xixi-2380/fpga-instrument/README.md

# 高山流水 FPGA 乐器：main 整合

已整合32声部、36键、立体声与效果器、触屏箜篌、蓝牙MIDI/Flash曲库、四主题动画彩蛋、中英文、FFT及延迟XY。新增末级音频滤波，修复输入禁用后NoteOff排空；第二旋钮控制音量，超声波控制滑音。

功能和操作见[整合说明](docs/main_integration_20261101.md)。本源码检查点已完成行为回归及高云综合，完整布局布线/时序优化仍在进行，尚无匹配本次源码并通过完整STA的位流。历史位流不能替代本次验收。

工程：`keyboard_adsr.gprj`，器件GW5AST-LV138FPG676AC1/I0（C），69管脚。综合报告与功能证据位于`reports/integration_20261101/`。默认上电不自动演奏。
