xixi-2380/fpga-instrument/docs/hardware_checklist.md

# 实板核验与首轮测量

状态必须区分官方资料、用户确认、工具检查和实测。历史 JTAG 扫描成功，ID=0x0001081B；该 ID 不区分 B/C。本次没有访问 JTAG，当前无声排查先按 bringup_run_leds.md。
FPGA C 版由用户确认。用户背面原图的白色贴纸清楚标注 Version: v4071f3，Dock 修订据此记录为 4071f3；核心板修订号和速度等级仍不可读。C 版与 PCB 修订号分开记录。照片原件及哈希保存在 reports/hardware/photos。

| 项目 | 当前状态 | 完成标准 |
|---|---|---|
| FPGA 型号与器件版本 | GW5AST-LV138FPG676A、Device Version C，用户确认 | 已与工程器件系列及封装核对一致 |
| 速度等级 | C1/I0 为离线构建假设，实物未核实 | 不将基础型号确认自动视为速度等级确认 |
| Dock 修订号 | 4071f3，背面版本贴纸确认 | 已匹配官方 4071f3 图纸；不代替连线与电压实测 |
| 核心板修订号 | 未确认，组装状态照片不可读 | 可用购买资料或厂商依据补充；无需为此拆散热片 |
| 50 MHz/P16 | 官方图依据，未实测 | 核验版本，记录频率和探测位置 |
| BCK E22/WS F24/DIN G24 | 官方 CST + 图纸一致，未实板签核 | 对应实板版本确认 |
| PA_EN H17 | 已匹配实物版本贴纸与官方 4071f3 图 | 核对对应版本、功放 EN 极性 |
| U4 复位 | 官方全 CST 为 LVCMOS15、图中按下高有效 | 验证按键电平，不套音频例程 3.3 V 设置 |
| 电源/IO | 官方音频图 3V3A | 供电、Bank 电压、接地匹配 |
| JTAG | 已扫描到 1 个器件 | 原始日志在 reports/hardware |
| BCK/WS/DIN | 未测 | 1.536 MHz、48 kHz、16 位/声道、无一位延迟 |
| 模拟输出与左右声道 | 未测 | 低幅 440 Hz、左/右独响一致 |
| 30 分钟稳定播放 | 未测 | 记录失锁、欠载、杂音和复位恢复 |

## 下载前

先核对实板版本及完整器件，生成正式 CST、源同步音频输出约束并完成 P&R/STA。
取得对应证据后才能填入 hardware_status.json 的签核项。助手不调用下载器，旧自动下载脚本已清除，由用户自行操作。
只使用 SRAM Program and Verify，不写 Flash，不改板载调试器固件。
离线可行性构建没有已签核 CST，自动分配引脚的 bitstream 绝不能下载。

## 测量顺序

1. 从匹配原理图识别 GND 和可达探测位置；不假定测试点编号。
2. 功放关闭时检查 DAC 引脚处 BCK/WS/DIN，核对电平、边沿和 16 次采样/通道。
3. 连续零码后使能功放，确认模拟输出无异常，再播放低幅正弦。
4. 先双声道同音，再左独响和右独响，核对最终插座通道。
5. 在播放期间复位，观察静音、重锁和帧边界恢复。
6. 连续播放至少 30 分钟，保存时间、仪器精度、测量结果和 bitstream SHA-256。

PT8211 是 Japanese/LSBJ：WS=0 右、WS=1 左，MSB 先行，BCK 上升沿采样。
官方例程的通道注释与芯片手册不一致，本工程依手册实现，仍需左右实测。
当前已有矩阵键盘 Note 输入；历史固定音测量不能证明演奏响应，实板输入到模拟输出延迟仍待测量。
