xixi-2380/fpga-instrument/docs/handoff_2026-10-14.md

# Tang Mega 138K Pro FPGA 电子乐器项目交接

更新时间：2026-10-14。用途：交给新的 Codex 窗口，继续当前工程开发和无声排查。

## 1. 新窗口先了解的现状

项目目录：`E:\gowin\fpga-instrument-mega138k-pro`。

当前工程：`keyboard_adsr.gprj`；顶层：`keyboard_top`；最新源码版本：`D2_keyboard_leds`。

此前 D1 固定 440 Hz 正弦实验，用户反馈“正常发声”。之后接入 4×4 矩阵键盘和单声部 ADSR 的 D2 实验，用户反馈烧录后没有反应、仍没有声音，原因尚未查明。用户目前不在实验室，暂时无法提供测量结果。

最新工作是加入独立流水灯和两个状态灯，便于回实验室后区分参考时钟、音频复位、按键识别问题。源码、约束、工程和操作文档均已修改，相关仿真通过；**最新版本未由助手综合、布局布线或烧录，也没有新生成的 .fs 文件，尚无流水灯实板结果。**

下一步先由用户编译、烧录流水灯版，反馈 LED 状态，再继续定位无声问题。当前不要跳到 32 声部、复杂音色或 UI 开发。

## 2. 用户明确规定的分工

用户原话：“停，你修改文件后由我进行烧录”“综合编译烧录交给我就行”。

- 助手可以修改 RTL、约束、脚本、文档，运行 Icarus/vvp 纯 HDL 仿真，读取已有综合和时序报告。
- **综合、EDA 编译、布局布线、下载、烧录由用户执行。未经明确重新授权，助手不得启动这些操作，也不得访问 Programmer/JTAG。**
- 用户说“继续”不代表重新授权上述操作。工程内存在构建和下载脚本，不代表允许助手执行它们。
- 不修改官方参考文件、原始照片、旧日志或同步资料，不以新结果覆盖历史证据。
- 缺少实测依据时明确注明待验证；不能用仿真成功代替硬件、时序或延迟验收。

先读项目根目录 `AGENTS.md`。ChatGPT 镜像目录下 `sources/` 也只读。

## 3. 开发环境与资料

| 项目 | 位置或说明 |
|---|---|
| 实际工程 | `E:\gowin\fpga-instrument-mega138k-pro` |
| Gowin IDE | `C:\Gowin\Gowin_V1.9.12.04_x64\IDE\bin` |
| Python | `D:\py\python.exe` |
| Icarus/vvp | 工程 `tools\mingw64\bin`，仿真脚本负责调用 |
| 竞赛原要求 | `E:\FPGA竞赛\竞赛要求`，前期已读取 6 张图片 |
| 旧参考工程 | `E:\gowin\fpga-instrument`，保留供参考，不作为当前工程 |
| 官方资料 | 当前工程 `references\` |
| 硬件原始照片 | `reports\hardware\photos\` |

若写入 E: 受到沙箱限制，应走工具的受控权限流程；不要因此改写同步参考资料，也不要扩大到构建或下载操作。

## 4. 硬件身份及确认程度

- 开发板：Sipeed Tang Mega 138K Pro Dock。
- FPGA：用户确认 `GW5AST-LV138FPG676A`，Device Version **C**。
- Dock：用户背面照片贴纸为 **v4071f3**，已匹配官方该版原理图。
- 核心板 PCB 修订号尚未确认；芯片散热片遮挡完整丝印，实际速度等级未确认。
- 工程器件配置 `GW5AST-LV138FPG676AC1/I0` 是当前离线实现假设，不能声称已核对实板速度等级。
- 用户有示波器、耳机，已连接 4×4 矩阵键盘；没有报告其他 FPGA 外设。
- 历史 JTAG 识别记录存在，ID `0x0001081B` 本身不能区分 B/C。后续助手不进行扫描或下载。
- 听到 D1 声音是用户反馈，不等于已有完整的数字接口、IO 电压、模拟幅度和长期稳定性测量。

主要原理图：`references\TANG_MEGA-138K_Dock-4071f3__Schematics.pdf`。六颗普通 LED 依据该图第 15 页；不要猜测引脚。

## 5. 最新接线定义：务必采用修正后的行列

用户后来澄清：**W26 是最上方第一条水平行；W25 是最左方第一条竖直列。** 早期定义曾相反，源码约束和映射测试已修正。

| 索引 | 水平行：从上到下，输入上拉 | 竖直列：从左到右，扫描输出 |
|---|---|---|
| 0 | W26 | W25 |
| 1 | L22 | M24 |
| 2 | Y26 | Y25 |
| 3 | AA25 | AA24 |

选中列输出低，其余列高阻；行输入两级同步。不要把未选列改成主动输出高。键盘为无源八线矩阵，用户确认没有每键二极管。矩形歧义采用保守处理：清除接受键状态、释放音符，解除歧义并消抖后恢复；不承诺任意多键无冲突。

位置到音符的分配如下，以用户定义的上/下/左/右为准，不根据键帽字符猜位置：

| | 第 1 列 | 第 2 列 | 第 3 列 | 第 4 列 |
|---|---|---|---|---|
| 第 1 行 | C4 | C#4 | D4 | D#4 |
| 第 2 行 | E4 | F4 | F#4 | G4 |
| 第 3 行 | G#4 | A4，440 Hz | A#4 | B4 |
| 第 4 行 | C5 | C#5 | D5 | D#5 |

A4 在第三行第二列，对应 **Y26 行、M24 列**。

当前仅有一个声部：新按键优先；同帧多个新增键选最高键号；松开当前键时回退到仍按住的最高键号；全松开进入 Release。未按键时本来就应静音。

## 6. 音频、复位和测量引脚

| 信号 | 实际板级球位 | 已加入的通用 GPIO 镜像 |
|---|---|---|
| 50 MHz 参考时钟 | P16 | 无 |
| 用户复位，高有效 | U4，LVCMOS15 | 无 |
| PT8211 BCK | E22 | U22 |
| PT8211 WS | F24 | V19 |
| PT8211 DIN | G24 | W20 |
| PA_EN | H17 | U26 |

GPIO 镜像是用户指定的排针位置，便于示波器测量；原 DAC 引脚仍正常连接。地夹接明确标注 GND 的位置，不能把同排其余孔当作地。

当前实际时钟方案是 **50 MHz → 32 MHz → 61.44 MHz** 两级 PLL，以 `config\synth_config.svh` 和 `boards\mega138k_pro\pll_pair.sv` 为准。早期计划中的 50→96→61.44 MHz 已不是当前实现，不能照搬。

- 48 kHz 标称采样，每帧 1280 个音频主时钟周期。
- BCK 1.536 MHz，主时钟每 20 周期翻转一次；每通道 16 位，每立体声帧 32 位。
- 内部使用主时钟和时钟使能；BCK 只是寄存器输出，不作为内部组合派生时钟。
- PT8211 使用 Japanese/LSBJ 格式，16 位补码、MSB 先行、BCK 上升沿采样；WS 低为右声道，高为左声道。不要误改成带一位延迟的 Philips I²S。
- DDS 32 位相位，4096×16 有符号正弦 ROM；440 Hz 频率字 `32'h0258BF26`。
- 初始峰值增益 1/32。PLL 锁定资格判断至少 2 ms，启动 480 帧零码、功放开启、240 帧淡入。
- ADSR：Attack 10 ms，Decay 100 ms，Sustain 约 70%，Release 200 ms；重按从当前包络值起音。
- 键盘每列 50 μs、整轮 200 μs，切列后等待 10 μs，稳定 15 轮，消抖约 3 ms。

## 7. 新增流水灯的行为和工程入口

打开 `E:\gowin\fpga-instrument-mega138k-pro\keyboard_adsr.gprj`，顶层 `keyboard_top`。建议先关闭再重新打开 IDE 工程，使新增源文件和输出配置载入。

当前输出基名为 **D2_keyboard_leds**，用户编译后预期文件：

`E:\gowin\fpga-instrument-mega138k-pro\impl\pnr\D2_keyboard_leds.fs`

该路径是预期输出，不能据此认为已有新文件。旧 `D2_keyboard_adsr.fs` 不包含流水灯和最新源码变更。旧文档 `docs\bringup_keyboard.md` 某些段落仍使用旧输出名，当前以 `docs\bringup_run_leds.md` 和工程配置为准。

| 普通橙色用户灯 | 球位 | 含义 |
|---|---|---|
| LED0 | J14 | 与 LED1～3 轮流亮 |
| LED1 | R26 | 同上 |
| LED2 | L20 | 同上 |
| LED3 | M25 | 同上 |
| LED4 | N21 | 音频复位解除、音频域就绪时亮 |
| LED5 | N23 | 音符门控有效时亮 |

全部低电平点亮。LED0→1→2→3→0，每颗 250 ms，一圈 1 秒，直接使用 50 MHz 参考时钟，独立于音频 PLL、用户复位、键盘和功放。重新配置或上电从 LED0 开始；按用户复位也继续流水。

LED4/5 分别通过两级同步进入参考时钟域。LED5 不是音量指示灯，松键后可以灭，而 200 ms Release 尾音仍在播放。这里不是 POWER/DONE/READY 指示灯，也不是 WS2812。

官方通用全引脚 CST 对 LED0/1 的名称顺序与 4071f3 原理图相反；本实现按匹配板版的原理图，**LED0=J14、LED1=R26**。不要仅为对齐旧全引脚 CST 名称而换回去。

## 8. 已完成的仿真与证据边界

| 检查 | 已有结果 | 不能证明的内容 |
|---|---|---|
| 流水灯独立 TB | PASS，111 项检查 | 实板运行、实现后时序 |
| 最新板级 `tb_keyboard_top --vendor` | PASS，329180 项检查 | 实际晶振、实际 PLL 布线和电气 |
| 物理键盘引脚开关模型 | 当前/旧方向各 PASS 34 项 | 真实线序、接触、上拉电平 |
| 历史 D2 综合网表功能仿真 | PASS，22112 次串行帧检查 | 测试旁路 PLL，不能证明实板 PLL 工作 |
| 历史生产扫描参数延迟仿真 | 首个非零串行码约 3.135 ms | 实板输入到模拟输出延迟 |

行列转置模型显示：旧方向仍可产生按键与音频，只是音符位置转置。因此不能宣称“修正行列已经解决完全无声”。

已有旧 D2 综合/布局布线报告保留作历史证据；最新修正行列及流水灯版尚未实现，不得沿用旧资源/时序报告作为新源码通过证明。最新板级 24 个物理端口位的球位唯一性检查通过。

只运行仿真时可在工程根目录使用以下命令；不需要也不要自动执行构建脚本：

```powershell
Set-Location -LiteralPath 'E:\gowin\fpga-instrument-mega138k-pro'
& 'D:\py\python.exe' scripts/run_sim.py --test tb_run_leds
& 'D:\py\python.exe' scripts/run_sim.py --test tb_keyboard_top --vendor
& 'D:\py\python.exe' scripts/run_keyboard_pinmap.py
```

按改动范围补跑独立模块 TB。已通过且源码未变化的测试无需反复重跑。

## 9. 回实验室后的排查顺序

由用户确认重新编译的是上述工程、顶层和输出名，检查实现报告并保存下载校验日志，然后逐步记录：

1. **四灯是否每 250 ms 循环。** 不循环时先核对实际烧录文件、下载结果、供电和参考时钟，不能直接认定键盘模块故障。
2. **LED4 是否亮。** 流水正常但 LED4 始终灭，优先查复位输入、PLL 锁定及复位释放。
3. **单按 A4 时 LED5 是否亮。** LED4 亮但 LED5 不亮，查实际行列接线、列扫描和行输入；不按键时 D2 静音是预期行为。
4. **LED4/5 都亮但仍无声时测音频。** U22 应有 1.536 MHz BCK，V19 应有 48 kHz WS，U26 启动后应高，W20/DIN 应随按键产生非零数据。继续查 DAC、功放及模拟输出。
5. 如需测键盘，行 W26/L22/Y26/AA25 空闲应高；按住第一行第一列时观察 **W26**，应出现约 50 μs 低脉冲，周期约 200 μs。W25 是第一列扫描输出，不能再按旧文档当成第一行输入。

用户暂不在实验室时，完成可独立进行的文件核对和仿真即可，保留硬件待办，不编造测量结果，不提前要求其立刻操作。

若回退 D1 固定音验证，保留当前键盘和流水灯工程，不覆盖历史已知可发声版本；综合和下载依然由用户执行。

## 10. 关键文件索引

以下均相对于实际工程根目录：

| 文件 | 用途 |
|---|---|
| `AGENTS.md` | 操作权限和工作规则 |
| `docs\bringup_run_leds.md` | 最新用户上板操作说明 |
| `bringup\README_manual.md` | 当前流水灯版操作说明副本 |
| `docs\bringup_keyboard.md` | 键位、ADSR、扫描说明，输出名有历史旧值 |
| `boards\mega138k_pro\keyboard_top.sv` | 当前板级顶层 |
| `boards\mega138k_pro\keyboard.cst`、`keyboard.sdc` | 最新引脚和时序约束 |
| `impl\keyboard_adsr_process_config.json` | Gowin 过程配置，输出名 D2_keyboard_leds |
| `rtl\run_leds.sv`、`config\run_leds_config.svh` | 新增流水灯和周期参数 |
| `rtl\matrix_keypad.sv` | 扫描、同步、消抖、鬼键处理 |
| `rtl\mono_note_control.sv`、`adsr_envelope.sv` | 单声部 Note 选择和包络 |
| `rtl\keyboard_core.sv` | 按键到音频集成 |
| `config\synth_config.svh`、`keyboard_config.svh`、`keyboard_notes.svh` | 时钟、位宽、扫描、包络和频率表 |
| `rom\sine4096.hex` | 正弦 ROM 初始化 |
| `reports\keyboard\run_leds\validation.json` | 最新流水灯仿真、引脚表和源码哈希 |
| `reports\keyboard\pinmap_correction\` | 当前/历史方向的物理开关仿真证据 |
| `reports\keyboard\netlist_check\` | 历史网表仿真证据，PLL 旁路 |
| `reports\keyboard\diagnosis_2026-10-14.md` | 无声排查记录，末尾已说明行列更正 |
| `boards\mega138k_pro\hardware_status.json` | 用户反馈、权限与硬件待验证状态 |
| `docs\change_log.md`、`interfaces.md` | 变更和后续接口约束 |

状态 JSON 中某些保守验证字段仍为 false，属于没有仪器证据的项目；某些 profile 字段保留历史名字。不要据此忽略 `user_D1_report=正常发声`，也不要把用户听感扩大为完整验收。当前源码版本看 `latest_source_variant=D2_keyboard_leds`。

## 11. 项目最终目标及后续阶段

最终比赛目标是纯可综合 Verilog/SystemVerilog 实时音频链路，不依赖 CPU、软核或外部 MCU 进行实时合成。要求 48 kHz、32 个独立逻辑声部、每声部相位/频率/ADSR/音色、固定时隙混音和饱和输出，至少 2 种音色、目标 6 种，PT8211 输出，动态分配和 Note On/Off，输入到输出不超过 10 ms、目标低于 5 ms；竞赛原图还要求至少两个独立演奏维度。

目前完成的是单正弦和单声部键盘实验，**尚未完成 4/32 复音、多音色、FM、效果器或多维控制验收**。配置里 `VOICE_COUNT=32` 只是未来统一参数，不等于已经有 32 声部实现。

无声基础问题解决并取得实板证据后，再按 4 声部→32 声部→多音色→效果器→扩展控制/显示推进。保持 32 位相位、12 位波表地址、24 位声部、40 位混音、16 位 DAC 接口；32 声部调度应满足 `32 × slot_cycles + overhead ≤ 1280`。模块采用清晰握手，跨域使用可靠同步或原子握手/FIFO，禁止组合派生时钟和实时浮点，每模块有独立 TB，修改记录功能、接口、仿真与已知问题。

## 12. 可直接发给新窗口的启动指令

> 请先读取本交接文档及 `E:\gowin\fpga-instrument-mega138k-pro\AGENTS.md`，继续当前 Tang Mega 138K Pro C 版工程。当前键盘 D2 仍无声，最新 D2_keyboard_leds 已加入流水灯并通过仿真，尚待我自行编译和烧录。综合、布局布线和烧录全部由我负责，你只能改文件、运行 HDL 仿真和读取报告。沿用修正后的行 W26/L22/Y26/AA25、列 W25/M24/Y25/AA24。先核对现有状态，再根据我提供的流水灯、LED4/5 和测量结果定位无声，暂不扩展复杂功能，也不要声称已解决。
