xixi-2380/fpga-instrument/android/README.md

# PCB / Flash诊断App 0.3.3

本次APK为`GaoshanScore-0.3.3-pcb-flash-debug.apk`，versionCode6，保持原开发证书。生产RTL同时更新后，空闲诊断实际刷新Flash，SAVE/DELETE重新探测，任务等待180秒，RAM完成与Flash持久确认分开显示。实际手机无线/硬件擦写验收仍由用户执行。

本地SDK现位于本副本`android/build-local/sdk`，JDK17位于`android/build-local/jdk17`。从工程根目录运行`python android/build_apk.py --sdk-root android/build-local/sdk --out-dir android/build-local/pcb-flash-debug`；先把该JDK的bin加入当前进程PATH。保持输出目录里的开发密钥以兼容已有App。SDK、JDK和密钥均只在本地忽略目录，不提交Git。

完整交付见`dist/pcb-flash-debug`及`docs/PCB与Flash修复_2026-10-28.md`。

---

2026-10-27 新增 0.3.1-flashdiag（versionCode 4），与0.3同签名：增加“读取Flash诊断”与准确的RAM/Flash分阶段错误，详见[Flash检查记录](../docs/flash_link_2026-10-27.md)。下方0.3等记录是历史。新包路径 dist/GaoshanScore-0.3.1-flashdiag.apk。

# 高山流水曲谱 · 安卓开发版 0.3

2026-10-25本地扩展：`dist/GaoshanScore-0.3-dev.apk` 沿用0.2签名、版本号3。保留“连接模块”和“验证FPGA”两个入口，增加16声部/4096条能力检查、32首琴端目录及保存/加载/删除/任务查询。新包仅完成软件测试和构建签名，未做手机运行或真实Flash验收；下方0.2的用户实测反馈属于旧检查点。

下载流程先完成RAM COMMIT，再在曲库已初始化且可写时自动保存到选定编号，替换该编号旧曲；分别显示“RAM已校验”“正在保存Flash”“已持久保存”。未知/受保护Flash或旧固件只下载RAM并明确断电不保留。旧固件0x40未知命令后会话仍可用。保存任务可停止等待，但不能把已发起的Flash任务说成已取消。

新增曲库区可刷新32项目录、保存当前RAM、加载与删除选中项；加载不会自动播放。删除先确认，所有存储操作须停止播放。若任务应答丢失、断线或关闭App，会在本机私有SharedPreferences保留最近未完成任务的模块标签（含地址）、任务号或发送意图、操作/编号/CRC；重连原模块后查询。已知完成/失败后清除此记录；FPGA复位或任务替代可能明确返回结果未知，须核对目录。不会自动重发一个新任务来猜结果。

手机仍无INTERNET权限，不上传诊断，不持久存储导入MIDI或完整曲库。上述未完成任务标识是相较0.2新增的本地持久数据；下方旧“不保存蓝牙地址”的描述仅属于0.2。离线演示仅为手机内参考模型，模拟曲库关闭后不保留，不证明FPGA或Flash通过。

操作、引脚、MIDI示例与完整新协议见[曲库上板操作](../docs/bluetooth_score/曲库上板操作.md)、[曲库扩展协议](../docs/bluetooth_score/曲库扩展协议.md)。0.2 APK和以下历史说明保留，用于旧固件与问题追溯；当前使用0.3请以上述新增流程为准。

本机重编译沿用0.2密钥的实际命令为 `python android/build_apk.py --sdk-root android/build-local/sdk --out-dir android/build-local/connection`（工程根目录执行）；密钥只在本机忽略目录中保留，不随源码/APK分发。新0.3已完成36043项核心、32项连接和33项曲库/示例软件检查，签名及哈希见reports/library_integration/validation.json；这些不是Android运行验收。

## 0.2历史交付记录

本目录移植自原手机端开发项目。本轮按用户确认合并实施P0/P1，并将“仅连接蓝牙模块”和“验证FPGA通信”分成两个手动验证入口。APK已重新构建，36043项核心检查与32项连接生命周期检查通过。随后用户已确认实际连接、通信、MIDI文件下载播放、暂停和停止正常；这是用户定性反馈，不覆盖继续、自然结束、断线或长期验收。当前FPGA已接入v1协议，工程边界见[实施说明](../docs/bluetooth_score/实施说明.md)。

## 先验证连接与握手

1. 安装 `dist/GaoshanScore-0.2-dev.apk`。新开发签名与旧0.1不同，需要先卸载旧版再安装；旧版不保存用户曲谱库。新签名密钥保留在本机忽略的build-local/connection目录，不对外分发。
2. 允许附近设备权限；本版会停止系统蓝牙发现以减少建连干扰，但不主动扫描周边设备。若仅授权连接，也会提示跳过停止扫描并继续尝试。
3. 第一步点“连接蓝牙模块”，选择已配对模块。默认先安全RFCOMM，失败并关闭旧Socket后尝试insecure兼容连接，每次最多12秒。也可在连接方式中单独选择一种模式作对照。
4. 界面显示“模块已连接 · FPGA尚未验证”后，先观察模块实际连接状态、保持、断开和重连。这一步不会发送HELLO或其他应用层协议字节，不以FPGA应答作为连接成功条件。
5. 第二步手动点“验证FPGA通信（HELLO）”。正确HELLO后再GET_STATUS，显示设备能力和真实状态，随后开放下载/播放控制。
6. HELLO失败但Socket仍正常时保留模块连接，可再次点击验证；真正EOF、读写失败或连接关闭则显示未连接，并关闭设备操作入口。不会无限自动重试或把握手失败冒充建连失败。
7. 若仍不能连接，点“复制诊断记录”。记录包含版本、设备、连接模式、阶段、时间、异常以及握手TX/RX摘要；详细异常堆栈同时写入Gaoshan-SPP的Android日志。记录仅本地展示/复制，不上传。

用户已确认当前 App 可以连接模块并完成通信与曲谱下载。连接/断开10轮和异常恢复仍属后续验收；测试时先关闭其他串口软件对该模块的连接。

## 当前交付

`dist/GaoshanScore-0.2-dev.apk` 是当前开发版，声明最低Android8.0/API26，target35；已完成Java编译、D8转换、资源链接、对齐及v2/v3签名校验，并获用户上述实测反馈。旧 `GaoshanScore-0.1-dev.apk` 保留作为历史产物，不是本轮交付。

助手未操作手机、接线或烧录；以下为当前操作说明。历史构建报告中的“尚未真机测试”保留其生成时状态，以本页后续用户反馈区分。

## 手机界面与操作

1. 可以先点“离线演示”。顶部明确显示“离线演示 · 未连接FPGA”；能力来自手机内参考模拟器，不是实测。
2. 点“三音符示例”，得到C4/D4/E4、力度100、时长1900ms的黄金曲谱；或者用系统文件选择器导入.mid/.midi。
3. 导入后选择全部或单一轨道、全部或单一通道、-48～+48半音移调；点“应用筛选与移调”。无需输入电脑路径。
4. 查看音符数、时长、最大同时发声数、MIDI音域、数据大小、CRC32。遇到被忽略控制器时会显示“简化演奏”提示，并在下载确认中列出。
5. 点“下载到琴”，确认替换原曲。进度只随确认的记录数前进；100%数据已传不等于完成，COMMIT与时长核对后才显示成功。
6. 播放/暂停/继续/停止后查询一次设备状态；也可点“刷新设备状态”。查询间隔至少500ms。暂停的实际行为由FPGA实施，模拟模式只演示协议状态。
7. 离线演示不通过Android音频系统发声，不驱动FPGA；它不是音质试听或链路测试。

## 后续真实连接

- 在系统设置中配对经典蓝牙SPP模块，再点“选择蓝牙设备”；App不扫描周边设备，不要求位置权限，不支持BLE串口。
- Android12及以上按系统提示授予“附近设备”连接与扫描控制权限；扫描权限用于cancelDiscovery，不启动设备发现、不申请定位。拒绝连接权限后可用离线演示，也可在系统设置修改权限。
- 固定SPP UUID 00001101-0000-1000-8000-00805F9B34FB；模块固件是否提供该服务仍需实物确认。
- 手机SPP没有UART波特率设置；模块已由用户确认数据模式9600bit/s，FPGA UART须相同。HELLO显示FPGA报告的配置，不自动发送AT指令。
- “真实蓝牙 · HELLO已确认”只会在完整HELLO成功后出现。本分支 FPGA 已实现 HELLO/下载/播放，生产配置声明 1024 条记录、1 个自动声部；用户已确认 EC05 实际连接及通信正常，协议仿真本身不代表无线连接成功。
- App当前面向前台使用，无前台服务或后台持续传输承诺。关闭Activity将关闭socket；重新连接必须HELLO并从头上传。
- 如中断时设备仍在上传，固件须按协议30秒清理，或下次HELLO立即清理；手机不能假装已经恢复旧曲。

## MIDI支持边界

- 标准MIDI Format0/1、PPQN；默认500000μs/四分音符；Format1全局合并速度图，筛选轨道仍保留全曲速度图。
- 支持变长delta、running status、Note On/Off、velocity0结束、通道+音高FIFO配对的同音高重叠。
- 以整数精确累积速度/时间，开始和结束分别取最近毫秒，0.5ms向上；按起音时间排序，相同起音保留原先稳定次序。
- 支持全部或单一轨道、全部或单一通道；暂不支持任意多选组合或自动提取主旋律。
- 忽略踏板、弯音、程序/表情等控制，检测后必须确认简化；不宣称还原原MIDI音色。
- 拒绝Format2、SMPTE、缺失配对、非法长度、冲突速度、舍入后零时长、音符超过65535ms、协议总时长/音域超限等；不静默截断或丢音。
- 文件最大2MiB，音符/速度事件最多100000；设备容量来自HELLO，不能将模拟器的1024条/4声部/MIDI48～83当成实板能力。
- 不支持PDF、图片、MP3识谱、在线曲库或账户系统。歌曲名留在手机，不通过v1传输。

## 协议实现

纯Java核心位于app/src/main/java/cn/whu/gaoshan/core。
Wire负责小端帧、CRC16/CRC32、拆帧/粘帧与超时；ProtocolClient负责HELLO、停等序号、最多4次相同请求、响应匹配、16记录分包、ABORT与播放命令；Score负责容量/音域/最大重叠检查；MidiFile负责转换；SimulatedDevice只用于离线参考演示。

只有一条后台工作队列可以提交命令。接收线程持续读socket，4096字节队列溢出或EOF明确使会话失败。写入看门狗10秒、连接超时15秒；响应每次2秒，最多4次发送。断开按钮直接关闭socket，不等待工作队列。
错误业务响应消耗普通序号；SEQ_CONFLICT/版本/内部错误及响应耗尽会使协议会话失效，须重新HELLO；蓝牙链路仍正常时可点第二步重验，真实链路故障才需重连。改参数不能复用旧SEQ。取消在当前帧完成后发ABORT，通信失败时不谎报已取消琴端事务。

模拟器不是完整FPGA规范实现：它没有UART采样、RF链路、30秒上传超时、真实ADSR尾音或真实音频，也不证明GPIO/CDC/STA正确。

## 源码编译

方式A：Android Studio打开本android目录，安装Platform35和相应SDK，使用JDK17。项目AGP8.7.3、Gradle8.9，wrapper来自Gradle官方v8.9.0，首次使用需联网获取工具依赖。

```text
Windows: gradlew.bat assembleDebug
Linux/macOS: ./gradlew assembleDebug
```

本次实际交付APK采用方式B构建，未在此环境完成Gradle/Android Studio构建。构建实际使用javac8编译Java8源码、Java21运行D8和签名器；Platform35_r02与Build-tools35.0.0来自Google官方仓库并按仓库SHA1校验。构建日志、工具路径及源码/APK哈希见 `reports/android_connection`：

```text
python build_apk.py --sdk-root 你的AndroidSDK路径 --out-dir build-local
```

方式B要求JDK17、Platform35、Build-tools35.0.0；仅使用javac/D8/aapt2/zipalign/apksigner。路径作为独立参数传递，支持带空格路径。
生成开发测试签名，私钥保留在本机build-local，不随包发送。自行重编译签名不同时需要卸载旧开发包再安装；该包不是商店发布或正式签名版。

## 软件验证

```text
python run_core_tests.py --out-dir ../reports/bluetooth/local_android_core
```

需要可用JDK，不需要Android SDK。包含36043项核心检查：CRC、黄金请求、0～256载荷及各分界、坏帧/超时、MIDI变速/重叠/筛选/舍入、设备约束、1024音符64包上传、BEGIN/DATA/COMMIT/PLAY确认丢失后的重传去重、取消/暂停/重新HELLO。另有32项连接状态检查：连接零协议字节、单独HELLO、握手失败保留连接、重验成功、安全失败兼容回退、强制模式、取消/超时、过期Socket和回调、真实链路故障通知；使用假传输，不证明Android蓝牙栈兼容性。
参考模拟器与真实ProtocolClient运行端到端软件测试，但没有运行安卓Activity或手机权限流程。APK签名/清单核验也不是安装或真机测试。

## 无网与隐私

App不声明INTERNET权限，没有广告、分析、云上传或在线曲库。用户通过系统文件选择器选定MIDI；不申请全盘存储权限。本版不持久化用户文件、蓝牙地址或上传进度。
# 2026-11-02 鼓键与锣声近似

新增 `android/dist/GaoshanScore-0.5-percussion-20261102.apk`：默认保留第10通道，接受GM1的47个鼓键并规范化到琴端原有10种鼓音；可选52中国镲+41低鼓的双层锣声近似，默认关闭。旧固件无需新增音色ID或资源。它不是47种独立采样，GM1也没有专用锣键；完整映射、示例、复音限制及签名安装限制见 [GM鼓与锣声近似](../docs/bluetooth_score/GM鼓与锣声近似.md)。

本机使用 `D:/PyCharm 2025.2.4/jbr/bin` 的JDK，以及本工程 `android/build-local/sdk` 的官方Android35平台和35.0.0构建工具。生成命令为 `python android/build_apk.py --sdk-root android/build-local/sdk --out-dir android/build-local/percussion-20261102 --version-code 8 --version-name 0.5-percussion-20261102`；先给PATH加入该JDK。可用 `--keystore <原有开发私钥>` 保留升级签名。本次旧私钥未找到，新APK使用独立开发证书，不能直接覆盖安装旧0.4。没有执行安装或卸载。

核心与FPGA兼容回归入口为 `python scripts/run_power_guard.py -- python scripts/run_percussion_adjustment_tests.py`。生成的示例MIDI在 `android/examples`；证据在 `reports/adjustments_20261101/percussion`。以下保留此前版本说明。
