xixi-2380/fpga-instrument/reports/adjustments_20261101/xy/README.md

# 实板 main 7d84ac3 基线：延迟 XY 独立复核

**结论：当前没有复现出 `lissajous_plot.sv` 的算法或双缓冲错误，因此未修改生产 RTL。** 本项没有引入旧优化候选，没有改变画面、XY 延迟、时钟或资源结构，没有运行 EDA。

用户尚未提供异常画面或触发步骤。本报告验证的是目前能具体检查的边界，不能据此声称已排除所有实板显示问题，也不把没有复现的问题标为已修复。

## 独立数学参考

新增 `scripts/check_xy_adjustment.py`，使用精确整数比例生成每条线的参考：沿较长坐标轴逐点推进，另一轴按准确比例四舍五入，半格朝本线起点外侧取整。参考没有复用 RTL 的 Bresenham 误差更新，也没有沿用原先仅三幅波形的 Pillow 检查。

| 检查 | 覆盖 | 结果 |
|---|---|---|
| 实际 RTL 线段与写地址 | 64×64 个绝对跨度、四方向共 16,384 条；另加 8,192 条随机平移端点，共 24,576 条/960,419 个绘点 | 2,971,369 项通过，包括字节坐标测试 |
| 原始字节有符号坐标 | 所有 256×256 组输入；检查实际 LOAD 映射 | 65,536 组全部通过 |
| 完整延迟波形 | 64 幅，包括零、正/负满幅、极值交替、正弦、斜坡和 56 幅固定种子随机波形 | 全部与独立 64×64 数学位图一致 |
| 帧/双缓冲/读取 | 在 CLEAR、LOAD、SETUP、DRAW 忙时插入 start/tick；等待帧期间继续读旧前台；同拍发布并启动下一帧；持续随机读取及全图扫描 | 4,495,868 项检查全部通过 |
| 复位、静音与边界 | 五个工作阶段分别复位，重新构建静音；ready 失效、读取关闭、旧 RAM 覆盖及前后台写入隔离 | 全部通过 |

**总计 7,467,237 项检查通过。** 原始 signed-byte 坐标到 `[0,63]` 的转换正确，极端线段不会绕边或卡死；实际最大误差寄存器绝对值为 93，原有有符号 8 位足够。每条线最多 64 个绘点。一次完整构图保持原有 4096 点清理及有界连线过程；没有发现需要增加位宽或 RAM 的理由。

输入波形在 start 时锁存，随后改变输入不会污染正在构建的图。旧前台保持可读，完成的后台只在 frame_tick 发布；同拍发布/start 将旧前台作为新后台。任何可见前台都不会被清理/绘制写入。复位使 ready 失效，新图完成前不会泄漏旧 RAM。零信号被下一幅完整静音图替换为 `(32,31)` 中心单点，不保留前一幅曲线。

## 屏幕连接只读检查

主代理负责屏幕/超声波修改，本项没有改 `rgb_ui_renderer.sv` 或 `rgb_display.sv`。只读检查确认：

- `audio_visualizer` 每四个有效 PCM 采样取一个 signed 高字节，完整快照为 128 点。
- `phase_plot` 接原波形状态 `[1111:88]`，Y 轴比 X 轴早四个快照点，仍等于原单声道 **16 个音频采样**延迟。没有改成 L/R 声道图。
- 普通主题将 64×64 位图放大到 x=376～503/y=170～297，隐藏主题保持 x=680～743/y=172～235。原边界门控和坐标缩放一致。
- 位图像素为同步一拍读出；渲染器在下一阶段叠加到同一坐标的前景色，和既有像素管线相位一致。
- frame-locked 状态桥与绘图模块同拍更新时，绘图可能使用上一份完整波形快照，意味着一帧级观察延迟，不是半帧撕裂或错误坐标。没有据此改变原显示行为。

这些连接检查属于源级审阅；新数学/缓冲测试直接执行了实际绘图模块，不等于重跑整套 RGB/LCD 实板验收。若实板异常仍出现，异常图、对应输入音色/频率和触发页面切换步骤可用于继续定位；当前保留用户已实板成功的实现。

## 文件与复现

- 生产 `src/lissajous_plot.sv` 保持与实板基线逐字节一致，SHA256：`8fb5035e3c956c5154da790bdba16cd0a4ae820ec0da4d0b925a7476c6a8ddad`。
- `validation.json` 记录源码/脚本、测试台及参考输入/位图哈希和执行结果；`review.json` 记录只读连接结论与基线身份。
- 在新 adjustments 工程根运行：`python -X utf8 scripts/check_xy_adjustment.py`。只需要 Python 标准库和现有外部 Icarus，不需要 Pillow、NumPy 或 EDA。
- 测试输出只写 `reports/adjustments_20261101/xy`；没有修改旧项目或旧候选。
