xixi-2380/fpga-instrument/reports/audio_analysis/2026-10-26/README.md

# 2026-10-26 实时分析验证

15项纯HDL配置，共23227101检查全部通过。基线main7e0aaec；源码检查点9f468ea，最终源文件哈希见validation.json。

- NumPy独立FFT8窗口、16936核对，最大实/虚分量误差8.002360751归一化PCM LSB；单音相邻频点、双音、32独立FFT峰、负满幅DC、脉冲、750Hz、零输入。分组/对数打包一致，忙时输入不破坏结果，中途复位后重新完整采集为零。窗口计算耗时记录为[93439, 93439, 93439, 93439, 93439, 93439, 93439, 93439]时钟（非物理时序验收）。
- 独立Pillow完整XY位图32776检查，含旧银行保持、帧边界交换和复位恢复。
- 六幅完整800×480界面，4608399检查：四主题、中英文、实际FFT快照柱高、所有延迟XY端点、完整触摸矩形、帧内冻结、未知像素。预览为仿真布局/测试音，所标音色/按键不是实板测量结论。
- 双真实音源9813828检查，完整84事件曲谱，FFT计算期间切换视图/语言，全部PCM采样和I²S位与LCD关闭对照一致；实测FFT发布跨513位CDC，手动和弦及松键归零。
- 三轮USR共126NoteOn/126NoteOff，手动3on/3off；独立松键23on/23off；参数菜单/曲谱交接无音符泄漏。
- 英伦中文和彩蛋中文各384000个RGB666有效像素：十拍对齐、完整行/帧、原子状态、人物和脚、丢锁/复位消隐。
- 513位CDC、原audio_visualizer、控制器与触摸边界独立回归。
- 原声音/效果/键盘/时钟/CST/主题艺术源码哈希保持，ROM/字库生成幂等；GPRJ全部依赖存在；默认顶层展开和两CWD相对include预处理通过。

不提交可重建的.vvp、PPM、完整浮点参考数组或PCM长向量；参考脚本和哈希足以复现，scripts/run_sim.py自动准备输入并在FFT后做数值检查。上板清单及限制见docs/audio_analysis.md和validation.json。未运行Gowin/P&R/STA/Programmer，实际资源、耗时、时序、音频和触摸均待用户。
