xixi-2380/fpga-instrument/reports/bilingual_ui/2026-10-25/README.md

# 中英文与按键验证

基于main60c9deb。17项纯HDL配置、26841609项检查通过；另有16幅800×480画面共91212个独立字形／标题像素检查通过。

- 控制：S0/S1/S2短长按无功能；不阻塞触摸；S3短按无功能、长按彩蛋一次触发/返回；语言不影响音色/FX/页面/参数。
- 触摸：新增120×44语言命中框、边界、按住/拖动不重复、错误/分辨率/单点保护。
- 渲染：中文8页完整栅格6144053检查；额外单页复核；英文renderer4帧；16幅画面独立检查七个音色卡片、语言按钮、C4字符及抗锯齿标题。ui_bilingual_overview.png对照四主题设置页，ui_bilingual_settings.png为全尺寸中文英伦设置页。
- 音频：双真实音源对照7747368检查，换语言/主题时PCM及每个I²S位一致；完整曲谱84事件；松键23on/23off；3轮重启126on/126off；菜单不产生音符，回演奏须松键重武装。
- 连接器：英伦中文及彩蛋中文各完整384000个RGB666像素、十拍对齐、帧原子状态、丢锁/复位消隐通过。
- 字库：原英文HEX前81920字节与main60c9deb对应Git blob一致；三套真实汉字子集有89字，ROM/头文件生成幂等；新头文件入GPRJ；两种工作目录无额外配置搜索路径的预处理和默认生产顶层展开通过。

首次把8页回归扩大到16页时，旧60ms测试台时限短于61.44ms最低逐像素输入时间，导致测试台超时；已改为100ms。失败预算记录保留development；最终有效回归为中文8页＋单页复核、英文4帧、全部16幅字形比对，不把早期超时写为通过。单页复核也用于重新完整导出预览文件，不代表生产RTL缺陷。

实际音源/ADSR/效果器、GPIO、PLL、50/61.44/35MHz目标、SDC/CST、动画压缩和静态人物图不变；语言位复用快照56，不加像素流水延迟。未运行Gowin/STA/下载；上述不是时序收敛、新BSRAM数、耗时改进或实板验收。见validation.json、static_checks.json、pixel_checks.json。
