xixi-2380/fpga-instrument/reports/bilingual_ui/2026-10-25/development/README.md

初次把画面检查从8页扩为16页后，测试台旧60ms仿真时限短于16×800×480×10ns=61.44ms，因此超时；这是测试台预算问题。已将时限调整为100ms，不改生产时钟或RTL。保留该记录；最终检查结果另见上级目录。
