xixi-2380/fpga-instrument/reports/pnr_optimization/2026-10-25/development/README.md

两次开发编译错误已修正：renderer文字拼接缺空格造成解析错误；测试参考模型的头文件须相对sim目录引用。日志保留供追踪，最终22配置通过。旧报告和原始上传文件未覆盖。
