xixi-2380/fpga-instrument/reports/static_egg/2026-10-25/development/README.md

# 开发中断言记录

rgb565_padding_assertion_initial.log保存一次旧断言失败：RGB565量化后的浅灰边距与ROM区域外的24位浅灰相差少量色阶，不能以两者逐位相等判断是否裁切。已改为检查浅色边距，并对人物衣服与脚部区域进行独立颜色内容检查、对两次全图进行逐像素静态比较。最终测试全部通过；该记录不代表硬件验收。
