xixi-2380/fpga-instrument/reports/release_egg/2026-10-25/development/README.md

# 开发中断言调整

person_roi_initial_assertion.log保留一次图像测试的失败记录。最初断言要求整个x<296区域不变，但新构图的前景脚放大后允许覆盖该区域最右侧少量背景；该断言把合法前景扩展误当成人物移动。现改为验证人物面部和抱臂的固定区域，另用tb_egg_composition检查大图人物区域不变、脚部有限区域变化及脚趾上边距。最终日志见final，不把此开发中断言当成硬件已验证的依据。
