xixi-2380/fpga-instrument/reports/keyboard/diagnosis_2026-10-14.md

# D2 无响应排查：2026-10-14

用户反馈：烧录后没有任何反应。故障尚未定位，不记作已修复。

已完成的只读/仿真检查：
- 已有 P&R 报告中八个键盘球位符合用户接线；四行均为 LVCMOS33、PULL_MODE=UP。
- 已有综合网表中的正弦 ROM 初始化非零。
- impl/pnr/D2_keyboard_adsr.fs 与 bringup/D2_keyboard_adsr.fs 均匹配 D2 原交付哈希；用户实际下载路径尚待提供。
- 对现有综合网表运行 Icarus 功能仿真：A4 扫描状态 0x0200，出现非零串行音频，松开可清除状态；PASS，22112 次串行帧检查。
- 网表测试用行为音频时钟/复位旁路 PLL，行输入采用独立无二极管开关网络模型。它不验证实板 PLL、IO 上拉电气或实际键盘线路。

待用户核对：
1. 是否按下键后仍无声；D2 空闲本来静音。
2. 实际下载文件完整路径及下载校验结果。
3. U22/BCK 是否 1.536 MHz，V19/WS 是否 48 kHz，U26/PA_EN 在启动后是否高。
4. 不按键时行 W25/M24/Y25/AA24 应为高电平；按住第一行第一列时，W25 应有每约 200 us 一次、约 50 us 宽的低脉冲。实际方向以用户接线为准。

本次只新增 netlist 测试和排查记录，未修改功能 RTL，未重新综合、布局布线、烧录或访问 JTAG。
证据：reports/keyboard/netlist_check/result.log、status.json；复现 scripts/run_keyboard_netlist.py。

后续澄清：上述 W25 第一行测点依据旧方向定义。当前修正源码的第一行输入为 W26，第一列输出为 W25。新增物理开关仿真确认旧方向仍能识别但键位转置；完全无声尚待实板定位。
