xixi-2380/fpga-instrument/reports/british_ui/2026-10-23/development_notes.md

# 开发与验证边界

- 本轮纯RTL/静态检查，不启动Gowin、布局布线、Programmer或JTAG；PLL顶层集成使用独立行为时钟模型，不等同官方PLL或STA。
- 最初新增波表TB中的小数漏写前导0导致Icarus语法错误，已修正后完整重跑；未计入最终通过记录。
- 初版常规字形生成将文字向上偏移2像素，预览发现上部笔画不全；按真实字体bbox修正字形并采用清晰粗体，随后重新渲染四帧和连接器帧。
- 1112位CDC首跑失败源于旧TB的测试图样仅80位，超宽切片引入X；将测试图样扩为覆盖参数WIDTH的重复互补字段，再跑1112/71位通过。CDC生产源码未改变。
- 复查时补齐同ID在旧/新包络间重触发的当前幅度衔接；ADSR可选seed端口、独立跨包络测试及受影响的集成回归已完成。旧参数路径单独通过，默认小星星hex不变。
- 将进度条精确为300像素，使5%步进及100%端点对应准确长度；新增100%/0%边界像素检查并重跑完整光栅。
- ui_0至ui_3 PNG来自实际RTL光栅的测试场景，波形、触摸READY/ERROR等输入是TB刺激，并非实屏照片。tb_british_top另从真实音源/效果器输出验证波形、峰值、音符图及七音色到像素域；触摸实物仍未跑通。
- 波形显示采用X8视图饱和及抽样，无抗混叠滤波/触发锁定；实际PCM未放大，峰值条基于未放大的全窗。不能据此认定音质、延迟或物理时序通过。
