xixi-2380/fpga-instrument/reports/instrument_ui/2026-10-23/development_notes.md

# 开发与验证记录

早期布局函数名inside与SystemVerilog关键字冲突，已改为ui_inside。第一次曲谱联合验证使用2采样节拍，被原score_player的四分拍配置检查拒绝；改用合法4采样节拍，最终完整84事件通过。最初仿真截图底部提示在y464截断，已扩展文字带并增加底行像素断言；四幅最终预览已逐张检查。增加百分比查表数学断言时的TB宏换行错误已修正并重新通过。

仿真检查各配置只累计一次；CDC宽度20/64/71、顶层LCD关闭/开启是明确不同配置。模型只提供测试用时钟，未声称官方PLL或物理时序。旧音频/显示报告按原SHA继承，不计入本轮通过数。无Gowin或烧录操作。
