xixi-2380/fpga-instrument/reports/effect_parameters/2026-10-22/development_notes.md

# 开发期间失败与修正

1. 初次负满幅向量检测到新增运行时混合权重的无符号传播，输出错误地限幅为正满幅。保留initial_signedness_failure.log；修正为明确32位有符号权重后，短参数及生产参数独立模型全部通过。
2. 初次随机参数向量把Python布尔值写成True/False，HDL十进制解析未前进，导致300秒仿真超时。生成器已输出int(en)，TB对非EOF解析失败立即fatal。超时不是RTL运行时性能或综合结果。
3. 新增深度乘法显式采用17位中间结果，避免小位宽上下文截断；满深度和随机向量覆盖此数值路径。

4. 完整tb_effect_button_path第一次回归在300秒墙钟时限停止，未取得PASS/FAIL结论。当时两份回归任务重复运行同一测试，发生资源竞争；不累计重复检查数。收拢为单任务并增加时限后重跑，最终状态以validation.json及实际日志为准。完整小星星顶层及tb_synth_core此次未另行完成，不能把旧报告计作本轮通过。

5. 为把按钮输入/持音路径与完整渐变数值验证分开，tb_effect_button_path增加QUICK参数，默认0保留原长流程。QUICK=1在效果类型切换前旁路，缩短等待，同时继续检查顶层S3短长按、算法切换、持音、无多余音符、无断流和独立松键；完整生产渐变与非零湿声切换由tb_audio_effects和tb_effect_parameters覆盖。QUICK配置单独计数。

6. 单任务长流程最终PASS tb_effect_button_path，2777630检查；QUICK=1另外通过337950检查。两者按不同配置各计一次，初次并行超时不计入通过。
