xixi-2380/fpga-instrument/docs/main_adjustments_20261101.md

# 实板基线后的调整

基线为main 7d84ac318653fcee17a0d8ece5e9e518ec7e24e2，用户已报告实板跑通。GitHub分支baseline/main-board-tested-20261101和本地F:/FPGA_Projects/main-board-tested-7d84ac3-20261101保存原源码/工程/位流/报告。基线有87个setup违例的历史事实不因实板反馈消失。本轮在codex/main-adjustments-20261101和独立工程工作，不混入已暂停优化候选。

## W25输入检测标记

KEY_INPUT_PROBE为3.3V输出，空闲低；在50MHz参考域首次看到有效、在线AiP5916琴键位图中的新按下边沿后一个参考周期内置高，持续1ms。它位于原有扫描/一致性确认之后、跨域传输和音频排队之前，因此测得的是FPGA确认键盘状态到音频输出的延迟，不包含手指触碰到AiP5916/扫描确认之间的延迟。测量时示波器共地，以W25上升沿触发、另一通道观察实际音频输出。

保持按键不会连续触发，松键不触发；新增任一琴键均触发，包括另一个键已按下时。1ms内重叠事件延长高脉冲，单次延迟测量应间隔大于1ms。三板的AUX4位不参与。菜单/音量0/蓝牙占用不影响标记；它表示输入被检测到，不保证此刻允许手动发声。断线无效状态屏蔽输入，恢复有效后可重新标记。USR复位立即清低。

W25曾用于已退役矩阵列，当前69管脚基线未占用；本次新增后为70个管脚。不能继续连接旧矩阵扫描驱动。其余引脚不变。

## 后续验证

超声波已修复毫米数值错误标为CM的10倍单位错误，距离/端点/回中范围统一为cm；原“响应”改为“回中范围”（DEADBAND），1～5cm表示中心两侧的半宽，值越大原音稳定区越宽。端点仍优先输出±2半音。无回波250ms回到原音，不控制音量。

XY独立检查7,467,237项通过，未复现已确认错误，保持原16采样延迟及RTL；不能声称已修复未复现的实板问题。

W25单元200,240项和真实I2C整机740项通过；官方Gowin原语全顶层编译通过。综合LUT65,163（基线66,702）、寄存器35,653（基线35,621），BSRAM仍309/340，不据此推断布局布线耗时或时序通过。

2026-11-02恢复工作时电脑电池供电，完整PNR尚未启动。新增scripts/run_power_guard.py可在未接电且<=25%时记录并终止自身任务树；未完成PNR不能作为新可烧录交付。最终按真实70管脚、当前源码/网表/位流哈希、全功能回归和完整P&R评价；未经验证不替换main。若资源或P&R耗时明显恶化，保留基线并报告取舍。
