xixi-2380/fpga-instrument/docs/branches.md

> 2026-10-26：main新增硬件FFT频谱与单声道延迟XY。旧四个已合入分支仍弃用；蓝牙、超声波仍独立。操作见[audio_analysis.md](audio_analysis.md)。

# 分支状态（2026-10-25）

以后继续日常开发、下载完整工程，优先使用 `main`。本表的“弃用”表示内容已合入、停止在旧分支继续开发；不删除分支、不改名、不重写历史。GitHub 分支选择框仍显示原名，请按本表判断用途。

以 main `60c9debdec062cfc87d67f81f9841ef9968d7af2` 核对 Git 提交祖先关系：

| 分支 | 状态 | 核对到的分支头 | 说明 |
|---|---|---|---|
| `main` | 当前主线 | 60c9deb（本次变更的基线） | 四主题、触摸、七音色、效果器；本次加入语言切换和新按键规则 |
| `feature/audio-delay-20261019` | **弃用：已合入** | a941443 | 旧回声开发分支 |
| `feature/audio-effects` | **弃用：已合入** | b35cf2c | 旧三效果器及参数接口分支 |
| `feature/instrument-ui` | **弃用：已合入** | 44bebc6 | 旧界面／七音色开发分支 |
| `codex/fpga-migration` | **弃用：已合入** | 386a3dd | 显示／触摸／MAX98357A 整合来源 |
| `feature/ultrasonic-volume` | **保留，未合入** | 60cf5cd | 杨同学的测距音量；基于 b07c0d5，未含主线第二轮时序／ROM压缩。等最终整合时迁移功能 |
| `codex/bluetooth-score-integration` | **保留，未合入** | 2d86834 | 仍有主线不包含的3个提交，不能标记弃用 |
| `codex/bluetooth-audio-output` | **保留，未合入** | a138116 | 仍有主线不包含的3个提交，不能标记弃用 |

前四个旧分支的头提交都是上述 main 的祖先（main 未缺少它们的提交）。两个蓝牙分支都与 main 分叉于 bf5df57，尚未完成整合。此处仅登记，不自动合并、优化或修改它们。
