xixi-2380/fpga-instrument/docs/instrument_ui.md

> 最新增加频谱／单声道延迟XY，底部“视图”切换。操作见[audio_analysis.md](audio_analysis.md)，语言、主题与S3长按规则保留。

> 当前操作以 [中英文与按键说明](bilingual_ui.md) 为准：S0/S1/S2停用，S3只保留长按彩蛋；屏幕支持中英文切换。下文旧按键说明属于历史版本。

> 当前彩蛋已按用户要求改为去字幕人物与脚的静态整图，长按S3入口保持，小猫/卡皮巴拉仍为动画。详见themes.md最新约定。

# 高山流水主题界面与演奏可视化

## 当前版本

本轮在最新main上增加英伦、小猫、卡皮巴拉与隐藏彩蛋四主题。默认英伦，常规循环只有前三者；新增THEME >按钮在两页右下均可用。详细素材、操作与资源说明见[themes.md](themes.md)。中英文切换、屏幕音量调节本轮未做。

当前`main`已整合远端`feature/instrument-ui`最新44bebc6与`codex/fpga-migration`：英伦黑金界面、演奏可视化、七音色、MAX98357A标准I²S和GT9110触摸共同工作。杨金鹏负责的蓝牙不在本轮代码内。

前一版UI获得用户“测试非常成功”的实板反馈；本次黑金版、新增音色、MAX输出和默认启动的触摸尚待重新综合、P&R、STA和实板试听。先前试听、时序报告不覆盖本次版本。UI分支证据在`reports/british_ui/2026-10-23`，最终合并证据在`reports/merge_main/2026-10-23`。

## 两个页面

彩蛋演奏页现将人物与脚完整放在左侧，右侧显示波形、电平和两排音符；其余主题与设置页命中区域保持原布局，见themes.md。

演奏页：真正花体标题 High Mountains, Flowing Water，黑金配色、星座连线、星盘圆弧与金色卷饰；真实后效果器波形、输出峰值条、MIDI60～75（C4～D#5）按住音符高亮，当前音色/效果/声部数及曲谱或现场状态。键形区域是只读监视器，不是屏上弹奏键盘。

参数页：七个音色选择、三个效果选择、独立效果开关、当前强度/深度与颤动速度；回声显示固定150ms，混响显示固定SMALL ROOM。后两项是说明，不可点击调节。英文RESET表示恢复效果默认；RETURN返回演奏，SETTINGS进入参数页。英伦版全英文，若以后做中文版，RESET只译为“恢复”。

英伦标题与栏目名使用整词两位抗锯齿花体遮罩，小猫/卡皮巴拉使用独立正文与标题字形。视频帧转索引ROM，动态背景与正文并行同步读取，采用九级renderer、连接器一级输出寄存，无CPU、无全屏显存、不增加DDR控制器。具体容量和实际综合边界见themes.md；35MHz像素PLL、800×480时序与所有引脚保持。

## 板载按钮

| 操作 | 功能 |
|---|---|
| S0短按后松开 | 选择正弦 |
| S0长按约0.8秒 | 演奏/参数页切换，不改变音色 |
| S1 / S2 | 上一 / 下一常规主题 |
| S3短按后松开 | 效果开关 |
| S3长按约0.8秒 | 进入/退出隐藏彩蛋，退出恢复进入前常规主题 |
| USR | 恢复上电状态并重播小星星 |

## 矩阵菜单

行从上往下、列从左往右编号，不看键帽字符。先长按S0进入参数页；每次须全部松键再按下一键。

| 行 | C1 | C2 | C3 | C4 |
|---|---|---|---|---|
| R1 | 正弦 | 笛管 | 簧管 | 返回演奏 |
| R2 | 回声 | 混响 | 音量颤动 | 效果开关 |
| R3 | 强度/深度−5% | 强度/深度+5% | 速度−1Hz | 速度+1Hz |
| R4 | 恢复效果默认 | 上一个音色 | 下一个音色 | 返回演奏 |

**原R4C2/C3“保留”现在分别用于上一/下一音色。** 七音色循环顺序：SINE→FLUTE→REED→CELLO→PIANO→GUITAR→VIBRAPHONE→SINE。矩阵键盘靠上一/下一可到达全部音色；S0短按仍选正弦，其他音色由屏幕或矩阵菜单选择。

默认回声25%、混响25%、颤动深度50%、速度5Hz、回声被选但效果关闭。参数0～100%步进5%，速度1～10Hz。恢复只改效果，不改音色、页面或曲谱。长按矩阵键不自动连发，速度仅在颤动模式生效。三效果单选、参数独立保存、开关与切换继续平滑。

进入菜单会排空必要的Note Off，尾音自然释放；新增乐器尾音可能比原测试缩短参数更长。退出后先全松键才重新接纳新音符，防止返回键误发声。小星星期间可调参，不中断自动曲谱。

## 波形 电平与音符的含义

`synth_core.visual_sample_valid/visual_sample` 被动输出原 `effect_valid/effect_sample`，正是送入原frame_buffer的有符号16位PCM。显示不能向音频施加背压；frame_buffer后的串行协议改为MAX98357A标准I²S，不改变可视化抽头、音频增益或合成内容。

`audio_visualizer` 每4个有效PCM采样抽取1点，128点一窗，共512采样，48kHz时为10.667ms。每次完成才发布整窗；峰值取全部512采样的绝对值最大值，包含未被抽中的点，正确处理−32768。音量条为线性数字满幅比例，不是声压或dB仪表。

波形为便于看清单声部，采用固定 **X8 DISPLAY** 视图：先将样本限定于−4096～4095，再量化为有符号8位绘图。视图触顶不代表实际PCM削波；电平条仍基于未放大的实际PCM。此抽样视图没有抗混叠滤波或触发锁定，复杂高频信号可能移动或显示混叠，不能代替示波器/频谱或用来测演奏延迟。FFT、李萨如图、LED曲目教学仍未实现。

音符高亮取分配器里实际按住声部的ID，每帧利用已有逐声部扫描汇总；不把松键后的ADSR/回声尾音继续标为按住。只覆盖ID60～75，范围外的曲谱音符可发声但不会在这16格显示；蓝牙以后须明确其ID命名空间/映射。

## 数据与触摸接口

64位旧设置快照低位布局保留，音色高位增加于bit53，主题bits55:54（0英伦、1小猫、2卡皮巴拉、3彩蛋）；bits79:64为16音符图，87:80为峰值，1111:88为128×8位波形（第0点在最低8位）。完整1112位状态继续通过四相 `rgb_status_cdc` 原子握手，像素域仅在帧边界发布，允许跳过中间窗，不逐位同步多位载荷。

标题/正文共用16384×16同步字库，动态背景独立同步ROM，九级renderer及连接器一级像素/DE/HS/VS管线。绘图和触摸共用 `src/config/ui_layout.svh`，空隙无动作，固定说明和演奏页音符监视器不响应触摸。七个音色参数页按钮112×52，效果按钮148×48，加减52×48。触摸未调通时仍用矩阵。

生产顶层现默认`TOUCH_ENABLE=1`、`TOUCH_UI_ENABLE=1`。驱动、AB26/U25/V23/R23接线和71位触摸CDC保持；入口仍需ready、无错、800×480、单点范围合法，先抬手再按、每次只触发一次。`ui_touch_actions`使用menu_mode区分页面，演奏页SETTINGS和THEME >可触摸；不会把参数页命中区域带到演奏页。默认启动只表示RTL会访问器件，不代表此前`TOUCH ERROR`的供电、上拉或通信问题已修复。

## 用户上板步骤

1. 更新main后关闭旧工程，打开根目录keyboard_adsr.gprj，顶层keyboard_top；确认工程依赖和CST来自本次合并版本，不能沿用旧IDE文件列表。
2. 先断电核对LCD、矩阵、MAX98357A和触摸杜邦线，再接回供电。触摸会在复位释放后自动启动。
3. 自行运行Gowin综合/P&R，检查61.44MHz音频域、35MHz像素域、全部Setup/Hold、资源及ROM/RAM推断；助手不运行EDA或下载。
4. Programmer核对.fs来自本次工程impl/pnr，先SRAM验证。启动仍有小星星，然后交给矩阵。
5. 核对演奏页波形/电平随发声和尾音变化，16格与实际音符对应；切参数页不出现额外音符，退出后须全松键再弹。
6. R4C3循环听七音色；先使用回声/混响/颤动关闭的干声比较CELLO、PIANO、GUITAR、VIBRAPHONE的持续与松键表现，再开效果确认参数可调。
7. 测S0长短按、S1/S2主题、S3短按效果开关/长按彩蛋、THEME >、强度/速度、RESET与曲谱结束接管；检查画面是否闪烁、缺字或错色。观察TOUCH WAIT是否进入READY，再核对SETTINGS、音色和效果命中区域。

新版本不得因为仿真通过就忽略STA；本轮不宣称修复原偶发双键噪声或底噪。

## 2026-10-25 FX开关与时序修正

选择ECHO/ROOM/TREMOLO只改变类型，保持当前FX ON/OFF；只有FX按钮、短按S3或恢复默认会改变旁路状态。关闭后反复切换类型仍保持关闭，开启时切换仍保持开启。此规则也适用于矩阵菜单。

显示八级流水：布局描述→相对坐标→字符格→字符选择→字库地址→同步ROM→背景/透明度→文字混色。RGB、DE、HS、VS及背景均延迟相同拍数；像素时钟35MHz、800×480扫描参数、触摸矩形与图像素材不变。完整主题画面须与旧版逐像素核对，不能只看DE计数。

音频可视化工作窗口按固定索引写入，持音监视器先寄存声部身份再生成音符位图；这些只影响屏幕监视数据，不改音频样本/ADSR/分配握手。快照CDC各域消费者使用本域reset_sync输出，原外部公共复位不再直接释放1112位和71位消费者寄存器；四相握手与原子载荷保持。

用户本次pnr.zip（12:20报告）中，ref/audio/pixel Fmax分别43.874/33.308/13.645MHz，要求50/61.44/35MHz；报告Setup违例端点3882、Hold为0，像素最差地址路径73.416ns，原实板有随机缺音/持续音/电音。这是修正依据，不能当作新版本STA。助手未运行Gowin或下载；新版本须由用户重新实现并提交报告，所有时钟达标、违例消除后再进行音质与重复USR测试。若音频域仍不满足，需要取得该域最差路径，继续定位；不预先宣称本轮已完成时序收敛。

## 2026-10-25 第二轮时序与布线优化

用户确认b07c0d5实板功能正常；18:06报告仍有388个Setup违例，ref/audio/pixel Fmax44.792/53.023/32.097MHz，要求50/61.44/35MHz，P&R耗时1h8m51s。本轮不改变这些要求频率。

在原八级renderer前增加坐标/消隐输入寄存，背景/面板颜色比较移到已有的第二级；renderer共九级。rgb_display在连接器前增加一级真正的输出寄存，并用本域pixel_reset异步清零，实现丢锁/停钟时立即消隐，避免输出端组合复位选择器；总延迟十拍，画面、DE、HS、VS同步移动，不改触摸命中区域。前节八级描述保留为上一轮历史。

LCD约束改用物理lcd_clk输出端的35MHz反相生成时钟lcd_pclk作为采样参考。旧6ns绝对clock-to-port预算包含时钟插入延迟（报告8.594ns），不是原注释所说的纯数据布线6ns。这是先前约束表达错误，需要更正；不能靠删除检查来掩盖。新set_output_delay预留8.286ns setup工程余量，半周期14.286ns减去此余量约为原意6ns数据路径预算；min=0检查非负hold余量。它包含真实转发时钟与数据的偏斜，但**不是面板tSU/tH或板级走线验收**，仍需面板规格与测量补齐。没有降低内部频率或新增多周期例外；普通数据通路没有false_path，复位同步器入口的真实异步例外见下段。新命令依据高云官方SUG940 5.2.2、5.3节，实际Gowin解析、对象匹配及新STA仍由用户运行确认。

音频sample frame_ce在生产HALF_CYCLES>1时提前一拍计算并寄存，输出有效的时刻与原逻辑完全一致；HALF_CYCLES=1保留压缩仿真的首沿约定。锁定计数器用低8位预进位/终值预判分段计算，并以原两拍lock_sync同步释放计数器复位；不改变资格等待拍数、PLL参数、采样率或包络。独立逐拍等价测试覆盖HALF_CYCLES 1/2/3/20，以及锁定阈值1/255/256/257/100000和异步失锁/USR。

动画无损裁透明边/复用重复帧，详见themes.md。完整测试和原报告摘要位于reports/pnr_optimization/2026-10-25；新资源、Fmax与P&R耗时未知。请关闭旧IDE，用完整新包在新目录重新打开keyboard_adsr.gprj，不把新HEX混入旧RTL；先运行综合/P&R并检查约束全部Active、对象不为空、I/O setup/hold及三个域内关键路径。

第二轮复位入口约束补充：18:06报告的四条负Recovery路径只到pixel_reset_sync和status_bridge/pixel_reset_sync两组两拍同步器的PRESET入口。以明确四个引脚名设置异步入口例外；不匹配整个寄存器、整个时钟域或业务D端。reset_sync链保持原ones-to-zero两拍同步释放，输出到业务寄存器的Recovery/Removal仍受检查，手动复位/失锁逻辑不变。新Gowin报告必须确认四个对象全匹配且无额外命中。此说明细化了先前“不加false_path”的表述：不允许虚假或普通数据路径豁免，真实异步复位入口应按其结构约束。原理与语法参考高云SUG940 5.4.1及AMD UG906异步复位同步器说明；不是通过关闭数据时序检查来制造达标。
