xixi-2380/fpga-instrument/docs/interfaces.md

## 最新：实时分析接口

UI_VIEW=21，触摸[264,384)×[420,464)。1112位状态58:57为视图0波形/1FFT/2XY，56语言、55:54主题保持，63:59保留。新增513位原子谱快照{ready,spectrum[511:0]}，每8位一频带，从低位第0组开始；帧边界冻结。XY在pixel_clk域双缓冲位图生成，原十拍连接器延迟保持。详见[audio_analysis.md](audio_analysis.md)，下文旧保留位范围以此为准。

# 模块接口和固定周期约定

## 时钟与复位

参考 50 MHz；PLL 1：IDIV=1/FBDIV=1/MDIV=16/ODIV0=25，输出 32 MHz、VCO 800 MHz。
PLL 2：IDIV=1/FBDIV=1/MDIV=24/ODIV0=12.5（整数 12、1/8 分数值 4），输出 61.44 MHz、VCO 768 MHz。
PFD 分别为 50/32 MHz，满足工具要求的 19..81.25 MHz。原 50→96→61.44 MHz 候选因 PFD 不合法已废弃，错误报告保留。
使用 GW5AST-138 的 PLL 原语，内部反馈、静态配置；没有组合逻辑派生时钟。
PLL 2 在 PLL 1 连续稳定 100000 个 50 MHz 周期后解除复位；第二级再资格判断 2 ms。
LOCK 低会异步断言安全复位，释放经过本域两级同步。上电 POR 计数器使用 Gowin 可综合寄存器初始化。
失锁时直接静音；恢复必须重新锁定并走完整启动流程。

## 音频周期

所有音频 RTL 在 audio_clk 上升沿运行。BCK 是寄存器输出，正常高低各 20 个周期。
每 1280 周期一立体声帧。bit_index 0..15 为右、16..31 为左。
frame_ce 与右声道 MSB 的第一个下降沿同拍；DIN/WS 此时更新，上升沿采样。
复位将 BCK 置高、WS/DIN 置零；首次下降沿建立右 MSB，随后第一上升沿采样。
复位可打断当前帧，下一次运行从完整右/左帧开始。

## 数据与握手

phase 为无符号 U0.32 周相位；FCW 为每样本周期相位增量。sample_ce 每帧推进一次。
ROM 地址 phase[31:20]，4096x16 有符号 Q1.15，同步读，valid 与 ROM 输出同拍有效。
tone_gain 将输入拼接 8 个零扩展为 Q1.23；level 为无符号 Q1.16（0..65536）。
先以42位有符号乘积保存。tone_gain默认16位输出时右移29位；当前共享路径设置OUTPUT_W=24，右移21位，保留8个小数位。每声部仍使用level/65536和1/32增益，数值不变。
当前32路24位值依次符号扩展到40位累加，再算术右移8位、饱和至[-32768,32767]。截断向负无穷，仅在总和转DAC时舍掉这8位；每声部峰值约1024个DAC码，四路同时最大约4096，32路接近满量程，不增加额外归一化。

frame_buffer 使用 sample_valid/sample_ready、sample_l/sample_r 成对接收。
valid && !ready 时生产者必须保持 valid 和左右数据；旧715920f四声部流水线在第4周期提交；当前32声部共享流水线在frame_ce后第517周期交付下一帧样本，永远有空闲缓冲，TB 检查此假设。
每帧先消耗旧 pending 对，再接收本拍新样本；边界同拍交付的样本属于下一帧，无直通旁路。
缺样本发零，除预期初帧外置位 sticky underrun；复位清除标志。

启动先完整发送 480 帧零码，在索引 480 的帧边界开启 PA，后续 240 帧令 level 从 0 线性增加至 65536。
一帧缓冲使数字淡入样本晚一帧到串行输出。当前左右声道发送同一混音样本；旧D1的channel_mode左右隔离模式属于已归档入口。各声部FCW通过下述音符事件接口更新，不直接接异步多位控制。

## 下一阶段

保留 32 位相位、12 位波表地址、24 位声部、40 位混音、16 位 DAC。
2026-10-16已实现32声部共享调度，按32*16+32=544周期截止预算检查，实际交付517周期；样本提交早于下一1280周期边界。功能通过HDL，资源和实现时序仍待用户报告。控制事件跨域用握手快照或异步FIFO。
音频发送不等待事件队列，也不因控制突发而停钟。

## D0 GPIO 镜像诊断接口

bringup_digital 新增四个单向输出：DBG_BCK=HP_BCK（C24）、DBG_WS=HP_WS（B24）、DBG_DIN=HP_DIN（E25）、DBG_PA_EN=PA_EN（D25）。仅内部信号扇出，原串行时序不变；无新增 CDC 或内部时钟。诊断版数据与功放使能固定零。物理输出存在各自路径延迟，不视为 DAC 引脚电气测量。

## 用户指定 J23 排针更新（覆盖此前 PMOD1 位置）

四路端口逻辑不变，DBG_BCK/DBG_WS/DBG_DIN/DBG_PA_EN 依次改用 U22/V19/W20/U26（J23 39/37/35/33），LVCMOS33。按用户图片上排从左到右测量；下排 V22/W19/Y20/V26 不使用，均不是地。原 DAC 引脚不变。

## D1 单音板级接口

tone_play_board 及其 stereo/left/right 入口保留 10 个板级端口：clk/rst、HP_BCK/HP_WS/HP_DIN/PA_EN、DBG_BCK/DBG_WS/DBG_DIN/DBG_PA_EN。区别是 DIN 和 PA_EN 由真实单音核心驱动，不再固定零。DBG 端口仅扇出；外部输入仍只有复位，本阶段没有控制输入。默认配置在 synth_config.svh；仅声道模式为三个顶层常量。

## 2026-10-13：演奏输入改用用户 4x4 矩阵键盘

列从左到右 W26/L22/Y26/AA25；行从上到下 W25/M24/Y25/AA24。八个球位已在官方 Header CST 核对，标称 3.3V，互不重复且与现有音频引脚及测量点不冲突。后续按 key_col[0..3]、key_row[0..3] 与 bit(row*4+col) 实现，计划非选列高阻、行上拉、同步/消抖及原子状态提交。每键独立二极管暂未确认；不提前声称任意多键识别。仅更新接线记录，RTL/下载文件未改变；静态映射检查通过。详见 docs/matrix_keypad.md。用户反馈 D1 正常发声，实测数值及其余验收待补充；仍由用户烧录。

## 2026-10-13：D2 矩阵键盘单声部 ADSR

新增矩阵扫描、同步/消抖、鬼键歧义释放、采样边界 Note On/Off、精确时长 ADSR 和流水线音频集成；保持 U22/V19/W20/U26 音频镜像。七个新 TB 通过，共 2631691 检查；单次生产参数首非零码延时仿真约 3.135 ms。历史 D2 P&R 18 端口匹配、setup/hold=0，资源见 reports/keyboard/validation.md。

用户明确综合编译/布局布线/烧录自行完成，后续助手仅改文件及纯 HDL 仿真；当前新 D2 未由助手烧录，实板键位/电气/音频/延时/长稳仍待用户验收。接口与下一阶段约束详见 docs/bringup_keyboard.md。单声部新按键优先、同帧最高键号优先，松开回退至仍按住的最高键号；不宣称复音或无二极管任意多键无冲突。

## 2026-10-14：修正物理行列定义

用户澄清：W26 控制最上方横行，W25 控制最左侧竖列。当前 key_row[0..3] 为 W26/L22/Y26/AA25（同步上拉输入），key_col[0..3] 为 W25/M24/Y25/AA24（选中低、其余高阻输出）。修正 keyboard.cst、编译脚本的位置核查表、机器可读映射及操作说明；音频 GPIO 不变，内部扫描/ADSR 逻辑不变。
新增基于实际 CST 的物理开关网络 TB：修正版 16 位置按下/松开、音频和鬼键共 34 项通过；旧版对照也通过 34 项，显示只转置键位。因此完全无声尚不能归因于此次行列解释，故障未标为修复。
没有运行 Gowin 综合/布局布线或烧录；现有旧 .fs 与旧 P&R 仅作历史记录，当前源码需用户重新编译。

## 2026-10-14：板载运行流水灯

新增 run_leds 及独立 TB，50 MHz 域四灯每 250 ms 轮流亮、不依赖音频 PLL 或用户复位；LED4 为同步后的音频域就绪，LED5 为同步后的音符门控。六灯均低有效，按 Dock 4071f3 图 LED0..5 约束 J14/R26/L20/M25/N21/N23（该版本 LED0/1 命名与旧 CST 位序相反）。键盘及音频球位未变。
更新 keyboard_top 六位 led_n 端口、GPRJ、CST/SDC、编译脚本及输出配置；输出基名 D2_keyboard_leds，用于区分原旧文件。状态信号各两级同步，仅单向观测，不影响音频控制。
tb_run_leds=111、tb_keyboard_top=329180 检查通过，物理键盘映射测试两方向各34项通过。没有运行 EDA 综合/布局布线/烧录，没有生成新的 .fs；当前需用户重新编译，实际无声原因尚未确定。详细用法见 docs/bringup_run_leds.md。

## 启动状态灯只读诊断

run_leds仅在ref_clk域运行，新增PLL1/PLL2 LOCK和外部复位的两级同步观察。未就绪持续RUN_LED_DIAG_STEPS个流水步进后，低四位改为心跳/LOCK1/LOCK2/复位显示；就绪时恢复四灯流水。LED4/5仍为同步后的音频复位解除/音符门控。该显示没有反向控制路径，原时钟、复位、锁定2ms资格和音频帧握手不变。原始LOCK显示不能代表连续稳定资格已满足。

## 2026-10-15：单声部分离接口（历史，已被下述四声部接口替代）

keyboard_top只做板级连接。keyboard_core保留矩阵行列、同步/去抖、鬼键抑制、按键优先级及key_fcw映射；synth_core接收通用单声部音符事件，不引用key_row/key_col、16键位图、selected_key或键位表。ADSR默认值移至原synth_config.svh，数值不变；keyboard_config.svh仅定义矩阵扫描参数。

| 信号 | 方向 | 约定 |
|---|---|---|
| frame_ce | 音源→输入适配器 | audio_clk域的帧采样使能，每1280周期一次；仅作CE，不能当时钟 |
| note_ready | 音源→输入适配器 | 启动静音阶段完成后允许提交音符；适配器在为0时禁止Note On/Off |
| note_on / note_off | 输入适配器→音源 | 同一audio_clk域，在frame_ce有效的上升沿采样；一次事件只覆盖一次帧边界，不接受随意异步脉冲 |
| fcw[31:0] | 输入适配器→音源 | 无符号32位相位增量，与该帧音符事件同时稳定；无新音符时保持当前音高，Release仍使用原频率 |
| envelope_level[16:0] | 音源→观察接口 | 现有Q1.16 ADSR包络，仅用于观测；按键gate和selected_key属于输入模块 |

两模块当前同一audio_clk和audio_reset，无新增跨域路径。事件同时到达时沿用ADSR的Note Off优先级。今后串口/MIDI/其他时钟域键盘必须在输入适配器中完成原子事件跨域，不可把异步多位频率直接接入。这里只定义接口，不增加这些外设或事件队列。

note_ready是输入许可而非外部功放管脚；当前原启动控制仍同时释放note_ready与PA_EN，功放时序完全保持。USR输入、POR与PLL复位保留在clock_reset，不放入键盘映射或音源模块。用户已确认底噪为耳机阻抗问题并取消处理，未加入自动静音、待机或唤醒延迟。

## 2026-10-15：四声部并行事件接口（历史）

keyboard_core只处理物理扫描与key_note_events；矩阵位图、键位表、鬼键策略不进入synth_core。原mono_note_control文件在原位置重命名并改成key_note_events，不保留重复版本。通用音源内的voice_allocator与输入种类无关。

| 信号 | 方向 | 当前约定 |
|---|---|---|
| input_ready | 音源→输入适配器 | 原启动静音完成，允许开始发送键盘事件；与PA_EN沿用同一启动控制 |
| note_valid / note_ready | 双向 | audio_clk上升沿两者同时为1才接收事件；valid为1而ready为0时，valid及全部载荷必须保持 |
| note_on | 输入→音源 | 此次事件类型，1为Note On，0为Note Off；不再是只能在frame_ce出现的单音脉冲 |
| note_id[6:0] | 输入→音源 | 0..127音符身份；当前矩阵输出60..75，不等于声部编号 |
| note_fcw[31:0] | 输入→音源 | Note On对应的32位相位增量；Note Off仅按编号匹配，忽略FCW |
| frame_ce | 音源内部/观察 | 固定1280周期帧边界；此拍note_ready为0，其余就绪周期可接收事件，串行输出不等待控制 |
| voice_held / voice_active | 音源观察输出 | held表示当前被按住的四个已分配声部；active包含Release尾音 |
| envelope_level | 音源观察输出 | 四个17位包络的最大值；不是混音增益或单个被选中键的包络 |

接收的事件先更新声部所有权和待处理命令，ADSR与DDS在下一frame_ce统一执行；多条事件可以在两帧之间接收，不停BCK。矩阵适配器每两周期最多发送一条，选择新事件时先释放、再按下，同类按键号从低到高；已经发出的回压事件不能撤回。最新稳定键状态与已确认状态逐步收敛，鬼键清零会产生全部相关Note Off。

同一编号再次Note On复用原声部，刷新起音年龄，从当前包络重新Attack且相位连续。新编号依次选空闲、最久未起音的已释放、最久未起音的按住声部；所有权改变在帧边界同步清零该声部相位与包络后起音。年龄用有界排序而非会溢出的时间戳。被替换的旧Note Off不会误关新音符；被替换但仍按住的键不会自动恢复，需要松开重按。替换是帧边界直接换声部，没有额外偷音交叉淡化。

同一声部一帧间隔内的多次重触发合并处理。若一次On后Off都发生在帧前，保留一次起音并在后一帧释放，防止卡音；不保证亚采样周期的短事件可听。现有矩阵约3ms消抖，远大于20.833us音频帧。

每个声部独立32位相位、4096×16同步ROM、17位ADSR和24位声部输出；新增40位混音寄存输出后，样本在frame_ce后第4周期进入下一帧缓冲。所有域内控制使用audio_clk和CE，无新内部时钟或CDC。将来其他时钟域输入须先做原子事件跨域，再遵循此握手；本次未增加MIDI、串口或其他键盘驱动。

PLL、U4下拉复位、引脚、480帧静音、240帧淡入和PA持续开启策略保持；用户已取消底噪处理。无二极管矩形歧义仍释放所有声部；四声部不代表任意四键无冲突。当前资源与时序需用户重新综合/P&R确认，旧报告不作四声部验收。

## 32 声部实现规划

2026-10-15按用户“下一步规划”要求制定；以下保留当时方案，2026-10-16实施状态看文末“32声部当前实现”。功能与验证基线为715920f：四声部用户实板定性确认，7051357项HDL检查通过。下面描述拟实施行为，不替代上节当前四声部接口，不是32声部已完成声明。

### 方案与边界

保留32份独立音符所有权、FCW、32位相位及ADSR状态。第一版ADSR仍按声部实例化并在frame_ce统一更新；共享一套同步正弦ROM读取路径、一套启动包络乘法路径及一套tone_gain路径，逐声部生成24位样本，进入40位寄存累加器，最后一次截断并饱和到16位。两类乘法的实际DSP映射及ADSR常数除法/分配器比较路径的资源和时序均须用户综合/P&R报告确认，不宣称一个RTL乘法器等于一个物理DSP。

当前synth_core中的generate为每个声部实例化DDS/ROM与两类增益运算，voice_mixer是串联组合求和。直接把VOICE_COUNT从4改成32不会实现共享调度，并会放大资源和组合路径；下一版须先重构数据通路。本阶段仍只做正弦复音，不增加MIDI、音色、效果器、显示或硬件自奏入口。

### 固定帧调度预算

61.44 MHz音频时钟、48 kHz采样，每立体声帧1280周期（约20.833 µs）。拟采用16周期固定声部时隙，另预留32周期处理帧准备、最终结果交付和裕量：

| 项目 | 周期数 | 设计用途 |
|---|---:|---|
| 帧准备预留 | 16 | 锁存该帧命令/参数，等待ADSR和启动包络更新可见，清空本帧累加器 |
| 32个声部时隙 | 32 × 16 = 512 | 固定顺序遍历0..31，每声部只计算并累加一次 |
| 帧收尾预留 | 16 | 最后一次累加生效后转换、交付下一帧样本，检查完成状态 |
| 合计 | 544 | 约8.854 µs，作为包含sample_valid/ready握手的设计截止预算 |
| 帧内剩余 | 736 | 约11.979 µs，可接收后续事件；不依赖这些周期补算漏算声部 |

单声部16周期内的逻辑顺序为读取独立上下文、应用restart选择采样相位、同步ROM读取、包络与启动level相乘并右移16位、tone_gain定点运算、40位符号扩展累加和相位写回。具体周期编号由RTL及TB锁定；不能把ROM的单周期延迟、非阻塞赋值或最后一次累加/转换放在同拍而误用旧值。

1/4/32声部参数下均采用相同调度原则，预算为32+16×VOICES；32声部必须在frame_ce后544周期内完成缓冲握手，并早于下一1280周期边界。当前四声部“第4周期提交”的历史约定在共享实现中会改变，串行输出仍在下一帧发送旧pending样本，不能额外多加一整帧延迟。上述是方案预算，只有后续测试通过后才能记为验证结果。

### 事件、帧状态与一致性

- 外部事件字段继续为note_valid/note_ready、note_on、7位note_id、32位note_fcw，不加入键盘专属信息；input_ready仍表示启动许可，与现有PA启动策略保持。
- frame_ce拍不接收事件。拟在整段渲染busy期间令note_ready为0，完成后恢复接收；输入适配器必须保持valid和全部载荷。启动许可与渲染busy分别处理，不能把busy用于关闭PA或暂停BCK。
- frame_ce锁存本帧FCW、voice_restart等短脉冲和命令归属，32个ADSR在同一边界更新。后续时隙读取该帧更新后的包络/启动level；渲染结束前不变更所有权，避免同帧前半读旧音符、后半读新音符。跨域输入仍须由适配器完成原子传递，本阶段无新增CDC。
- 每个声部每帧相位只推进一次，包含空闲声部，保持现有相位约定；新身份以相位0起音，同身份重触发保持相位/当前包络。无效/空闲声部也占固定时隙并贡献零码，静音期间每帧仍须交付样本。
- 保持同编号、空闲、最旧释放、最旧按住的分配策略；第33音和被替换编号的旧Note Off须正确处理。年龄排序保留有界状态，不引入时间戳回绕。On+Off同帧间隔的语义沿用当前约定，不能因时隙重构而卡音。
- 新增的ready等待、帧归属和输出等待全部计入输入延迟；8.854 µs是渲染预算，不是端到端实测延迟。仍按原目标核对总延迟≤10 ms、争取<5 ms。

### 定点精度与输出

保留32位相位、4096×16同步正弦表、17位Q1.16包络、24位声部和40位混音。每声部仍使用1/32增益；32个同相、满包络声部接近16位满量程，不为扩声部擅自调整功放或总增益。24位有符号值求和32次至少需29位，40位累加具有余量；仍只在最终混音算术右移8位并饱和，避免先转16位再求和。

保持包络与startup乘积先右移16位、声部定点截断后累加的现有计算顺序。TB以独立64位整数参考核对零、负数、抵消、正负饱和及随机样本；要覆盖最后声部、空闲后重用和连续帧累加器清零，防止遗漏或重复。

### 原文件修改顺序

| 阶段 | 拟修改的原文件 | 验证与交付 |
|---|---|---|
| A：状态与分配 | voice_allocator.sv、tb_voice_allocator.sv及必要仿真参数入口 | 先用1/4/32配置直接输入事件，覆盖32满额、第33音、旧松键、重触发和年龄排序；生产VOICE_COUNT暂不改 |
| B：共享通路 | synth_core.sv、dds_sine.sv、voice_mixer.sv及原对应TB；tone_gain/sine_rom按需要调整接口 | 用四声部验证共享ROM、单声部运算、状态写回和截止时间，不保留并行实现的重复工程或v2文件 |
| C：32集成 | synth_config.svh、原synth/keyboard/board TB、poly_audio_reference.svh、run_sim.py及文档 | 切换32配置、消除TB硬编码四声部，直接事件满负载回归，再做现有物理键盘和板级回归 |
| D：用户实现 | 用户运行现有主工程；助手只读用户报告并修改原文件 | 核对当前源码资源、推断ROM/DSP、61.44 MHz时序、实际球位，用户烧录后记录听音和长稳反馈 |

各阶段完成适当检查后用中文提交并同步私有GitHub；阶段失败保留证据，不将未完成结果标成成功。上述文件名均对应现有src/、sim/、scripts/内文件，不新建第二套工程。若后续发现确需新独立模块，应先明确职责，不能复制旧模块作为替代。

### 验收矩阵与实际边界

1. 分配与控制：1/4/32声部；32个独立编号/FCW；独立松键尾音；同身份重触发；第33音；忽略旧Note Off；回压载荷稳定；帧前后事件；短On/Off；长序列年龄排序和重复占槽检查。
2. 数值：独立相位/ROM/包络/增益参考，逐声部及逐帧核对；零输入、同相满负载、不同频率、负数、抵消、饱和、随机序列，检查每帧恰好32项且无跨帧累积。
3. 调度与串行：1280周期恒定，握手截止≤544周期，每帧恰好一次交付，预期首帧后无underrun；BCK/WS/DIN、左右帧和镜像按原规则；渲染或事件突发不能停钟。
4. 退化与恢复：复位/失锁中止渲染、清除旧pending和相位状态；完整启动静音与淡入；再次发声无旧帧残留；鬼键歧义释放全部相关音符。
5. 四声部等价检查以相同“已接收事件及其所属帧”为基准逐帧比较；ready窗口变化可能改变墙钟时刻下的事件接收，不能无条件承诺旧CSV逐字节不变。生产参数键盘延迟重新测算，不能沿用四声部旧值作为32声部结果。
6. 满32音符直接从独立synth TB输入，使用现有7位身份/FCW接口；4×4无二极管键盘只有16个物理键且存在歧义，只验收其安全组合，不能由键盘按键数证明32声部。长尾叠加可作辅助听感测试，不能替代计数与数值参考。
7. 新日志使用独立reports/目录，不覆盖reports/four_voice。完成全套HDL、官方PLL板级、物理引脚映射和无额外配置搜索路径的include检查后，再交用户综合/P&R/烧录。至少30分钟连续运行作为实板长稳计划，频率/电压/延迟测量仍受现有仪器条件限制，不填写推测值。

优先风险为32路分配器比较/年龄更新路径、32份ADSR运算资源、共享ROM的时隙/上下文对齐及最后一次累加结果交付。若用户STA或资源报告暴露问题，先按报告调整原实现；是否进一步共享ADSR或流水化分配器由证据决定。保持原引脚、U4下拉、PLL、480帧静音、240帧淡入和PA策略；已关闭的底噪任务继续关闭。

## 2026-10-16：共享调度实际接口（阶段B）

当前配置仍4声部，已实现单DDS/同步ROM、单启动包络乘法路径、单tone_gain与40位顺序累加；每声部保留独立相位/ADSR。render_busy内note_ready=0，生产者保持载荷；input_ready/PA行为不变。frame_ce锁存FCW/restart，16周期准备后每16周期处理一声部，准备与收尾总预算32周期；4声部交付须≤96周期。逐声部参考和逐帧串行参考均通过，首非零码生产仿真延迟3.176972ms。

原dds_sine新增VOICES及voice_index，phase为打包的独立上下文输出；默认VOICES=1保留单声部测试。原voice_mixer改为24位voice_sample及first/last串行输入；只有last且in_valid时输出一次，最后一项参与同次饱和结果。旧并行接口和第4周期交付属于715920f历史状态。阶段B不是新硬件验收，也不是32声部满负载结果。

## 2026-10-16：32声部当前实现

生产VOICE_COUNT=32，同一GPRJ仍20个HDL、27项总依赖。渲染期note_ready=0，FCW/restart在frame_ce锁存，每声部只推进一次相位并累加一次。每帧实际buffer握手第517周期（预算544）；1/4声部为21/69周期（预算48/96）。input_ready、PA和原480帧静音/240帧淡入不变。共享DDS、启动乘法、tone_gain及40位累加路径各一套，32个ADSR独立；实际物理资源数由用户综合确认。

逐声部相位/定点参考、32独立音符、第33音替换及旧Off、满幅同相、短事件、突发、渲染中复位、鬼键和官方PLL失锁恢复通过。生产仿真Note On=3079.088µs、首码=3176.972µs、Note Off=3102.851µs；当前硬件未测试，不能沿用715920f的实板结论。最新证据为reports/thirty_two_voice/validation.json。

## 2026-10-19：分配搜索的多周期握手

voice_allocator的公开音符/音色字段不变，note_ready现在只在注册目标已选定且enabled有效、frame_ce无效时才置1。生产者必须先置valid并保持全部载荷，不能等待ready才发valid。搜索先缓存事件，再用READ_CONTEXT/COMPARE两拍检查每个声部，SELECT寄存目标及target_rank，OFFER握手当拍原子提交身份、FCW、音色和所有权。无打断时等待不超过2×VOICES+4拍；32声部上限约1.107 µs，帧/渲染回压另计。

frame_ce或enabled撤销会取消尚未确认的搜索，重新允许后对同一个仍保持的事件重新读取；不会提前应答或重复提交。ADSR仍只在frame_ce消费pending命令，渲染仍冻结所有权。外部接口、替换顺序及短On/Off语义不变，内部rank更新不再用组合候选索引读取其他rank。32事件不再保证塞进一帧空窗；样本生成预算仍544拍且每帧只交付一次。

这一结构调整移除了旧报告中的串行比较链，不等于已经通过61.44 MHz STA；需要用户重新实现报告确认。

## 2026-10-19：一次曲谱与键盘事件源交接

新增独立score_player作为同域valid/ready音符事件源，沿用note_on、note_id、note_fcw和note_timbre。轨道身份0..3与矩阵60..75互不重叠，实际音高由FCW表示。主音源接口和逐拍分配规则不变。

顶层以score_busy选通整个事件载荷和返回ready。自动播放时键盘适配器input_ready与note_ready均关闭，扫描继续；score_busy只有在最后四个Off已握手且RELEASE+4帧尾音结束后撤销。该时刻没有待确认的曲谱事件，切换不撤回valid、不截断包络；键盘随后重新对当前稳定位图发事件，期间按住的键不会丢失。音色控制在播放时看到零位图，恢复后沿用原操作。

播放器只在frame_ce累加门长/间隔/尾音计数，不派生时钟。每步先发四个On、保持3/4拍长、再发四个Off，计完剩余间隔后前进，最后一步直接等待尾音。ready回压期间状态和全部事件字段保持，时长可随握手等待略延长；完成后不循环。SCORE_ENABLE=0退化到原键盘模式，USR复位重新播放。

## 2026-10-19：文件曲谱播放器接口

原score_player原位改为通用同步ROM事件解释器，使用SCORE_FILE/SCORE_WORDS选择谱文件和容量。删除旧src/config/demo_score.svh内置歌曲函数，歌曲转为src/scores/twinkle.txt与生成的twinkle.hex。音高和和弦都由谱文件明确给出，播放器不引用键位表或歌曲专属逻辑。keyboard_top原位增加同名文件/容量参数并转传，原事件源复用与键盘隔离不变。

BEAT_FRAMES必须为正且为4的倍数，WAIT以1/4拍计数；同步ROM读取与握手有少量开销，回压延长曲长。每个ON/OFF在valid/ready握手前保持所有字段，END后的TAIL_FRAMES结束才交接键盘。error为非法操作码/ROM边界故障指示，故障不交接、须复位。ENABLE=0不读取ROM；USR复位从指定文件起始重新播放。完整64位指令格式、文本转换与验证限制见[播放器说明](score_player.md)。

此次未更改同身份重触发、音源、包络、总增益、PLL或CST/SDC。此前粗糙听感的编排/发音衔接问题仍独立存在。

## 2026-10-20：默认旋律发音对齐键盘

原src/scores/twinkle.txt及hex改成正弦单旋律，按MIDI音高使用身份，42音/84事件，原音高节奏和门长保留。新音高独立声部、旧尾音保持原频率自然释放；重复同音保持键盘重触发语义，不强制清相位或截断包络。默认伴奏移除用于单旋律对照，通用文件播放器仍支持复音和三种音色。没有改变键盘扫描、音源RTL、增益、PLL、PA、CST/SDC。用户自行重新编译烧录，先听完整旋律及C4重复/G4换音，再确认曲终键盘、持键交接和USR重播。实际听感尚待确认；详见[播放器说明](score_player.md#2026-10-20默认旋律与键盘音质对照)。

当前默认谱与键盘可使用相同MIDI身份；两者由顶层互斥选通，曲终等待全部尾音归零后才交接，因此不会同时占有同一身份。更换曲谱时仍须保留所有松音事件及最终尾音等待。
# 模块接口和固定周期约定

## 时钟与复位

参考 50 MHz；PLL 1：IDIV=1/FBDIV=1/MDIV=16/ODIV0=25，输出 32 MHz、VCO 800 MHz。
PLL 2：IDIV=1/FBDIV=1/MDIV=24/ODIV0=12.5（整数 12、1/8 分数值 4），输出 61.44 MHz、VCO 768 MHz。
PFD 分别为 50/32 MHz，满足工具要求的 19..81.25 MHz。原 50→96→61.44 MHz 候选因 PFD 不合法已废弃，错误报告保留。
使用 GW5AST-138 的 PLL 原语，内部反馈、静态配置；没有组合逻辑派生时钟。
PLL 2 在 PLL 1 连续稳定 100000 个 50 MHz 周期后解除复位；第二级再资格判断 2 ms。
LOCK 低会异步断言安全复位，释放经过本域两级同步。上电 POR 计数器使用 Gowin 可综合寄存器初始化。
失锁时直接静音；恢复必须重新锁定并走完整启动流程。

## 音频周期

所有音频 RTL 在 audio_clk 上升沿运行。BCK 是寄存器输出，正常高低各 20 个周期。
每 1280 周期一立体声帧。bit_index 0..15 为右、16..31 为左。
frame_ce 与右声道 MSB 的第一个下降沿同拍；DIN/WS 此时更新，上升沿采样。
复位将 BCK 置高、WS/DIN 置零；首次下降沿建立右 MSB，随后第一上升沿采样。
复位可打断当前帧，下一次运行从完整右/左帧开始。

## 数据与握手

phase 为无符号 U0.32 周相位；FCW 为每样本周期相位增量。sample_ce 每帧推进一次。
ROM 地址 phase[31:20]，4096x16 有符号 Q1.15，同步读，valid 与 ROM 输出同拍有效。
tone_gain 将输入拼接 8 个零扩展为 Q1.23；level 为无符号 Q1.16（0..65536）。
先以42位有符号乘积保存。tone_gain默认16位输出时右移29位；当前共享路径设置OUTPUT_W=24，右移21位，保留8个小数位。每声部仍使用level/65536和1/32增益，数值不变。
当前32路24位值依次符号扩展到40位累加，再算术右移8位、饱和至[-32768,32767]。截断向负无穷，仅在总和转DAC时舍掉这8位；每声部峰值约1024个DAC码，四路同时最大约4096，32路接近满量程，不增加额外归一化。

frame_buffer 使用 sample_valid/sample_ready、sample_l/sample_r 成对接收。
valid && !ready 时生产者必须保持 valid 和左右数据；旧715920f四声部流水线在第4周期提交；当前32声部共享流水线在frame_ce后第517周期交付下一帧样本，永远有空闲缓冲，TB 检查此假设。
每帧先消耗旧 pending 对，再接收本拍新样本；边界同拍交付的样本属于下一帧，无直通旁路。
缺样本发零，除预期初帧外置位 sticky underrun；复位清除标志。

启动先完整发送 480 帧零码，在索引 480 的帧边界开启 PA，后续 240 帧令 level 从 0 线性增加至 65536。
一帧缓冲使数字淡入样本晚一帧到串行输出。当前左右声道发送同一混音样本；旧D1的channel_mode左右隔离模式属于已归档入口。各声部FCW通过下述音符事件接口更新，不直接接异步多位控制。

## 下一阶段

保留 32 位相位、12 位波表地址、24 位声部、40 位混音、16 位 DAC。
2026-10-16已实现32声部共享调度，按32*16+32=544周期截止预算检查，实际交付517周期；样本提交早于下一1280周期边界。功能通过HDL，资源和实现时序仍待用户报告。控制事件跨域用握手快照或异步FIFO。
音频发送不等待事件队列，也不因控制突发而停钟。

## D0 GPIO 镜像诊断接口

bringup_digital 新增四个单向输出：DBG_BCK=HP_BCK（C24）、DBG_WS=HP_WS（B24）、DBG_DIN=HP_DIN（E25）、DBG_PA_EN=PA_EN（D25）。仅内部信号扇出，原串行时序不变；无新增 CDC 或内部时钟。诊断版数据与功放使能固定零。物理输出存在各自路径延迟，不视为 DAC 引脚电气测量。

## 用户指定 J23 排针更新（覆盖此前 PMOD1 位置）

四路端口逻辑不变，DBG_BCK/DBG_WS/DBG_DIN/DBG_PA_EN 依次改用 U22/V19/W20/U26（J23 39/37/35/33），LVCMOS33。按用户图片上排从左到右测量；下排 V22/W19/Y20/V26 不使用，均不是地。原 DAC 引脚不变。

## D1 单音板级接口

tone_play_board 及其 stereo/left/right 入口保留 10 个板级端口：clk/rst、HP_BCK/HP_WS/HP_DIN/PA_EN、DBG_BCK/DBG_WS/DBG_DIN/DBG_PA_EN。区别是 DIN 和 PA_EN 由真实单音核心驱动，不再固定零。DBG 端口仅扇出；外部输入仍只有复位，本阶段没有控制输入。默认配置在 synth_config.svh；仅声道模式为三个顶层常量。

## 2026-10-13：演奏输入改用用户 4x4 矩阵键盘

列从左到右 W26/L22/Y26/AA25；行从上到下 W25/M24/Y25/AA24。八个球位已在官方 Header CST 核对，标称 3.3V，互不重复且与现有音频引脚及测量点不冲突。后续按 key_col[0..3]、key_row[0..3] 与 bit(row*4+col) 实现，计划非选列高阻、行上拉、同步/消抖及原子状态提交。每键独立二极管暂未确认；不提前声称任意多键识别。仅更新接线记录，RTL/下载文件未改变；静态映射检查通过。详见 docs/matrix_keypad.md。用户反馈 D1 正常发声，实测数值及其余验收待补充；仍由用户烧录。

## 2026-10-13：D2 矩阵键盘单声部 ADSR

新增矩阵扫描、同步/消抖、鬼键歧义释放、采样边界 Note On/Off、精确时长 ADSR 和流水线音频集成；保持 U22/V19/W20/U26 音频镜像。七个新 TB 通过，共 2631691 检查；单次生产参数首非零码延时仿真约 3.135 ms。历史 D2 P&R 18 端口匹配、setup/hold=0，资源见 reports/keyboard/validation.md。

用户明确综合编译/布局布线/烧录自行完成，后续助手仅改文件及纯 HDL 仿真；当前新 D2 未由助手烧录，实板键位/电气/音频/延时/长稳仍待用户验收。接口与下一阶段约束详见 docs/bringup_keyboard.md。单声部新按键优先、同帧最高键号优先，松开回退至仍按住的最高键号；不宣称复音或无二极管任意多键无冲突。

## 2026-10-14：修正物理行列定义

用户澄清：W26 控制最上方横行，W25 控制最左侧竖列。当前 key_row[0..3] 为 W26/L22/Y26/AA25（同步上拉输入），key_col[0..3] 为 W25/M24/Y25/AA24（选中低、其余高阻输出）。修正 keyboard.cst、编译脚本的位置核查表、机器可读映射及操作说明；音频 GPIO 不变，内部扫描/ADSR 逻辑不变。
新增基于实际 CST 的物理开关网络 TB：修正版 16 位置按下/松开、音频和鬼键共 34 项通过；旧版对照也通过 34 项，显示只转置键位。因此完全无声尚不能归因于此次行列解释，故障未标为修复。
没有运行 Gowin 综合/布局布线或烧录；现有旧 .fs 与旧 P&R 仅作历史记录，当前源码需用户重新编译。

## 2026-10-14：板载运行流水
