xixi-2380/fpga-instrument/docs/themes.md

> 最新增加频谱／单声道延迟XY，底部“视图”切换。操作见[audio_analysis.md](audio_analysis.md)，语言、主题与S3长按规则保留。

> 当前操作以 [中英文与按键说明](bilingual_ui.md) 为准：S0/S1/S2停用，S3只保留长按彩蛋；屏幕支持中英文切换。下文旧按键说明属于历史版本。

# 高山流水：主题切换

本轮只实现主题切换。界面仍为英文，未增加语言按钮或主音量调节；现有LEVEL仍是数字音频峰值显示。以main bf5df57为基线，保持音源、七音色、三效果、曲谱、MAX98357A、触摸驱动、引脚、PLL及屏幕扫描参数。

## 操作

| 入口 | 动作 |
|---|---|
| S1 | 上一常规主题 |
| S2 | 下一常规主题 |
| 两页右下THEME > | 下一常规主题，112×44触摸区域 |
| S3长按约0.8秒 | 进入隐藏彩蛋；再次长按返回进入前主题 |
| S3短按松开 | 开关当前效果；长按释放不会误开关 |
| S0 | 短按正弦，长按切演奏/参数页，保持原约定 |

默认英伦，常规循环：英伦→小猫→卡皮巴拉→英伦。彩蛋不进入常规循环；彩蛋内按S1/S2或THEME >时，沿进入前常规主题继续前/后切换。一直按住任何按钮只执行一次，S1/S2同时按下时S1优先。长按S3与普通切换恰好同拍时，S3彩蛋动作优先；同拍UI动作沿用原板载事件优先约定。

S1/S2不再直接选择笛管/簧管，S3长按不再循环效果类型。通过触屏选音色/效果，或长按S0进菜单：R1C1/C2/C3为正弦/笛管/簧管，R4C2/C3上一/下一七音色，R2C1/C2/C3为回声/房间混响/音量颤动。完整矩阵表见[instrument_ui.md](instrument_ui.md)。

主题切换保留当前页面、音色、效果类型/开关、强度/深度/速度、持音与曲谱进度。主题不是系统复位。USR仍恢复上电默认英伦并重播曲谱。

## 画面与素材

| 主题 | 实际实现 |
|---|---|
| 英伦 | 黑金配色，Great Vibes来源的真正连笔花体标题、Timbre/Effect/Amount/Room Model整词字形；淡金星座连线、星盘圆弧和金色卷饰边角 |
| 小猫 | 用户绿幕视频中原猫咪，离线去绿、裁剪成128×160、16帧，屏上2倍显示；米白暖色和典雅正文 |
| 卡皮巴拉 | 用户视频的原跳舞角色，颜色与GrabCut分割去场景背景，128×160、16帧、2倍显示；奶黄浅橙配圆润字体 |
| 隐藏彩蛋 | 从用户照片制作人物与脚的透明素材，清除字幕；演奏页完整构图独立显示于左侧，波形/电平/音符移到右侧；设置页使用右下小构图；人物与脚均为静态图片 |

动画取视频2秒起的9帧，再反向接7帧，组成16帧无硬跳变往返循环；10fps，周期1.6秒。不是原视频全长播放。动画帧/主题仅在LCD帧边界改变，不撕裂画面，不解码或播放视频原声。彩蛋不再播放脚部动画，长按S3仍控制进入/退出。小猫、卡皮巴拉仍为原16帧循环动画。

为了片上存储，猫咪/卡皮巴拉各15种有效颜色+透明色，原生128×160；背景400×240，彩蛋采用独立200×150 RGB565静态图；演奏页2倍显示完整图像，设置页按固定比例适配。画面存在像素化、色阶和分割边缘取舍，应以实际仿真预览及上板为准。文字、按钮及波形仍按800×480绘制，不把整张概念图缩成屏幕。背景通过面板柔化，选中卡片与操作前景保持独立。

## 存储与时序边界

| 素材 | 初始化逻辑位数 |
|---|---:|
| 猫咪16帧逻辑动画（9张唯一帧，102×95） | 348,840 |
| 卡皮巴拉16帧逻辑动画（9张唯一帧，96×139） | 480,384 |
| 英伦装饰400×240×4bit | 384,000 |
| 彩蛋200×150×16bit RGB565静态图 | 480,000 |
| 三套正文/标题及花体栏目字库 | 262,144 |
| 合计（不含小调色板） | 1,955,368 |

本轮对两段动画仅做无损存储重排：透明边缘隐含为零，往返16帧复用9张唯一帧；保留原128×160逻辑坐标、16帧次序、10fps、全部颜色与透明度。生成头文件src/config/theme_storage.svh描述边界和帧基址，必须与HEX一起使用。全套主题/字库逻辑数据由3,747,584位降至1,955,368位，节省1,792,216位；不能据此推算具体BSRAM块数或布线耗时。

GW5AST-138资料列BSRAM 6120Kb、340块。上表是素材逻辑数据量，**不等于综合后的块数**；还须加原音色/延迟/混响及块粒度开销。没有新增DDR控制器。必须重新综合确认同步ROM推断、BSRAM总量、DSP/LUT、35MHz像素域与61.44MHz音频域Setup/Hold；不能用旧报告代替。助手未运行Gowin、P&R或下载。

`ui_theme_art`并行同步读素材、调色板组合译码；字库并行同步读，当前renderer为九级RGB/DE/HS/VS同步延迟，连接器增加一级异步复位输出寄存，总延迟十拍。彩蛋使用单端口同步RGB565 ROM，直接读取整张照片，无脚部蒙版、第二读口、变形坐标或彩蛋动画计时器。演奏页左侧40..439、116..415为独立展示区；设置页保留原命中矩形和右下完整小图。人物前景不再被演奏波形/电平/音符卡片遮挡。动画只在像素域运行，没有音频回压或音符事件接口。主题bits55:54加入原1112位原子CDC，bit53及其余布局保持。

## 再生成与来源

直接打开根目录keyboard_adsr.gprj即可使用已提交HEX，不需安装Python、字体或ffmpeg。修改工程后应关闭旧工程再重开，确认ui_theme_art、theme_*.hex和config/theme_storage.svh均列入。

可选离线生成命令（不会启动EDA）：

```text
python scripts/gen_theme_assets.py --cat <原猫视频.mp4> --capybara <原卡皮巴拉视频.mp4> --egg assets/themes/egg_cutout.png --font-dir <含LiberationSansNarrow-Bold.ttf的字体目录>
```

依赖Pillow、numpy、scipy、opencv-python-headless、ffmpeg。原视频/原照片不复制进仓库，保持只读；本次去字幕后的透明派生素材assets/themes/egg_cutout.png随工程保存，来源和提示词见assets/themes/README.md。原素材文件名与SHA256、派生素材SHA256及布局记录于assets/theme_manifest.json。脚本生成索引数据与程序绘制的星图；字体来源和子集说明见[字体说明](../assets/fonts/README.md)。

## 上板核对

1. 更新main、关闭旧工程并重开keyboard_adsr.gprj，自行综合/P&R，检查资源、ROM推断和全部时序；通过后下载本次.fs。
2. 上电应为花体英伦，曲谱照常播放。两页都点THEME >，与S1/S2比较顺序，普通循环不得出现彩蛋。
3. 小猫和卡皮巴拉应持续跳舞，手指按住主题按钮不应反复切换。检查字迹、对比度、颜色及帧循环。
4. 在卡皮巴拉等任一主题长按S3进入彩蛋，持续按住不反复切；放开后再次长按，应返回原主题。人物与脚都保持静止，完整显示且没有字幕。
5. 先选不同音色、混响/颤动及非默认参数，按住同一行/列两个琴键切主题，检查持音不中断、无额外音符、参数不变；再测自动曲谱期间切换。短按S3仍开关效果。
6. 无触摸时可先用S1/S2/S3验证；主题实现不等于修复触摸电气或通信问题。全部结果以本次编译及实板为准。

## 纯HDL复核入口

可用原scripts/run_sim.py分别运行`--test tb_theme_controls`、`--test tb_theme_pixels`、`--test tb_theme_art`，并用`--test tb_theme_top --vendor`运行官方PLL库的顶层测试；无官方仿真库时显式改为`--behavioral-pll`，结果不能作为PLL/STA验证。每次用`--out-dir`指定新的日志目录，避免覆盖历史证据。

本轮实际使用Icarus与明确标注的行为PLL替代模型，不执行EDA。双音源对照在自动曲谱和两键持音期间仅对一侧施加主题操作，逐音频时钟比较标准I²S位流和后效果器PCM；两侧必须完全相同。其余测试覆盖四主题双页整帧、快照冻结、触摸命中、动画帧循环、脚部局部缩放、消抖/长按一次、返回前主题与既有七音色/菜单/效果/启动行为。汇总见reports/themes/2026-10-23/validation.json。

## 2026-10-25 松键与彩蛋修正

用户反馈按一下松开后持续响、彩蛋仅见脚。新增慢回升行信号模型可复现原矩阵扫描的相邻列假按键：只在早期采一次，可能读到上一列残留低电平。现在同一列的稳定早采样与槽尾采样都为低才接受，下一扫描完成后再消抖；SLOT_CYCLES至少比SETTLE_CYCLES多2拍。此改动只取自周同学蓝牙分支的扫描修正，不合并蓝牙、音量或其他新功能。

完整物理按键到I²S回归覆盖16个单键、七音色起落和长释放，尾音结束后左右数字输出归零。保留原ADSR、效果尾音及增益，不加按键超时强制截音。该仿真针对一种已复现的误识别机制，不足以证明实物现象只有这一种成因；新时序与实板松键仍须验收。

彩蛋原图只读，内置图像编辑去背景/字幕后制作透明派生素材，完整保留人物与脚。演奏页人物独立展示在左侧，实时监视移到右侧；设置页不动触摸区域。脚部缩放有安全边距，面部、抱臂和衣服区域固定。原先覆盖整屏的背景构图及预览仅代表历史版本。

单独再生成彩蛋素材：`python scripts/gen_theme_assets.py --egg-only`。不需要原视频、OpenCV或字体，不重写其他主题ROM。新证据目录：reports/release_egg/2026-10-25；baseline保留旧扫描失败与原音源通过记录，final保存修复后检查。

## 最新约定：2026-10-25 彩蛋改为静态整图

用户实板确认松键持续响已解决，f96aefd的矩阵扫描修正继续保留；用户反馈彩蛋仍只看到脚，决定先取消动图。当前直接沿用上一轮assets/themes/egg_cutout.png中的人物和脚，不重新生成图像，不改变表情/姿势。只做比例适配、背景合成及RGB565格式转换。

生产路径只读取一张200×150×16bit固定图，单像素一行HEX；去掉脚部蒙版、变形乘法、第二ROM读口、旧调色板及相关计时器。图片内人物、脚、空间位置均固定。小猫和卡皮巴拉动画保留；S3短按效果开关、长按彩蛋进入/退出、主题切换、菜单命中区域均保持。

图像逻辑数据量从768000位降到480000位，减少288000位；其余主题ROM和字体字节不变。此为逻辑数据量而非综合后的物理块数；用户仍须重新Gowin实现、检查资源与STA后下载。之前描述脚部动画、反变换及32色的段落属于历史实现，不作为本版验收条件。

验收：重开本次完整工程、生成新的.fs；长按S3后人物和脚都完整出现，持续观察不应有缩放。进设置页仍显示同一静态图；再次长按S3回到进入前主题。新证据在reports/static_egg/2026-10-25，仿真逐像素比较两次完整照片、检查人物衣服和脚部区域，以及120次LCD帧事件后动画状态不推进。

无需原始视频即可重复打包当前ROM：

```text
python scripts/gen_theme_assets.py --pack-animations
```

此操作解包后再按同一规则无损打包，结果须字节一致；不改变照片、字体或调色板。不生成第二套工程，也不需要增加外部存储硬件。
