xixi-2380/fpga-instrument/docs/multitimbral.md

## 当前七音色补充

本分支已由三音色扩为七音色、编号3位，操作与语义以[instruments.md](instruments.md)和[instrument_ui.md](instrument_ui.md)为准。下方为原三音色阶段记录，旧组合手势不是当前操作。

# 多音色操作与验证

本次在同一主工程中增加三个合成预设：0正弦基准、1笛管风格、2簧管风格。后两者由少量谐波构造，不是原声采样，不宣称逼真还原真实乐器。手动键盘默认选择正弦；当前默认先播放文末曲谱试听，再恢复键盘。

## 操作（2026-10-21更新）

- 底板S0选择正弦，S1选择笛管类，S2选择簧管类，S3开关回声。按钮约10ms消抖，长按不重复。
- 4×4矩阵键盘只演奏，两个旧对角组合不再改变设置；选择按钮本身不产生音符。
- 持音和Release尾音保持原音色；新起音/同音重触发使用新的预设。复位恢复正弦、回声关闭。
- 自动曲谱指定自身音色，S0～S2设置之后的手动预设，S3可在曲谱期间控制回声。
- 按键与引脚、同时按下优先级、源码接口及上板步骤见[板载按钮说明](board_buttons.md)。下方日期条目保留历史过程，当前操作以本节为准。

## 实现与限制

音符事件原子携带音色，回压期间保持稳定。分配器把音色与音符身份、频率一起记入各声部。原dds_sine保留32份相位，三个4096×16同步ROM同地址读取，延迟对齐后选择输出，保持原16周期时隙。这版使用三个ROM bank，不宣称只有一个物理ROM。

笛管相对谐波幅度为1、0.20、0.08；簧管第1/3/5/7谐波为1、0.60、0.30、0.15。各表独立归一化到16位峰值，相同峰值不代表相同主观响度。ADSR参数仍沿用原配置。

新增ROM约128Kbit（未计存储粒度），实际资源与时序需用户综合/P&R报告。单周期波形由scripts/gen_timbres.py离线生成，FPGA实时变调查表，不播放整段录音。谐波范围针对现有C4—D#5键域，未来扩展高音区须增加抗混叠措施。

原GPIO、PLL、复位、输出格式和功放时序保持，新增四个独立按钮输入；单次回声已实现，音色菜单不自动计为第二演奏维度。底噪仍单独待定位。

## 更新与上板

下载完整仓库ZIP，解压到独立文件夹，保留之前可发声的版本。打开新keyboard_adsr.gprj，文件列表应含src/timbre_control.sv以及flute4096.hex、reed4096.hex。IncludePath已改为src与src/config，不沿用E盘绝对路径。

由用户重新综合、布局布线，检查Setup/Hold、61.44MHz音频域及资源。上次报告有严重Setup违例，本次未宣称修复；未核对新报告前不作为稳定演示版。继续使用SRAM下载，不写Flash。

## 验证

- tb_timbre_control：独立按钮同步、按下/释放消抖、直接音色选择、长按单次、独立回声与复位。
- tb_timbres：3×4096采样点独立谐波数学对照，检查波形和ROM输出延迟。
- tb_multitimbral：32声部混合音色，与独立逐样本及串行输出数学参考比较，验证持音、释放、重用和重触发。
- tb_key_note_events：回压时音色和音符载荷稳定。
- 原RTL回归继续执行，结果见reports/multitimbral/summary.json。本环境无官方PLL行为模型，不声称重跑vendor板级仿真、物理引脚测试或Gowin实现。

Windows原仿真入口保持scripts/run_sim.py；可用--test tb_multitimbral或--test tb_timbres单测，须按tools/manifest.json准备Icarus。仿真通过不代表实板音质或时序通过。

## 2026-10-19：瞬间爆音与分配器时序修复

用户最新反馈为起音/切换瞬间爆音，普通双键也可稳定触发，并非只限左上＋右下控制组合。下载副本19:43:59的当前实现报告已读取：综合133秒、P&R等188秒，音频要求61.44 MHz，报告Fmax仅5.499 MHz，1762个Setup违例、0个Hold违例；最差路径在allocator，180级逻辑、181.520 ns，远超16.276 ns单拍预算。该副本src与修复前仓库仅CST不同；这些是修复前报告，不代表当前源码的新STA。

原voice_allocator不再在一拍内通过不断变化的候选索引比较32次年龄。现在逐拍读取一个上下文，下一拍只比较寄存后的元数据，选定声部及其rank再寄存后才令note_ready有效。未握手时不修改所有权；frame_ce或enabled撤销会取消并重查，外部valid/事件/音色必须保持到握手。32声部无打断搜索上限68个audio_clk周期，约1.107 µs；帧边界重试与渲染回压额外计入等待。各声部rank以常量索引并行更新，消除候选链与rank[target]组合反馈路径。

三种波表、32声部、原音色操作、ADSR、总增益、PLL、PA、4 mA对照约束和键盘分离保持。单音幅度、三种音色普通双键反复起音/独立松键、32混合音色和每个串行码均对照数学参考；不是通过静音、削减声部或降低时钟掩盖问题。搜索等待改变了部分事件被接收的帧，满幅测试改用每四帧起一声部的同相刺激；frame_ce只在主时钟边沿采样，不把组合CE的仿真delta瞬态当成新帧。

最终验证共21,228,787次检查通过：23项RTL、1项官方PLL板级（含三种音色物理双键）、2种引脚映射，以及1/4声部与32声部同相满幅变体。32声部仍517周期交付，首个非零串行码3.176972 ms；这些均为数字仿真结果。证据及初次测试刺激失败见[本次验证](../reports/multitimbral_fix/2026-10-19/validation.json)。

本次维护源码在E:\gowin\fpga-instrument。请关闭旧下载目录工程，打开该目录原keyboard_adsr.gprj重新综合/P&R，先核对音频61.44 MHz和Setup/Hold通过，再进行SRAM试听；未确认前不能将生成.fs视为稳定验收。不执行Flash写入。当前尚未验证新Fmax、资源及实际爆音改善；收到新报告后按真实剩余路径继续处理。

## 2026-10-19：EX3937模块未识别

用户在E盘主工程报告EX3937：keyboard_top第22行实例化未知模块timbre_control。读取当次综合日志及impl/temp/rtl_parser_arg.json确认编译仍使用旧20个HDL文件，缺少timbre_control；磁盘主GPRJ实际已启用src/timbre_control.sv，共21个HDL、30项依赖，模块源码也存在。这是IDE仍使用旧文件列表的证据，不应复制第二个模块或改模块名称来绕过。

关闭旧工程后重新打开仓库根目录原keyboard_adsr.gprj，确认源文件列表包含现有timbre_control.sv，再由用户重新综合；若列表仍未刷新，添加该现有文件。IDE自动保存曾把IncludePath退回已废弃的E:/gowin/fpga-instrument/config，本次恢复已入库的src与src/config相对目录；没有更改其他工程设置。运行中的旧IDE仍可能再次保存旧配置，重新打开前不要用旧工程列表覆盖磁盘新版。

本次只修正配置回退并补充排查说明，未更改RTL，也未重新运行综合/P&R或烧录。HDL证据仍属于4901d8f的29个配置；EX3937在高云中的消失与新的STA须由用户重编译确认。

## 2026-10-19：上电曲谱试听

用户已确认上电自动播放一次，结束恢复键盘。现在默认播放《小星星》旋律与简单和弦：C调、120 BPM，42个旋律音符、48拍，约24秒。旋律使用笛管预设1，三音和弦使用正弦预设0。四条轨道沿用原1/32声部增益；没有为试听提高总音量或改变功放策略。谱例简谱如下，横线表示延长一拍：

```text
1 1 5 5 | 6 6 5 - | 4 4 3 3 | 2 2 1 -
5 5 4 4 | 3 3 2 - | 5 5 4 4 | 3 3 2 -
1 1 5 5 | 6 6 5 - | 4 4 3 3 | 2 2 1 -
```

播放期间矩阵仍扫描，但不向音源提交键盘事件，也不改变手动音色选择。曲终四条轨道依次松键，等RELEASE+4帧后恢复键盘；播放期间一直按住的键会在恢复后识别。手动键盘默认正弦，原对角组合键切换音色保留。播放不会自动循环；需要重播时按现有USR复位键，系统按原复位流程重新开始。

独立事件源src/score_player.sv使用audio_clk与frame_ce计时，回压时保持全部载荷。曲谱数据在src/config/demo_score.svh，FCW独立于矩阵键位表；身份0..3与键盘60..75分开。原keyboard_top只负责选通事件源，synth_core、分配器、波表、ADSR、PLL、CST/SDC与PA保持原样。原工程现22个HDL、32项依赖；必须关闭旧IDE工程并重新打开原keyboard_adsr.gprj，确认score_player.sv已在文件列表中，避免再次出现未知模块。

需要纯手动启动时，将原keyboard_top参数SCORE_ENABLE改为0；默认节拍SCORE_BEAT_FRAMES=24000，对应48kHz下120 BPM。移植键盘仍只替换输入适配器，曲谱源与音源无键盘专属耦合。

最终30个验证配置共17,323,372次检查通过，含完整120BPM曲谱计数、尾音、回压、一次播放、关闭功能、官方PLL顶层逐样本数学参考、曲终接回按住的键及USR重播，原手动/引脚回归继续通过。顶层音频测试缩短了节拍以控制仿真耗时，生产24000帧节拍与9604帧尾音由独立播放器测试完整验证。证据见[曲谱验证](../reports/demo_score/2026-10-19/validation.json)。未运行综合/P&R/烧录；试听前由用户确认新报告61.44 MHz与Setup/Hold通过，实际声音和爆音改善仍待实板确认。

## 2026-10-19：曲谱改为文件输入

原score_player已原位改成通用独立播放器，不再包含固定旋律、自动和弦或FCW函数。旧src/config/demo_score.svh已移除；请编辑src/scores/twinkle.txt并用scripts/compile_score.py生成twinkle.hex。顶层SCORE_FILE指定文件，SCORE_WORDS指定ROM容量；同步ROM在综合/配置时加载，换谱须由用户重新编译烧录。操作、格式、模块接口和验证见[播放器说明](score_player.md)。本次只迁移谱数据，不调整旧谱音色、伴奏响度或换音衔接，不能据此宣称音质已修复。

## 2026-10-20：默认旋律发音对齐键盘

原src/scores/twinkle.txt及hex改成正弦单旋律，按MIDI音高使用身份，42音/84事件，原音高节奏和门长保留。新音高独立声部、旧尾音保持原频率自然释放；重复同音保持键盘重触发语义，不强制清相位或截断包络。默认伴奏移除用于单旋律对照，通用文件播放器仍支持复音和三种音色。没有改变键盘扫描、音源RTL、增益、PLL、PA、CST/SDC。用户自行重新编译烧录，先听完整旋律及C4重复/G4换音，再确认曲终键盘、持键交接和USR重播。实际听感尚待确认；详见[播放器说明](score_player.md#2026-10-20默认旋律与键盘音质对照)。
