xixi-2380/fpga-instrument/docs/score_player.md

## 七音色兼容更新

本分支音色为3位，ID0..6，旧音色低2位/身份位置不变，高位使用bit41。原小星星hex不变；新命名cello/piano/guitar/vibraphone已可编译。详见[instruments.md](instruments.md)，注意新音色曲终释放时间。下方旧三音色格式如有冲突以本段为准。

# 独立文件曲谱播放器

`src/score_player.sv`只负责读谱、计时和发送音符事件，不包含歌曲、配和弦规则、键盘映射、波形或ADSR。`keyboard_top`负责曲谱/键盘事件源的选择，`synth_core`负责实际发声。当前默认仍为上电播放一次，尾音结束恢复键盘；USR全局复位重播。

## 修改或更换曲谱

1. 在高云IDE或文本编辑器中编辑原`src/scores/twinkle.txt`。
2. 在工程根目录运行离线转换（不启动综合或烧录）：

   ```powershell
   D:\py\python.exe scripts/compile_score.py src/scores/twinkle.txt src/scores/twinkle.hex
   ```

3. 用户自行重新综合、布局布线和烧录。FPGA通过`$readmemh`将`.hex`初始化为ROM；它不会在运行时读取电脑文件或SD卡。仅保存`.txt`不会自动更新ROM，转换后仍需重新生成并烧录位流。

选择另一份谱时，转换到对应`.hex`，将`keyboard_top`原参数`SCORE_FILE`改为工程根目录相对路径，例如`src/scores/my_song.hex`，并把该文件加入原GPRJ辅助文件列表；不要复制播放器或新建工程。`SCORE_WORDS`默认512，转换器的`--depth`必须与其一致；改容量时同步两者。关闭再重开原工程，确认文件列表已更新。

## 文本格式

每行：`起始拍 门长(拍) 身份:音高:音色 [其他音符...]`。例如：

```text
# 先休止半拍，再发两个不同音色的音符
1/2 1/2 60:C4:sine 64:E4:flute
1 3/4 67:G4:sine
end 2
```

- 起始拍与门长支持整数、小数或分数，但须落在1/4拍网格。门长必须大于0。
- 身份是0..127的独立音符标识，它不是硬件声部序号；实际音高仍由音高字段决定。默认旋律采用与键盘一致的MIDI音高身份，例如C4用60、G4用67。同一身份不能有时间重叠的音符；不同音高在旧尾音尚未归零时也不应复用同一身份，否则会沿用当前相位/包络直接换音高。不同身份可形成和弦；同一时刻先发送松音再起音，按身份升序发送。
- 音高支持`C4`、`F#4`、`Bb3`或MIDI数字；C4=60、A4=69。音色为`sine`、`flute`、`reed`，也可写0、1、2。当前波表按原键盘音域设计，扩大音域可能需要处理谐波混叠。
- 必须有且只有一条`end 拍位置`，不得早于任何音符松音。空拍自然形成休止；`end`晚于最后松音会保留末尾休止，之后再等待`TAIL_FRAMES`。
- 注释必须独占一行，以`#`开头，避免与升号冲突。
- 转换器离线计算48kHz下的32位FCW，验证音高、音色、时间网格、身份冲突、结尾和ROM容量。错误时不覆盖原ROM。

默认`SCORE_BEAT_FRAMES=24000`，即48kHz采样率下每拍0.5秒、120 BPM。公式为`BPM=60*48000/SCORE_BEAT_FRAMES`；该参数必须为正且为4的倍数。`.txt`的节拍单位不随ROM转换改变，速度由顶层参数控制。

## ROM与接口

ROM每行16位十六进制字符，对应64位指令；不足`SCORE_WORDS`的部分由转换器补END。默认《小星星》实际使用168字、42个旋律音符（84个起/松音事件），补到512字。低级格式如下：

| 操作 | [63:60] | 数据 |
|---|---|---|
| END | 0 | 其余为0；等待尾音后结束 |
| WAIT | 1 | [31:0]为1/4拍数量；其余为0 |
| ON | 2 | [40:34]身份，音色={bit41,bits33:32}，[31:0]FCW |
| OFF | 3 | 与ON相同的身份、音色与FCW |

同步ROM读取后，播放器通过`note_valid/note_ready`发送事件；回压时`note_on/id/fcw/timbre`和valid保持到握手。WAIT只在`frame_ce`计时，不派生时钟。逐条ROM读取与握手会增加少量指令开销，回压会延长曲长；本模块不是外部MIDI同步器。

`SCORE_FILE`、`SCORE_WORDS`、`ENABLE`、`BEAT_FRAMES`、`TAIL_FRAMES`为独立模块参数。模块只有audio_clk同域时钟、复位、启动许可、帧CE、事件ready输入，以及完整事件、busy/done/error输出；不访问顶层内部信号。ENABLE=0不加载谱文件，立即让出键盘接口。END必须在所有OFF之后，转换器保证这一点；非法操作码或无END导致ROM越界时error锁存、busy保持，须复位恢复，不交接未结束的曲谱。

2026-10-20默认试听谱改为正弦单旋律，保留42个音符、原音高、节奏、门长和约24秒曲长。以MIDI音高为身份，与键盘普通演奏一致：同音高重触发保留相位和当前包络，不同音高分配独立声部，从零幅度起音，旧声部按原200ms释放保持原频率。默认125ms间隔允许旧尾音与新音交叠，重复同音也仍可能从非零包络重触发，这是原键盘行为；本次没有全局缩短释放或硬切尾音。

移除默认同音区等增益三音伴奏和笛管旋律，以便与手动默认单键公平试听。单音增益仍为1/32，响度与原默认键盘单音一致，可能比旧四音和弦版轻。播放器与转换器仍支持任意合法谱文件中的复音、休止和三种预设，没有关闭通用复音功能。通过单旋律实板对照后，再另行评估低音区伴奏和主伴奏平衡。

## 验证与上板

纯HDL验证覆盖完整默认谱、生产24000帧节拍、另一份含休止/升降号/不同音色与身份的文件、回压、复位、关闭播放、无尾音、非法操作码和越界；顶层通过原官方PLL模型与独立音频数学参考检查曲谱/键盘交接。转换器测试见`sim/test_compile_score.py`，最终记录见`reports/file_score/2026-10-19/validation.json`。

已读取用户此前21:09:15实现报告：Setup/Hold各0，音频目标61.44MHz、Fmax61.535MHz。该报告属于文件播放器修改前，不能当作本次新ROM结构的时序/资源验收。本次仅改文件、运行仿真，新的综合/P&R/烧录和试听由用户执行。

最终35个HDL验证配置共17,327,941次检查通过，另有6项离线谱转换器测试；含完整生产节拍、替换谱、键盘交接、边界/错误路径和原手动/引脚回归。证据见[本次验证](../reports/file_score/2026-10-19/validation.json)。没有执行EDA或烧录，新资源、STA与试听由用户确认。

## 2026-10-20：默认旋律与键盘音质对照

新增tb_score_articulation将实际score_player、voice_allocator、生产参数ADSR和共享DDS一起验证，完整保留24000帧/拍与480/4800/45875/9600包络参数，仅将外部CE间隔压缩为64个仿真时钟以缩短运行。覆盖前3个音C4、重复C4、G4及旧尾音释放：重复C4保持原相位/当前包络；G4使用另一个声部并从零幅起音；旧C4尾音频率不变且自然归零。232004次DDS采样按独立正弦数学参考检查相位与波形。这是组件验证，不替代61.44MHz串行输出时序或模拟音质测量。

官方PLL顶层测试覆盖全部42音/84事件、逐样本数字音频、曲终接回按住的A4和USR重播，但该顶层用短节拍/短包络加速。完整生产曲长另由播放器计数测试验证。当前验证见[本次记录](../reports/score_quality/2026-10-20/validation.json)，旧35组文件播放器回归记录保留为历史证据。

当前默认谱与键盘可使用相同MIDI身份；两者由顶层互斥选通，曲终等待全部尾音归零后才交接，因此不会同时占有同一身份。更换曲谱时仍须保留所有松音事件及最终尾音等待。

本次5个HDL验证配置共7,038,771次检查与7项谱转换器测试通过，含生产参数换音组件、完整生产节拍、官方PLL顶层音频/键盘交接以及另一份多音色复音谱。验证记录：reports/score_quality/2026-10-20/validation.json。实际音质仍待用户试听。
