xixi-2380/fpga-instrument/docs/max98357.md

# 外接 MAX98357A 音频输出（2026-10-23）

用户决定从板载PT8211改为外接MAX98357，先完成数字输出迁移，随后明确指定BCLK=V22、LRC=W19、DIN=Y20、SD=V26。现已在原工程加入这四个引脚及输出路线预算；合并后的main保留32声部合成、键盘、文件播放器、RGB、乐器UI、运行时效果参数，并按用户后续要求默认启动触摸。

## 资料依据与选型边界

用户资料根目录：`E:\FPGA竞赛\开发板资料\MAX98357_TEST\MAX98357_TEST`，只读。

- `原理图.png`标注MAX98357A和I2S Mono Amp；播放接线图也标MAX98357A。
- `esp32_MusicPlayer-master/README.md`明确使用MAX98357A，I2S.cpp采用16位双声道I²S。仅参考协议，不移植ESP32、TF卡或预录PCM播放逻辑。
- `MAX98357 datasheet.pdf`同时覆盖A/B：第16页Tables 2/3给出采样边沿和左右极性；第19页说明I²S一位延迟；第20页Figure 6给出每声道16位时序。资料允许48kHz，不需MCLK。A版LRCLK低为左、B版高为左且左对齐，二者不兼容。
- 第17页Table 5说明SD_MODE既是关断又是声道选择；第4页有开机时间规格。当前按资料中的**A版**实现；如果实物芯片是B版，不能直接使用本配置。

MAX98357A是带PCM输入/DAC的单声道D类功率放大器；扬声器接模块的OUT+/OUT-差分输出，不把OUT-当GND。供电、扬声器阻抗、GAIN和SD_MODE外围电阻须按实物模块核对，不从FPGA GPIO供电；数字信号采用用户下方指定的接线。

## 新顶层端口与用户指定接线

| 端口 | FPGA球位 | 模块端子 | 含义 |
|---|---|---|---|
| MAX_BCLK | V22 | BCLK | 1.536MHz位时钟；audio_clk=61.44MHz，每20周期翻转 |
| MAX_LRCLK | W19 | LRC / LRCLK | 48kHz左右声道时钟；低为左，高为右 |
| MAX_DIN | Y20 | DIN | 有符号16位二进制补码，MSB先发，标准I²S |
| MAX_SD_MODE | V26 | SD / SD_MODE | 复位/失锁低；运行时高，实际选声道还受模块外围影响 |

当前左、右发送同一混音样本；模块即使经外围选择右或左右平均，内容仍一致。增益和混音比例不变，没有软件改模拟GAIN，也没有添加MCLK、I²C配置或新PLL。

旧`HP_BCK/HP_WS/HP_DIN/PA_EN`及`DBG_BCK/DBG_WS/DBG_DIN/DBG_PA_EN`全部固定低，停用板载DAC/功放与旧镜像；旧端口及其球位仍保留，继续固定低。新音频仅由上表MAX_*四个球位输出，与旧DBG的U22/V19/W20/U26不同。

**2026-10-23已按用户指定更新src/keyboard.cst：V22/W19/Y20/V26，均为LVCMOS33、3.3V Bank声明、4mA驱动、无内部上下拉。** 官方参考CST对应pin_header[37]/[35]/[33]/[31]，四个球位与现有键盘/LCD/触摸/旧音频无冲突；约束声明不能替代实测电压。src/keyboard.sdc将原音频输出0..30ns路线预算转到四个MAX_*端口，不新建BCLK内部时钟，不放宽内部音频时序。SD_MODE关断仍是异步复位行为。用户需重新综合/P&R，检查实际Bank/IO匹配、61.44MHz音频域及全部Setup/Hold，再自行烧录；本轮未执行EDA，不能宣称已通过Gowin约束解析或STA。

模块VIN/VDD接真实稳压5V电源，GND与FPGA真实GND共地；不从GPIO取电。GAIN先保持模块默认，SD_MODE不要同时直连电源和FPGA输出。喇叭只接模块OUT+/OUT-，OUT-不能接地；V22/W19/Y20/V26也都不是GND。

原`scripts/build_keyboard.py`保留MAX_*缺少IO_LOC时的前置拒绝，当前四路映射已齐全；本轮未执行该脚本。IDE不经过该保护，用户仍需检查新约束及新实现报告。该保护不代替SDC或Bank电气审查。

## 串行实现与帧边界

原`src/pt8211_tx.sv`及其TB原位重命名为`src/i2s_tx.sv`、`sim/tb_i2s_tx.sv`，同步原GPRJ和synth_core实例，不保留第二套旧DAC通路。

原audio_timing与frame_buffer不改：每1280个audio_clk一帧、每帧32个BCLK、每声道16位。在bit_index=0锁存新的左右样本，LRCLK降为左，但当拍DIN仍完成**上一帧右声道LSB**；下一个BCLK才是左MSB。在bit_index=16，LRCLK升为右，当拍仍是左LSB；之后才是右MSB。右LSB在下一个帧边界完成。这保证16位时没有额外插零、丢最低位或声道混帧。

I²S数据与LRCLK在BCLK下降沿对应的audio_clk更新，接收器在BCLK上升沿采样。复位LRCLK为1、DIN和缓存为0；首次LRCLK下降用于同步，首个有效左MSB仍滞后一位。测试接收器从外部BCLK/LRCLK/DIN边沿解码，不通过DUT索引猜位序；数学参考锁存同一立体声对，防止右LSB跨帧时错用下一帧样本。

原32声部渲染517/544周期、48kHz帧率、音符事件回压、ROM/ADSR/增益、PLL和像素/触摸接口保持。串行有效码边沿比旧格式移动一个BCLK；实际听感、启动、模拟电平和新器件资源/STA不由数字仿真证明。

## 外接功放启动

MAX_SD_MODE在audio_reset释放后的第二个音频帧边界拉高；这已经越过第一个完整LRCLK周期，时钟和零数据持续运行。生产默认480帧静音为器件上电留出超过7.5ms后才允许音符事件进入，随后仍沿用240帧启动淡入。复位或PLL失锁立即拉低MAX_SD_MODE，清空串行器；空闲/松键仍保持有效时钟和数字零，不频繁切换SD_MODE。

内部`input_ready`及`synth_core.pa_enable`仍表示原音源启动完成，不能再解释为板载PA_EN，也不等于外部MAX_SD_MODE：后者为了预热会先拉高。缩短MUTE/FADE的集成TB只用于加速，不声称验证了模拟开机时间；专用启动TB使用生产默认静音参数。

## 验证和后续工作

本轮纯HDL验证在`reports/max98357/2026-10-23`，最终索引为`validation.json`。覆盖独立左右数据、正负满幅/行走位/随机字、同帧接收与发送、输入变化防撕裂、欠载补零、字中复位、32声部与音色精确数学参考、官方PLL顶层启动、曲谱到键盘交接、旧板载输出停用、触摸关闭与RGB回归。原CST物理键盘测试只验证键盘行列，不代表已配置外置DAC引脚。

本次不执行Gowin综合、P&R、烧录/JTAG，也不清除已有UI/触摸报告和用户IDE配置。沿用当前本地功能基线，不自动合main；Git只提交本次改动，按最近约定推送`codex/fpga-migration`分支。

最终37个HDL验证配置共36,974,883次检查通过，官方PLL启动验证SD_MODE到input_ready间隔9979.141µs；32声部渲染仍517/544周期。源文件/约束保护及日志见[本次验证](../reports/max98357/2026-10-23/validation.json)。这些是数字仿真，不代表新器件的引脚、电气、STA或音质已验收。

## 用户指定引脚后的补充验证

在数字迁移基线5afa193上仅增加用户指定CST及SDC路线预算，顶层和构建脚本只修正过时注释，无功能RTL变更。54个端口球位无重复，原50个端口的球位和电气属性保持；四个MAX球位与官方Header定义对应。14条平面SDC命令仅替换两条音频输出端口列表，未运行Gowin解析。原构建映射保护经独立提取检查通过，未执行构建脚本。

复跑既有I²S接收解码与官方PLL生产启动两项纯HDL仿真，共1,856,631次检查通过；SD_MODE到音频事件准入仍9979.141µs。其余音源、曲谱、RGB、触摸关闭配置及已有IDE配置通过哈希/逻辑比对保持。证据见[引脚补充验证](../reports/max98357/2026-10-23/pins/validation.json)。CST不参与纯HDL仿真，仿真通过不代表新引脚已通过电气、P&R或STA验收。
