xixi-2380/fpga-instrument/docs/touch_gt9110.md

> 2026年10月23日：本文件保留周建涛分支的硬件和历史实现记录。最新整合界面与控制连接见[instrument_ui.md](instrument_ui.md)，显示状态现为64位、渲染为两级寄存器；main已按用户要求默认启动触摸采集和触摸UI。

# GT9110 触摸读取首版

2026-10-22 用户明确要求“先写一版触摸的”。本版接入用户指定的四根线，初始化并读取 GT9110，将触点数量、首触点原始坐标和触摸状态送到 RGB UI。**当前为HDL仿真通过的实现，尚未实板验证**。不增加触摸调音量、调音色、演奏或手势；音频源、键盘手势和曲谱行为保持。

## 接线与电气边界

| 顶层端口 | 用户指定球位 | 示例CST对应 | 实现 |
|---|---|---|---|
| touch_scl | AB26 | pin_header[21] / J23-24 | 开漏I²C时钟，拉低/释放，支持时钟拉伸 |
| touch_sda | U25 | pin_header[19] / J23-22 | 开漏I²C数据，拉低/释放 |
| touch_int | V23 | pin_header[17] / J23-20 | 复位选址时拉低，此后高阻；不依赖中断极性 |
| touch_rst_n | R23 | pin_header[11] / J23-14 | 低有效复位，拉低/释放，与USR全局rst分开命名 |

四个球位与原24个端口及22个LCD端口均无冲突，主CST共50个端口。依据用户最新映射修改触摸信号，键盘或音频引脚保持。触摸端口采用所在Bank 2/3的LVCMOS33/3.3V，DRIVE=4、PULL_MODE=NONE。**四根线均不主动输出高电平**，高电平由外部模组上拉提供；不把FPGA内部弱上拉当I²C上拉。GT9110手册要求/RSTB外部10k上拉，模组SCL/SDA上拉及其实际电压尚无接口图/实测，首版没有假定上拉已实测合格，也没有用GPIO给触摸板供电。

**供电接线纠正：用户同时提出P25接GND、T25接VDD，但这两个球位都是FPGA信号IO，不能作为触摸板电源。** 示例CST分别将其列为`pin_header[15]`、`pin_header[13]`；底板原理图第16页对应J23-18、J23-16，均不是电源。本版不增加供电GPIO、不主动驱动它们。触摸板GND须接板上真正GND（例如J23-12）；VDD须接符合模组额定电压的板上电源，模组额定电压仍未确认，不能据3.3V IO配置推定。不要误用J23-11的+5V。若模组已确认使用3.3V，可从PMOD J22的1/2脚取+3V3，3/4脚为GND；按连接器标号定位，不凭排针朝向推断。

历史PR2028/PR2017来自旧映射N18/R16/R17的CPU/SSPI保留功能，旧证据仍保留在[专用管脚复用核查](../reports/display/2026-10-22/touch_pin_reuse/validation.json)。用户现已改选四根信号到AB26/U25/V23/R23，已有封装报告显示前3个无专用功能标记，R23为D16；此次不再依赖旧CPU/SSPI GPIO复用开关，原编译Tcl移除强制释放选项，工程CPU/SSPI恢复false。JTAG/MSPI及其他IDE设置保持。新约束仅完成静态映射/占用核查，实际布局仍待用户执行；见[改线核查](../reports/display/2026-10-22/touch_header_remap/validation.json)。

用户已表示没有其他资料，不再以补充手册为前提暂停代码。依据为用户目录 `E:\FPGA竞赛\开发板资料\屏幕及触摸屏` 中GT9110中文PDF（22页，正文Rev.02）；读过相关完整页并查看上电时序图。原件保持只读，来源路径、摘要和SHA256见[硬件依据](../reports/display/2026-10-22/hardware/source_manifest.json)。此触摸芯片通过独立四线连接；屏幕PDF的40P第37..40脚为X1/Y1/X2/Y2，不能把这些电阻触摸引脚当作本版电容触摸I²C。

## 初始化与读取

[gt9110_touch.sv](../src/gt9110_touch.sv) 在50MHz `clk` 域独立运行，复位来自原工程的 `pll1_reset`（包含POR/USR），不依赖像素时钟或音频事件许可。默认时序：/RSTB与INT同时拉低20ms；释放/RSTB，再保持INT低6ms；释放INT，再等待50ms，约76ms后首次查询。20ms/6ms计数分别超过手册上电图的大于10ms、大于5ms间隔；实际供电顺序和引脚波形仍未测量，不能据计数宣称电气时序已验收。额外50ms是首版启动等待裕量，不冒充手册给出的精确就绪时间。拉低INT选定8位地址BA/BB，即通常I²C API使用的**7位地址0x5D**。

先读 `0x8140` 的4字节产品ID，再读 `0x8146` 的4字节X/Y输出分辨率；不硬编码某个ASCII ID为唯一合法返回值。成功后 `ready=1` 表示这两次查询完成，`error` 另行表示通信/数据故障。没有向 `0x8047..0x8100` 写入未经模组校准的配置，也不强制将触摸分辨率改为800×480。

随后每10ms轮询一次 `0x814E` 起的9字节：状态、首触点ID、X低/高、Y低/高、尺寸低/高、保留字节。状态bit7为新数据，低4位为触点数量；无新数据保留上一份已确认报告。新数据读完后，仅向 `0x814E` 写0清除已消费状态，**清除写操作收到ACK并完成STOP后**才原子发布本次坐标与数量。若清除NACK，不把候选坐标当成成功报告。

`touch_count`支持0..10，首版仅导出第一个触点的完整坐标/尺寸/ID，其他触点的坐标尚未读取或导出。0点新报告表示松手，清除down、数量、坐标、尺寸与ID；数量11..15视为异常并清除按下状态。通信NACK或总线超时会置error并清除down/数量，保留上一份确认坐标作诊断；失败后等待10ms重试对应查询，不阻塞音频或死等总线。错误标志由完成初始化或下一份有效触摸/松手报告清除，无新数据的轮询不会抹掉错误。没有加入九脉冲强制总线恢复或自动重写芯片配置。

## I²C 主机与显示

[i2c_register_master.sv](../src/i2c_register_master.sv) 使用主时钟和计数器完成16位寄存器地址事务：单字节写、1..9字节读、重复START、中间字节ACK和最后字节NACK。SCL/SDA各两级同步，释放SCL后等待真实高电平，支持有界时钟拉伸。50MHz、`HALF_CYCLES=250`，名义100kbit/s；同步等待使实际速度略低于100kbit/s。写数据在SCL下降后保持25时钟（0.5us），随后在低电平中间更新，留出4.5us数据建立时间；依据手册表列0.4us加入保持裕量，实际上拉/边沿仍待测量。默认释放SCL/总线等待超时为50000时钟（1ms），卡线时释放两线并报错。假设总线上只有一个主机，不实现多主仲裁。

触摸状态在参考时钟域形成39位原子快照：`{ready,error,down,count[3:0],x[15:0],y[15:0]}`，通过独立 `rgb_status_cdc WIDTH=39` 握手送入像素域，在消隐帧起点更新。它与音频状态快照分别传输，显示不向I²C或音频施加回压。

正常UI底部显示 `TOUCH`：等待初始化为琥珀色 `WAIT`，查询成功且松手为绿色标签加 `UP`，按下时显示5位十进制原始X/Y及2位触点数量，通信/数据错误显示红色 `ERROR`。首点处绘制十字，坐标越界时不画标记，仍显示完整16位原始数值。**没有猜测坐标旋转、交换、缩放或校准**；如果方向不同，实板反馈后在输入适配层处理。`LCD_TEST_PATTERN=1`时整屏彩条覆盖UI与标记，验证触摸请保持默认0。

## 参数、验证和用户上板

用户后续要求启动触摸，顶层当前默认 `TOUCH_ENABLE=1`、`TOUCH_UI_ENABLE=1`、`LCD_ENABLE=1`、`LCD_TEST_PATTERN=0`。复位释放后按生产时长初始化并轮询；只有ready、无错误、800×480、单点且坐标有效时才执行UI动作。此前实板 `TOUCH ERROR` 仍提示需检查供电、上拉和电平，默认启动不等于该电气问题已解决。可调整的仿真/启动参数在 `keyboard_top`：`TOUCH_RESET_CYCLES`、`TOUCH_STRAP_CYCLES`、`TOUCH_BOOT_CYCLES`、`TOUCH_POLL_CYCLES`、`TOUCH_I2C_HALF`。生产默认时长见上文，不为实板缩短到测试值。

`tb_gt9110_touch`独立模拟从机协议，验证ID/分辨率、1点/10点数量及首坐标、松手、无新帧、所有地址阶段NACK、清除NACK、异常数量、拉伸、超时、重试和复位；分别用加速半周期4和生产半周期250。两组功能测试只缩短启动/轮询计数；`tb_gt9110_boot`另用完整生产20ms+6ms+50ms计数，检查启动约76ms、INT释放和启动中复位。`tb_i2c_register_master`另覆盖非法读长度、SCL/SDA卡线、忙时输入命令忽略和字节中途复位。渲染与显示测试覆盖原子触摸快照、边角/越界十字和错误文字；最终结果、失败修正记录和验证范围见[本轮验证](../reports/display/2026-10-22/touch/validation.json)。仿真从机不是实测GT9110，不证明板上电压、上拉、实际芯片型号或触摸方向。

用户自行关闭旧源码页，关闭再重开 `E:\gowin\fpga-instrument\keyboard_adsr.gprj`，确认28个HDL/39项依赖以及新顶层LCD/触摸端口已加载，再运行综合/P&R。实现报告须包含音频61.44MHz、像素35MHz及参考50MHz，Setup/Hold均无违例；核对3个PLL、全部50个球位和新CDC的实际布线/延迟，旧STA不适用。助手没有运行EDA或烧录。

RGB部分使用Sipeed官方Pro 800×480的**试亮参考配置**，不是已确认的本屏厂家时序，详见[显示说明](rgb_display.md)。烧录后先确认UI是否稳定，再观察TOUCH WAIT是否变UP；单点按下/松开并核对各控件，再测四角与两点数量。若ERROR，按已给接线检查触摸板供电、四线电平/上拉和复位释放，保留实测结果，不以纯HDL结果认定物理连接成功。只有底部显示READY时触摸才会改变UI设置；自动曲谱结束后仍按原规则恢复键盘。
