xixi-2380/fpga-instrument/docs/handoff_rgb_display_2026-10-22.md

# RGB 屏显示开发交接（2026-10-22）

这份文档供新窗口继续 FPGA 乐器工程的 RGB 屏/UI 显示工作。用户最新明确：**本窗口只输出交接文档，不编写 UI，不合入新分支；后续基于本地版本工作。** 本地未新增显示驱动、改动音频 RTL、运行 EDA 或烧录。下述已实现功能、用户反馈、建议方案和待确认信息分开记录。

**屏幕已确认：800×480，使用底板自带的 40P FPC 接口。** 用户已仔细核对，**引脚定义与其提供的示例CST一致**，后续按该示例接入，不再把映射关系当成未经用户确认。完整型号、像素总线位宽、时序和电气参数仍需从相应资料确定；不要据分辨率自行指定PCLK或RGB565/RGB888。本次没有新增任何屏幕引脚约束。

用户所指“示例CST”应在新窗口定位到具体文件。当前对话未给出该屏幕示例的明确路径；仓库中的通用全引脚CST不能未经核实就当作这份屏幕示例。若文件找不到，只询问文件位置，不重复要求用户核对已经确认一致的引脚。

## 1. 新窗口先做什么

1. 读取根目录 [AGENTS.md](../AGENTS.md)，再读本文件及 [模块接口](interfaces.md)、[播放器说明](score_player.md)。AGENTS/README 含历史累积段落，旧的“20 个 HDL”“尚未多音色”“未提交/不推送”等不能覆盖后续明确记录；按当前源码与最新用户指令判断。
2. 核对 `git status --short`、当前分支与提交，保留队友和 IDE 已有改动。不要直接 pull、reset 或恢复文件覆盖现场；需要同步时先检查本地/远程关系。
3. 分辨率已知为800×480，连接为底板自带40P FPC。引脚已由用户核对与所提供示例CST一致，先定位并读取这份示例，不重新猜映射。接着确认屏幕完整型号或对应数据手册、总线位宽、时序和电气参数；未提供的参数不能猜。型号的作用是找到正确规格；若能直接给出完整手册和引脚表，也不必只纠结商品名。
4. 当前目标按用户描述是800×480 RGB屏接底板原有40P FPC，不按此前讨论的HDMI或SPI TFT方案实施。引脚采用用户确认的示例CST；实际RGB信号位宽、DE/HS/VS模式、可能的初始化接口和电气参数仍按相应资料确定。
5. 读取用户确认的示例CST后列信号/球位/排针/电压冲突表，提出最小点亮方案并实施对应文件及 HDL 仿真。先纯色/彩条，再接入乐器状态；显示工作不顺带扩展音频效果或超声波。

可直接复制给新窗口的起始提示：

> 请先读取 E:\gowin\fpga-instrument\AGENTS.md 和 E:\gowin\fpga-instrument\docs\handoff_rgb_display_2026-10-22.md，基于本地版本继续 UI/RGB 屏显示。屏幕为800×480，使用底板自带40P FPC接口；引脚我已仔细核对，与我提供的示例CST一致，请定位并采用该文件，不重新猜引脚；再确认完整型号或对应手册、时序/电压及希望显示的内容。先不要合入远端新分支。保留本地音频、键盘和播放器；助手只修改文件、运行纯HDL仿真、读取报告，综合/P&R/烧录由我执行。按原文件维护，完成有意义的更新后中文提交Git；远端main当前存在未合入的新功能，不能强推或为推送自行合并。

## 2. 工程位置、Git 与操作分工

| 项目 | 当前值 |
|---|---|
| 唯一维护目录 | `E:\gowin\fpga-instrument` |
| 主工程 / 顶层 | `keyboard_adsr.gprj` / `keyboard_top` |
| 输出名 | `D2_keyboard_leds` |
| 器件 | `GW5AST-LV138FPG676AC1/I0`，Device Version C |
| 板卡资料 | Tang Mega 138K Pro；底板参考 4071f3，核心板 4071/4072 文档均保留 |
| 当前功能源码基线 | `f2855067ccd2160c6bfe724c15aeac7e0d5f90e1`（2026-10-20 默认曲谱发音对齐键盘）；`852e195`仅新增交接文档，之后本窗口仍只改文档 |
| 本地分支 | 交接前为 `codex/fpga-migration`，开始时重新核对 |
| GitHub | 私有仓库 `https://github.com/xixi-2380/fpga-instrument` |
| origin | `https://github.com/xixi-2380/fpga-instrument.git` |
| 推送约定 | 原约定 `git push origin HEAD:main`；当前远端分叉且用户禁止合并，暂不执行，不强推 |
| 老迁移来源 | `E:\gowin\fpga-instrument-mega138k-pro`，保留只读，不继续同步修改 |
| 聊天工作区 | `C:\Users\x1767\Documents\ChatGPT\FPGA项目`，不是 FPGA 源码仓库 |

用户持续授权：每完成一项有意义的更新并通过适当检查，自动中文提交Git并按约定同步私有仓库；最新“先不要合入新分支、基于本地版本”优先。本次推送发现远端main已到`837748c`，包含队友回声与独立板载按钮更新；只获取过记录。一次未提交合并已经`git merge --abort`撤销，本地源码仍是f285506系列，没有合入这些功能。**新窗口不能自动pull/merge/rebase远端功能，也不能强推覆盖main。** 当前可完成本地提交；若需要GitHub同步，另行明确分支安排，不为同步擅自合并。

只提交当前工作，保留他人改动。文档更新做内容、链接及差异检查即可，不为纯文档重跑全部HDL。此次合并撤销前后原有IDE配置字节一致；没有遗留进行中的合并。

助手允许修改 RTL/约束/脚本/文档、运行 Icarus/vvp 等纯 HDL 仿真、读取已有报告。综合、布局布线、SRAM 下载、Flash 烧录、Programmer/JTAG 均由用户执行；不要运行 `gw_sh`、Gowin 编译流程或 `scripts/build_keyboard.py`。该脚本会启动 EDA，即使名字含验证/打包，也不能自行执行。

修改已有功能直接编辑原文件，不建立 `_new/_fix/v2` 副本或第二个工程。独立显示驱动/跨域适配器及其 TB 可按实际需求新增；原 `keyboard_top`、GPRJ、CST、SDC 在原位接入。不要自动移动整个源码目录、删除旧报告或重排音频模块。

## 3. 当前功能与最新边界

- 50 MHz 参考时钟，经现有 PLL 形成 32 MHz、61.44 MHz；音频采样 48 kHz，每帧 1280 个 audio_clk 周期。音频控制使用主时钟和 CE，不使用组合派生时钟。
- 32 个独立逻辑声部，32 位相位、4096×16 波表、24 位声部、40 位混音、16 位 DAC；共享 DDS/ROM、增益和顺序混音，每帧实际 517 周期交付，预算 544。
- `keyboard_core` / `key_note_events` 是可替换矩阵输入适配器，`synth_core` 只接收 `note_valid/note_ready` 与 on/id/fcw/timbre。保持键盘、音源、播放器和显示分离。
- 三种合成音色：0 正弦、1 笛管风格、2 簧管风格；不是原声采样。手动默认正弦。精确左上角+右下角组合键切换音色，完全松开后才能再切换；不改这一既有手势。
- 默认上电播放一次约 24 秒《小星星》，42 个旋律音、84 个 On/Off，120 BPM。2026-10-20 已改正弦单旋律，移除默认同音区伴奏，以 MIDI 音高作为身份，保留换音旧尾音；同音重触发沿用键盘语义。
- 独立 `score_player` 通过 `SCORE_FILE` 读取 ROM 谱，当前 `src/scores/twinkle.hex`；可编辑源为同目录 `twinkle.txt`。ROM 在综合/配置时初始化，不是运行时读取电脑或 SD 卡。原通用播放器仍支持其他谱的复音/多音色。
- 曲终等待释放尾音后恢复键盘；播放期间按住的键在交接后识别；USR 复位重播。`SCORE_ENABLE=0` 可回到纯手动启动，显示任务不要擅改默认行为。
- 目前没有显示 RTL、像素时钟或显示顶层端口，也没有运行时总音量调参接口。不要把“建议实现”写成“已经支持”。

当前基线中 GPRJ 实际启用 22 个 HDL、2 个约束、4 个配置头文件、3 个音色 ROM 和 2 个琴谱文件，共 33 项依赖。文件列表以当前 XML 为准；新增显示模块时同步该原工程。

## 4. 音频问题与验证证据

用户此前已确认启动修复、接口分离和四声部版实板正常，后来也定性确认 32 声部单键发声。不能据此宣称最新文件播放器/单旋律版、32 音满载、当前音质或长稳已经实板验收。

2026-10-19 用户报告普通双键起音爆音；原分配器组合搜索链严重超时，已改逐拍读取/比较、注册目标后握手。旧失败报告 3.994/5.499 MHz 和大量 Setup 违例属于修复前，不能再当当前报告。

交接时读取到的现有 P&R 报告：`impl/pnr/D2_keyboard_leds.tr` 创建于 **2026-10-19 21:40:59**，音频目标 **61.44 MHz**、Fmax **61.566 MHz**、Setup/Hold 违例各 **0**。它早于 2026-10-20 默认谱数据调整，绝不能作为未来显示版或当前所有修改的实现验收；屏幕像素时钟、显示输出约束和新增 CDC 也没有被它验证。

| 证据 | 范围 |
|---|---|
| [默认曲谱衔接验证](../reports/score_quality/2026-10-20/validation.json) | 5 个 HDL 配置、7,038,771 次检查，另有 7 项谱转换器测试 |
| [文件播放器验证](../reports/file_score/2026-10-19/validation.json) | 历史 35 配置、17,327,941 次检查；默认谱当时为笛管+和弦，不能套用其默认编排描述 |
| [分配器修复验证](../reports/multitimbral_fix/2026-10-19/validation.json) | 历史 29 配置、21,228,787 次检查；包含普通双键与音色、32 声部相关验证 |
| [键盘与音频验收说明](bringup_keyboard.md) | 实板操作、物理键盘、引脚和噪声历史 |

生产参数衔接 TB 使用真实 24000 帧/拍与 480/4800/45875/9600 ADSR 参数，覆盖 C4、重复 C4、G4 及旧尾音，外部 CE 间隔压缩为 64 个仿真时钟。官方 PLL 顶层逐样本测试用短节拍/短包络加速。完整生产曲长另有播放器计数测试。以上都不是模拟音质验收，也没有新显示验证。

底噪曾被用户归因于耳机阻抗，但 2026-10-19 又重新报告并测到 BCK 同步尖峰，因此“已确定耳机阻抗是唯一原因”不是现行结论。现 CST 六路音频串行/镜像驱动为 4 mA 对照，PA 保持原值；物理效果没有最终确认。显示开发不顺带改音频 PLL、功放、增益、静音、驱动强度或关闭镜像。

## 5. 引脚、参考资料与尚未确定的屏幕硬件

当前占用球位来自原 [keyboard.cst](../src/keyboard.cst)，新增屏幕约束必须检查冲突和实际 Bank 电压：

| 用途 | 已用球位 |
|---|---|
| 参考时钟 / 高有效 USR 复位 | P16 / U4；U4 属 1.5 V，保留内部下拉 |
| PT8211 BCK / WS / DIN / PA_EN | E22 / F24 / G24 / H17 |
| J23 调试镜像 BCK / WS / DIN / PA_EN | U22 / V19 / W20 / U26 |
| 键盘列 0..3 | W25 / M24 / Y25 / AA24 |
| 键盘行 0..3 | W26 / L22 / Y26 / AA25 |
| 逻辑 LED 0..5 | R26 / J14 / L20 / M25 / N21 / N23 |

J23 的 V22/W19/Y20/V26 不是地，不能把相邻排针一排当作 GND。原理图与全引脚 CST 对部分 PMOD 总线位序命名不同；要以球位、连接器针号、实际电压交叉核对，不能只按 `pmod_x[n]` 名字推断接线。PMOD1/2 列出的信号当前未被主 CST 使用，也不等于已核实满足屏幕数量、供电和时序要求。

本地只读参考：

- [底板 4071f3 原理图](../references/TANG_MEGA-138K_Dock-4071f3__Schematics.pdf)：连接器/PMOD 可从第 16 页开始核对，仍以具体页内容为准。
- [另一版底板原理图](../references/TANG_MEGA-138K_Pro-Dock-4071f_Schematics.pdf)。
- [核心板 4071 原理图](../references/TANG_MEGA-138K-Pro_4071_Schematics.pdf) 与 [4072 原理图](../references/TANG_MEGA-138K-Pro_4072_Schematics.pdf)。
- [用户指定全引脚 CST](../references/tang_mega_138k-pro_pins.cst)、[资料来源清单](../references/manifest.json)。用户原件位于 `E:\FPGA竞赛\开发板资料\09_Misc\tang_mega_138k-pro_pins.cst`。

屏幕信息分已确认与待确认：

| 必须确认 | 需要拿到的信息 |
|---|---|
| 已确认：分辨率 | **800×480** |
| 已确认：连接方式 | **底板自带40P FPC接口** |
| 已确认：引脚映射 | **用户已仔细核对，与其提供的示例CST一致**；新窗口先定位并读取该文件，再检查与当前音频/键盘约束的资源冲突 |
| 屏幕与转接板型号 | 完整型号或对应厂家手册；引脚按已确认示例CST，未给出的电气/时序另查 |
| 信号接口细节 | 用户称RGB屏；由手册确认RGB位宽与顺序、DE/HS/VS模式、附加初始化接口；不照搬HDMI/SPI TFT驱动 |
| 电气与背光 | 屏电源、IO 电压、背光电压/电流及驱动板；背光不默认由 GPIO 直接供电 |
| 并行 RGB 时序 | 有效区已知800×480；PCLK范围/采样沿、HS/VS/DE极性、前后肩与同步宽度待手册确认 |
| 初始化（若适用） | 是否另需 SPI/I2C/8080 初始化及其命令时序，不假设所有 RGB 屏都只接像素总线 |
| 物理接线 | 按用户已核对的示例CST实施底板40P FPC接线；新窗口定位示例文件与连接器，保留所有已用音频/矩阵引脚，不自行改线 |
| 首屏目标 | 纯色/彩条、音色/音符/声部状态，或波形；触摸、频谱、复杂 UI 尚未确定 |

## 6. 建议的显示结构与实施顺序（尚未实现）

按800×480 RGB屏+底板40P FPC目标，建议独立像素时序、像素内容生成和显示状态快照三部分。先核对资料确认实际信号接口；如果手册与当前称谓不符，先说明差异，再选择驱动，不能按连接器外形猜协议。

1. 按手册整理参数表，像素时钟以 `H_TOTAL × V_TOTAL × 刷新率` 核算，并检查板上参考时钟/可用 PLL 资源。不要改变现有音频 PLL 配置；新增像素域复位随本域稳定条件释放。
2. 建立最小驱动与 TB。并行 RGB 测试逐行逐帧计数、同步/DE 极性、有效区尺寸、消隐、输出寄存和复位；有初始化接口则额外验证序列与等待时间。
3. 用纯色、彩条、边框等可直接生成的图样先点亮。首版不预设 DDR 或全帧缓存；需要缓存时先按分辨率与色深计算容量/带宽，再选择方案。
4. 显示模块只接收稳定的 UI 状态/采样数据，不直接读取按键电路或控制音源。音频域到像素域的多位音符、音色、计数等通过原子快照握手或异步 FIFO；不能每位各串两级寄存器就当多位一致。
5. 先显示少量状态，例如自动播放/键盘、音色、活动声部数。`voice_active` 包括释放尾音，`voice_held` 是仍按住的音符，两者含义不同。`selected_timbre` 是手动选择，显示当前发声音色还需考虑事件/声部音色。
6. 若用户要波形，当前 `envelope_level` 是包络最大值，不是 PCM 波形；可从音源输出采样有效脉冲与样本建立有界降采样/FIFO接口，禁止为了屏幕读取而阻塞音频帧渲染。若要播放进度，ROM pc 不是直接的拍数/曲长，需要明确进度定义。
7. 状态尽量在显示帧边界更新，避免半屏状态不一致；像素流水线增加延迟时同步延迟 DE/HS/VS。任何显示回压不允许传播到音符握手或 DAC 输出。
8. 原 `keyboard_top` 接入独立显示模块，更新原 GPRJ/CST/SDC；关闭再重开 IDE 加载文件列表。按改动范围做显示 TB、CDC 检查及音频/键盘/播放器必要回归，记录新增时钟、资源预算、接口和未验证项。

后续实施首阶段推荐以“正确点亮并显示基本状态”为完成条件。先完成800×480 UI可复用渲染/状态接口的方案与仿真，再依据明确手册接入像素时序，40P FPC约束采用用户确认的示例CST。未确认的时序/电气不猜；本窗口仅交接，不实现这些模块。有充分资料后，新窗口可在用户授权范围内继续。

## 7. 工具、仿真与现场容易踩的坑

```powershell
# 以下只运行纯 HDL / 离线数据工具；从 E:\gowin\fpga-instrument 执行。
D:\py\python.exe scripts/run_sim.py --test tb_score_player --out-dir reports/display/2026-10-22/score
D:\py\python.exe scripts/run_sim.py --test tb_score_audio --vendor --out-dir reports/display/2026-10-22/audio
D:\py\python.exe scripts/run_sim.py --test tb_keyboard_top --vendor --out-dir reports/display/2026-10-22/keyboard
D:\py\python.exe sim/test_compile_score.py
```

这些命令是新窗口可按变更范围选用的示例，本次交接没有运行。重复验证使用新子目录，不覆盖已有成功/失败日志；Windows 下 Icarus 输出路径用 ASCII，避免 CSV 路径乱码。

- Python：`D:\py\python.exe`；Icarus：`tools\mingw64\bin`。仿真入口自动从同一 GPRJ 取 HDL 文件。
- 官方 PLL 模型：`C:\Gowin\Gowin_V1.9.12.04_x64\IDE\simlib\gw5a\prim_sim.v`；脚本对现有指定顶层 TB 自动加入。新增需要 PLL 的 TB 时检查脚本是否识别，不能用假的锁定模型替代实现结论。
- 使用 `-g2012 -grelative-include`，源码按 `config/*.svh` 相对引用，不额外加配置搜索目录掩盖路径错误。Gowin 搜索目录应为 `src` 和 `src/config`。
- **交接开始时已有未提交文件**：`impl/keyboard_adsr_process_config.json`。只读 JSON 对比发现其 `IncludePath` 从入库的 `['src','src/config']` 回退到 `['E:/gowin/fpga-instrument/config']`，另有换行差异。这是此前反复出现的旧 IDE 保存现象；此次文档任务保留它，不纳入文档提交。新窗口应重新读取对比，避免覆盖后来新增的用户设置。
- 曾发生旧编辑页把 `score_player.sv` 保存回 Git 中旧版，导致缺失已删除的 `demo_score.svh`；EX3937 也曾因 IDE 缓存旧 HDL 列表漏掉 `timbre_control`。先关闭旧编辑页/重开原工程，不复制模块或恢复第二套旧头文件绕过。
- 文件编码 UTF-8，仓库保留原有 LF/CRLF；尽量局部编辑。已有 EDA 产物不入提交，证据报告按版本保存。
- Git 如遇 TLS 中断，之前直连 `git -c http.proxy= -c http.sslBackend=openssl -c http.version=HTTP/1.1 ...` 可成功；也曾使用本机代理 `http://127.0.0.1:7897`。临时 `-c` 参数即可，不关证书验证、不全局修改网络配置；推送后核对远端 `refs/heads/main`。

## 8. 另一路讨论：超声波音量控制

用户已明确希望距离控制音量，但目前只有独立发射/接收金属圆柱裸探头，各两根脚，没有驱动/接收电路，型号与频率未提供。此前建议完整测距模块以简化接入，但**用户未确认购买或已有 US-100/HC-SR04 模块**。

当前没有超声波 RTL、硬件连线或运行时音量控制接口。不要把裸接收探头当数字 ECHO，也不要把本次 RGB 屏工作自动扩展成超声波实现。后续若显示距离/音量，先将字段标为尚未接入，不展示虚假的实测值。

## 9. 新窗口完成一项更新时的交付

说明具体修改、屏幕型号与资料依据、实际使用的引脚/时钟/电压、接口与仿真结果、现存风险及待用户实板确认事项；中文提交；需同步GitHub时按另行明确的分支安排执行并核对远端，不为推送自动合入新功能。对用户给出可以自行重新编译和测量的明确步骤，助手继续遵守不运行综合/P&R/烧录的分工。
