xixi-2380/fpga-instrument/docs/matrix_keypad.md

# 4x4 矩阵键盘：用户接线与后续接口

用户已连接键盘，后续演奏控制由本矩阵键盘替代板载用户按键；板载复位用途保留。

## 固定接线

| 顺序 | 列线：左到右 | J23 针号 | 行线：上到下 | J23 针号 |
|---|---|---:|---|---:|
| 0 | W25 | 32 | W26 | 31 |
| 1 | M24 | 30 | L22 | 29 |
| 2 | Y25 | 28 | Y26 | 27 |
| 3 | AA24 | 26 | AA25 | 25 |

row/col 的数组位序按用户的键盘位置定义，不由排线物理顺序或印刷字符反推。
key_col[0..3] 依次为 W25/M24/Y25/AA24；key_row[0..3] 依次为 W26/L22/Y26/AA25。
按键位图使用 bit(row*4+col)，左上为 0，右下为 15。各键对应音高将在 Note On/Off 阶段集中定义。

## 核验与保留连接

官方全引脚 CST Header 段可交叉核对八个球位，均注明 BANK_VCCIO=3.3。实际板级电压未测。
八个键盘球位互不重复，且与 DAC 引脚及 U22/V19/W20/U26 四个音频观测输出无重叠。
音频测量点仍为 U22/BCK、V19/WS、W20/DIN、U26/PA_EN。
D2 已实现本接线的扫描和 ADSR，源码工程 keyboard_adsr.gprj；原 D1 仍为连续正弦版本。当前用法见 docs/bringup_keyboard.md。

## 后续扫描约定

计划逐列低有效扫描；未选列使用高阻，行输入上拉，采样前经过同步器并等待列切换稳定。
扫描节拍使用现有主时钟的时钟使能，不用组合逻辑产生内部时钟。整张 16 位状态需完成消抖并原子提交给音符事件逻辑。
当前扫描/同步/消抖已完成，原键控文件改为key_note_events输出带身份的握手事件；voice_allocator在独立音源内完成四声部分配。

用户已确认没有每键独立二极管。D2 已实现逐列低/高阻扫描、行上拉、消抖及矩形歧义释放；不宣称任意多键无冲突。
当前维护16位稳定键状态，但音源最多4个声部；第五音按分配策略替换，16键状态不等于16声部。四声部也不改变无二极管矩阵的物理冲突限制。

## 实际状态

用户已反馈 D1“正常发声”，记录为用户听音报告；尚无下载校验日志、频率/电压数值、左右隔离或 30 分钟稳定性记录。
烧录继续由用户操作，助手只负责文件修改及离线验证。
本次检查：八球位官方映射存在、3.3V 文档依据、唯一性、与音频球位无冲突，均通过；未修改 RTL，未运行新的音频仿真或生成新下载文件。
机器可读接线表见 docs/hardware/matrix_keypad_mapping.json。

2026-10-14：用户澄清 W26 是最上方横行，W25 是最左侧竖列，以上表格已修正；同组其余线保留此前顺序。原编译产物未重建，需用户按当前源码重新编译。

四声部验收优先使用同一行或同一列四键；可识别五键组合及替换说明见bringup_keyboard.md末段。输入适配器与音源继续分离，换键盘只替换扫描/事件来源，不把物理键位表放入声部分配器。
