xixi-2380/fpga-instrument/reports/input_separation/sim/D2_samples.csv

frame | keys | key | envelope | ghost | sample
0 | 0 | 0 | 0 | 0 | 0
1 | 0 | 0 | 0 | 0 | 0
2 | 0 | 0 | 0 | 0 | 0
3 | 0 | 0 | 0 | 0 | 0
4 | 0 | 0 | 0 | 0 | 0
5 | 0 | 0 | 0 | 0 | 0
6 | 0 | 0 | 0 | 0 | 0
7 | 0 | 0 | 0 | 0 | 0
8 | 0 | 0 | 0 | 0 | 0
9 | 0 | 0 | 0 | 0 | 0
10 | 0 | 0 | 0 | 0 | 0
11 | 0 | 0 | 0 | 0 | 0
12 | 0 | 0 | 0 | 0 | 0
13 | 0 | 0 | 0 | 0 | 0
14 | 0 | 0 | 0 | 0 | 0
15 | 0 | 0 | 0 | 0 | 0
16 | 0 | 0 | 0 | 0 | 0
17 | 0 | 0 | 0 | 0 | 0
18 | 0 | 0 | 0 | 0 | 0
19 | 0 | 0 | 0 | 0 | 0
20 | 1 | 0 | 0 | 0 | 0
21 | 1 | 0 | 0 | 0 | 0
22 | 1 | 0 | 8192 | 0 | 0
23 | 1 | 0 | 16384 | 0 | 87
24 | 1 | 0 | 24576 | 0 | 181
25 | 1 | 0 | 32768 | 0 | 280
26 | 1 | 0 | 40960 | 0 | 386
27 | 1 | 0 | 49152 | 0 | 497
28 | 1 | 0 | 57344 | 0 | 612
29 | 1 | 0 | 65536 | 0 | 733
30 | 1 | 0 | 61440 | 0 | 857
31 | 1 | 0 | 57344 | 0 | 821
32 | 1 | 0 | 53248 | 0 | 782
33 | 1 | 0 | 49152 | 0 | 739
34 | 1 | 0 | 45056 | 0 | 694
35 | 1 | 0 | 40960 | 0 | 646
36 | 1 | 0 | 36864 | 0 | 596
37 | 1 | 0 | 32768 | 0 | 543
38 | 1 | 0 | 32768 | 0 | 488
39 | 1 | 0 | 32768 | 0 | 493
40 | 1 | 0 | 32768 | 0 | 497
41 | 1 | 0 | 32768 | 0 | 501
42 | 1 | 0 | 32768 | 0 | 504
43 | 1 | 0 | 32768 | 0 | 507
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
