xixi-2380/fpga-instrument/reports/file_score/2026-10-19/rtl/D2_samples.csv

frame | keys | last_key | envelope_max | ghost | voice_held | sample
1 | 0 | 0 | 0 | 0 | 0 | 0
2 | 0 | 0 | 0 | 0 | 0 | 0
3 | 0 | 0 | 0 | 0 | 0 | 0
4 | 0 | 0 | 0 | 0 | 0 | 0
5 | 0 | 0 | 0 | 0 | 0 | 0
6 | 0 | 0 | 0 | 0 | 0 | 0
7 | 0 | 0 | 0 | 0 | 0 | 0
8 | 0 | 0 | 0 | 0 | 0 | 0
9 | 0 | 0 | 0 | 0 | 0 | 0
10 | 0 | 0 | 0 | 0 | 0 | 0
11 | 0 | 0 | 0 | 0 | 0 | 0
12 | 0 | 0 | 0 | 0 | 0 | 0
13 | 0 | 0 | 0 | 0 | 0 | 0
14 | 0 | 0 | 0 | 0 | 0 | 0
15 | 0 | 0 | 0 | 0 | 0 | 0
16 | 0 | 0 | 0 | 0 | 0 | 0
17 | 0 | 0 | 0 | 0 | 0 | 0
18 | 0 | 0 | 0 | 0 | 0 | 0
19 | 0 | 0 | 0 | 0 | 0 | 0
20 | 0 | 0 | 0 | 0 | 0 | 0
21 | 1 | 0 | 0 | 0 | 1 | 0
22 | 1 | 0 | 0 | 0 | 1 | 0
23 | 1 | 0 | 8192 | 0 | 1 | 0
24 | 1 | 0 | 16384 | 0 | 1 | 4
25 | 1 | 0 | 24576 | 0 | 1 | 17
26 | 1 | 0 | 32768 | 0 | 1 | 38
27 | 1 | 0 | 40960 | 0 | 1 | 69
28 | 1 | 0 | 49152 | 0 | 1 | 108
29 | 1 | 0 | 57344 | 0 | 1 | 155
30 | 1 | 0 | 65536 | 0 | 1 | 212
31 | 1 | 0 | 61440 | 0 | 1 | 276
32 | 1 | 0 | 57344 | 0 | 1 | 289
33 | 1 | 0 | 53248 | 0 | 1 | 300
34 | 1 | 0 | 49152 | 0 | 1 | 305
35 | 1 | 0 | 45056 | 0 | 1 | 305
36 | 1 | 0 | 40960 | 0 | 1 | 302
37 | 1 | 0 | 36864 | 0 | 1 | 294
38 | 1 | 0 | 32768 | 0 | 1 | 282
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
