xixi-2380/fpga-instrument/assets/themes/egg_cutout.png

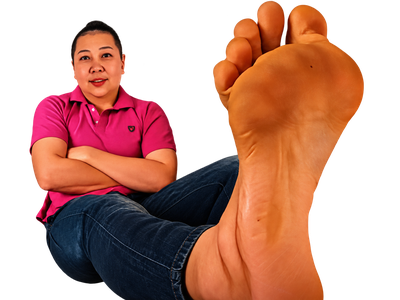
assets/themes/egg_cutout.png
