xixi-2380/fpga-instrument/reports/audio_analysis/2026-10-26/analysis_5.png

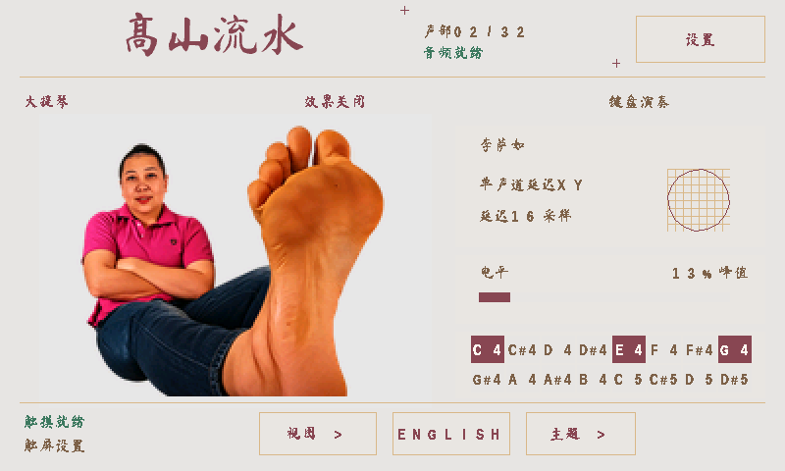
reports/audio_analysis/2026-10-26/analysis_5.png
