xixi-2380/fpga-instrument/reports/bilingual_ui/2026-10-25/ui_bilingual_settings.png

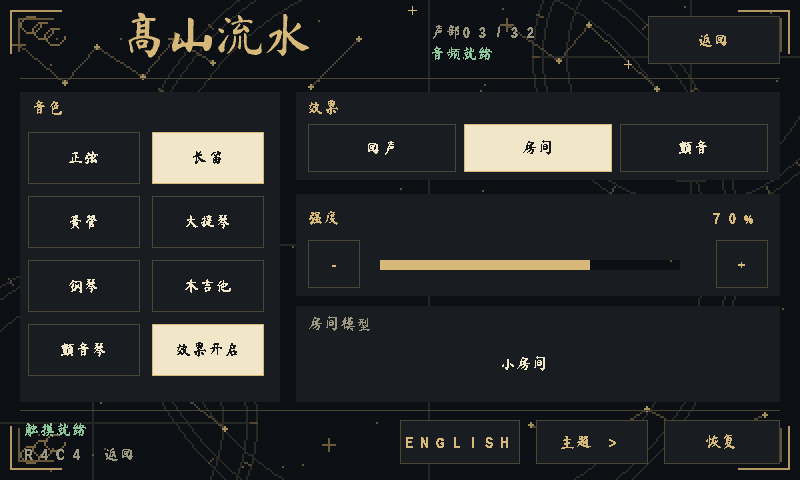
reports/bilingual_ui/2026-10-25/ui_bilingual_settings.png
