xixi-2380/fpga-instrument/reports/british_ui/2026-10-23/ui_0.png

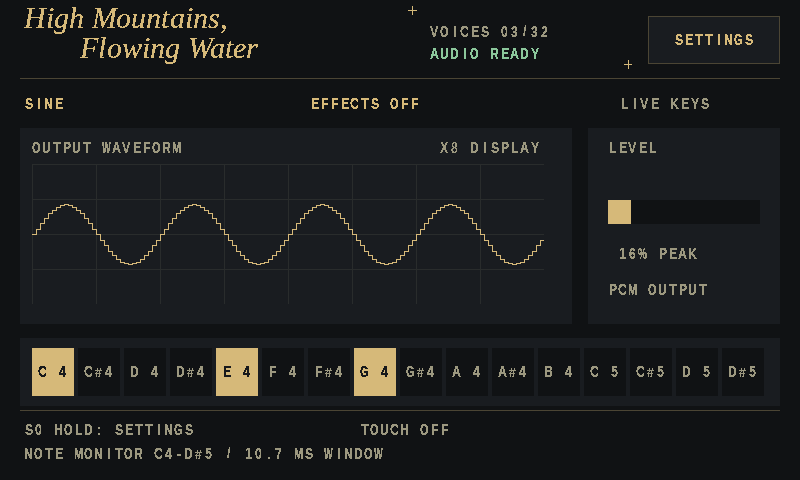
reports/british_ui/2026-10-23/ui_0.png
