xixi-2380/fpga-instrument/reports/hardware/photos/dock_back.jpg

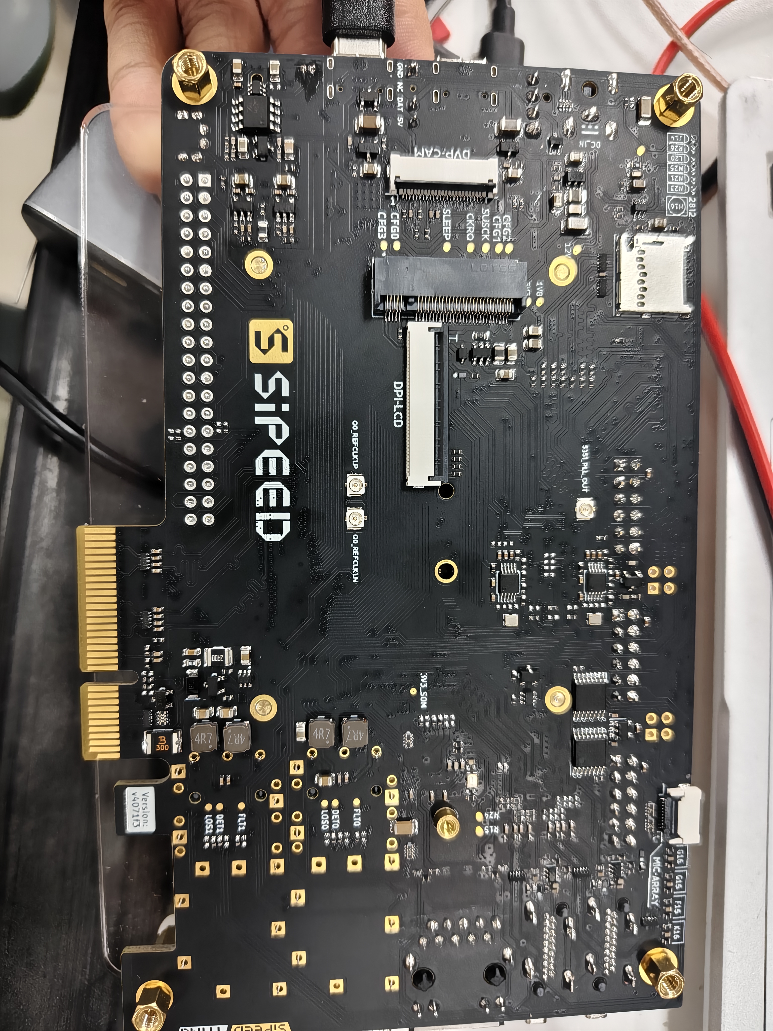
reports/hardware/photos/dock_back.jpg
