xixi-2380/fpga-instrument/reports/hardware/photos/matrix_keypad_user.png

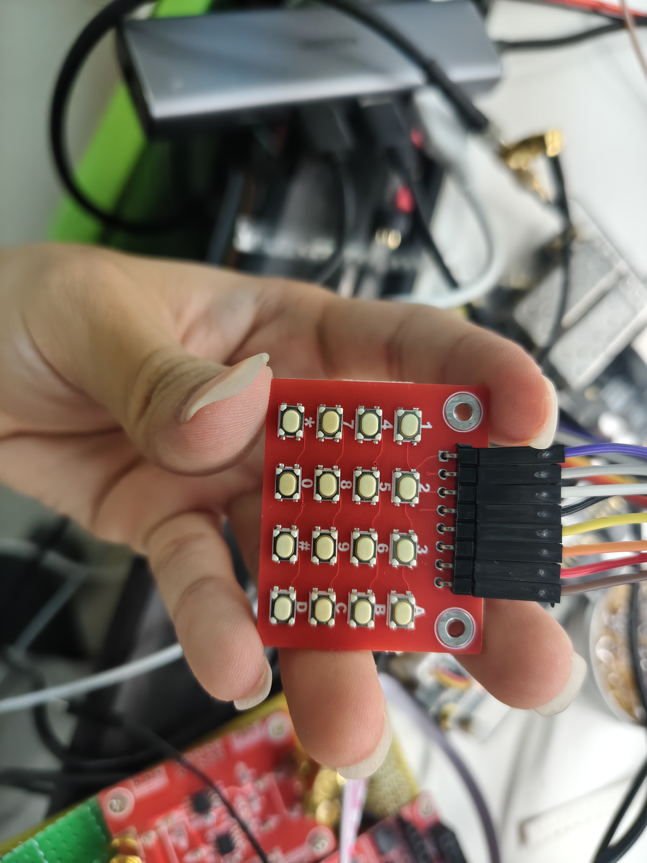
reports/hardware/photos/matrix_keypad_user.png
