xixi-2380/fpga-instrument/reports/instrument_ui/2026-10-23/ui_0.png

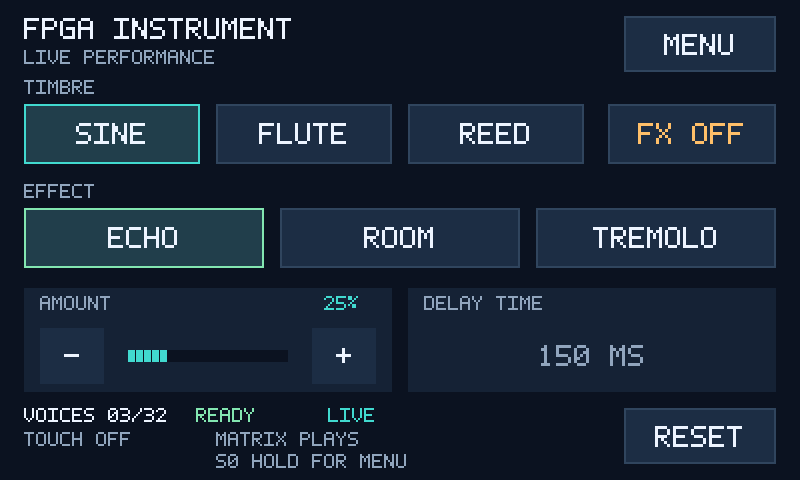
reports/instrument_ui/2026-10-23/ui_0.png
