xixi-2380/fpga-instrument/reports/release_egg/2026-10-25/final/egg_settings.png

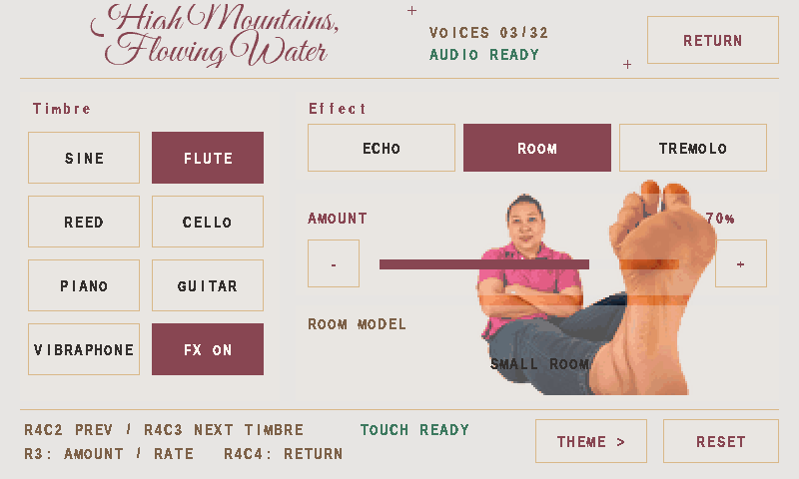
reports/release_egg/2026-10-25/final/egg_settings.png
