xixi-2380/fpga-instrument/reports/themes/2026-10-23/theme_2.png

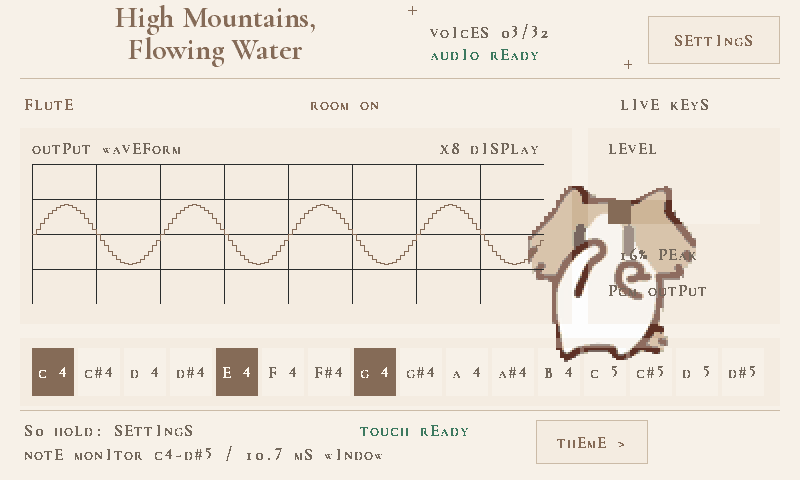
reports/themes/2026-10-23/theme_2.png
