xixi-2380/fpga-instrument/reports/themes/2026-10-23/themes_preview.png

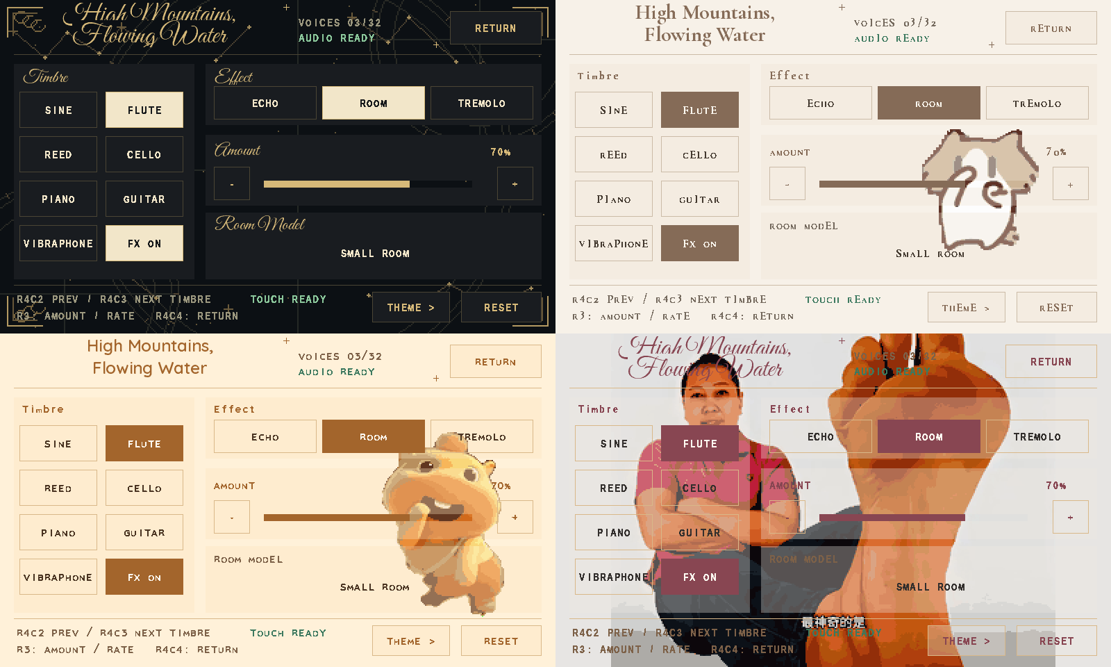
reports/themes/2026-10-23/themes_preview.png
