xixi-2380/fpga-instrument/reports/hardware/photos/assembled_front.jpg

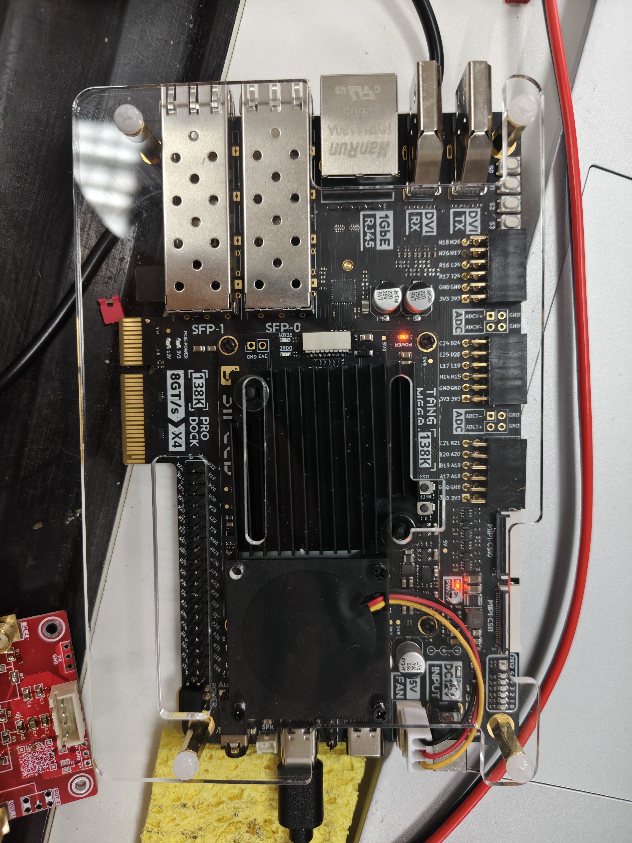
reports/hardware/photos/assembled_front.jpg
