xixi-2380/fpga-instrument/docs/bringup_run_leds.md

# D2 运行流水灯：用户自行编译及烧录

## 工程与新输出

关闭并重新打开 `E:\gowin\fpga-instrument\keyboard_adsr.gprj`，顶层仍是 keyboard_top。
项目已经加入 src/run_leds.sv、六个 LED 端口及 CST/SDC。配置中输出基名已改为 D2_keyboard_leds。
由用户自行综合、布局布线并检查报告，确认生成新文件 `E:\gowin\fpga-instrument\impl\pnr\D2_keyboard_leds.fs` 后再烧录。
本次助手没有运行 Gowin 编译或下载器，没有生成新的 .fs。旧 D2_keyboard_adsr.fs 不含流水灯，请勿把旧文件误认作新版本。
如果 IDE 已打开旧工程，必须重新载入新增源文件及配置；检查 File List 有 run_leds.sv、顶层 LED 端口 led_n[5:0]、输出名为 D2_keyboard_leds。

## 六颗橙色用户灯的含义

| 逻辑灯号 | 球位 | 4071f3图纸灯号 | 正常就绪时 | 持续未就绪约1秒后的诊断模式 |
|---|---|---|---|---|
| LED0 | R26 | LED1 | 四灯流水第1颗 | 参考时钟心跳，约250ms亮/250ms灭 |
| LED1 | J14 | LED0 | 四灯流水第2颗 | PLL1原始锁定指示经同步后为高时亮 |
| LED2 | L20 | LED2 | 四灯流水第3颗 | PLL2原始锁定指示经同步后为高时亮 |
| LED3 | M25 | LED3 | 四灯流水第4颗 | U4复位输入为高时亮 |
| LED4 | N21 | LED4 | 音频域复位解除后亮 | 保持原含义，未解除复位时灭 |
| LED5 | N23 | LED5 | 音符门控有效时亮 | 保持原含义，未就绪时通常灭 |

按逻辑灯号 LED0→LED1→LED2→LED3→LED0，即球位 R26→J14→L20→M25→R26，每颗停留 250 ms，一圈约 1 秒。
若按 4071f3 原理图灯号观察，顺序为 LED1→LED0→LED2→LED3；重新配置从 R26 对应的灯开始。
运行灯和诊断显示均直接使用板载50MHz参考时钟。上电先流水；持续未就绪达到4个250ms步进后转为诊断显示，不再要求四灯轮流亮。再次失去就绪时约0.75～1秒后也会切换；就绪恢复即自动恢复四灯流水。
短按USR仍有运行指示，长按超过约1秒后LED3应表示复位为高，LED0心跳继续。
PLL1/2 LOCK、U4复位、音频就绪和门控各经两级同步，只观察、不反馈控制，不改变PLL频率、锁定资格判断、复位、扫描或功放启动。
LED5 表示 Note 门控而非波形幅度：松开后它可以立即灭，而 200 ms Release 尾音仍继续。
这里指六颗普通用户灯，不是 POWER/DONE/READY 灯或 WS2812 彩灯。

## 依据和约束

Dock 版本依据用户照片 v4071f3。官方该版本原理图第 15 页：LED0→J14、LED1→R26、LED2→L20、LED3→M25、LED4→N21、LED5→N23；各 LED 经限流电阻接 +3V3，FPGA 低电平点亮。
本次按用户指定的 tang_mega_138k-pro_pins.cst 统一逻辑灯号：led_n[0]=R26、led_n[1]=J14，其他四灯不变。它与 4071f3 原理图 LED0/1 的命名相反；这是逻辑位序与图纸编号的差异，不改变低电平点亮的电气连接。历史报告仍记录旧位序，不覆盖。
用户 CST 与 references/tang_mega_138k-pro_pins.cst 的 SHA-256 完全一致，为 f647104f7b74800890d0283a438b226301bff3a3429a04ec0f6df63c9026e8ba。时钟 P16 按该文件启用上拉；行输入上拉、列低/高阻扫描继续保留。该 CST 未列出 PA_EN，依据 4071f3 原理图第 18 页保留 H17。
六路 LED 引脚设为 LVCMOS33、无上拉、DRIVE=8，未占用键盘及音频测量球位。24 个板级端口球位唯一性检查通过。
SDC 新增参考时钟到 LED 输出 0..100 ns 的可视输出实现预算；音频约束不变，没有新增音频 false-path。

## 如何判断

- 上电约1秒后LED4仍灭，应读取诊断模式；LED0心跳表示参考时钟域仍在运行。
- LED3亮：优先检查U4复位输入是否一直为高；USR是核心板上、散热片右侧靠上的按钮，下方RECFG是重新配置。
- LED3灭、LED1灭：优先查PLL1与50MHz参考路径。
- LED3灭、LED1亮、LED2灭：优先查PLL2或PLL1未能连续稳定锁定。
- LED1/2均亮但LED4灭：不能仅凭肉眼判断LOCK已连续稳定2ms，需考虑短暂失锁、资格判断或音频时钟未运行。
- LED4亮后自动恢复四灯流水；此时LED1/2/3又是流水灯，不再表示上述诊断状态。
- LED4亮但按单键LED5不亮，继续查键盘扫描；用户当前已反馈温机后可识别并发声。
- 恢复后松键LED5灭但仍有持续底噪：数字空闲零码已有仿真检查，实板DIN未知，仍需区分数字接口与DAC/功放/供电噪声。

灯光只帮助定位，不能证明音频时序或电气验收。最新用户反馈为“冷启动数分钟后能发声，持续空闲低频嘶声”，短按USR无效；这两项原因仍未确定。

## 仿真和参数

src/config/run_leds_config.svh 定义运行灯周期，默认 REF_HZ/4=12500000 个参考周期。
run_leds 用配置初始化的计数器循环，不用用户复位或 PLL 作时钟。
独立 tb_run_leds 检查上电状态、完整循环、精确间隔、STEP_CYCLES=1 边界、状态同步与 PLL 就绪撤销。
板级 tb_keyboard_top 检查音频和键盘保持正常、音频/按键状态灯点亮及用户复位期间流水继续。
物理键盘映射测试仍通过当前行 W26/L22/Y26/AA25、列 W25/M24/Y25/AA24 的 16 个位置。

```powershell
python scripts/run_sim.py --test tb_run_leds
python scripts/run_sim.py --test tb_keyboard_top --vendor
python scripts/run_keyboard_pinmap.py
```

原流水灯版历史结果：tb_run_leds PASS（111次）；tb_keyboard_top PASS（329180次）；当前/旧行列方向各34项映射检查通过。
当前流水灯版没有新的综合资源/时序或硬件结果；需要用户自行编译并记录。

当前工作目录清理后仅保留 keyboard_adsr.gprj；重复的 bringup/README_manual.md、旧工程入口和旧 .fs 已移除。历史说明位于 docs/archive，必要下载状态位于 reports/bringup/delivery_records。助手未重新实现，仍由用户生成 D2_keyboard_leds.fs。

## 本次启动与底噪排查版本

输出名仍为D2_keyboard_leds，须用户重新编译；现有20:20生成的文件属于本次诊断改动之前的版本。没有另建顶层或工程。

原实现报告setup/hold违例为0，但存在PR1014（clk_d参考路径使用通用布线）警告；不能据此断言是启动故障根因。报告快照与旧.fs哈希保存在reports/startup_noise，不覆盖用户原报告。

源码中的原POR约0.64μs，两级各2ms锁定资格、10ms零码和5ms淡入不是数分钟延迟。官方UG306要求输入时钟不稳定时在稳定后复位；用户已测试短按USR无改善，因此本轮先显示实际状态，不盲改PLL参数或加入复位重试。

原功放策略仍为启动后持续开启，松键不关闭PA_EN。新增板级测试会确认Release后两个声道连续20帧零码及失锁后安全静音；它不能证明实板DIN或模拟噪声。用户无示波器条件，先反馈诊断灯即可。

当前启动诊断版结果：tb_run_leds=183、tb_keyboard_top=593419、tb_clock_reset=6、两种引脚映射各34项，全部PASS，共593676项检查。实板冷启动、LOCK行为与底噪仍待观察。

## 用户确认复位诊断灯持续亮后的最小验证

用户确认：按上一条说明的原理图灯号，LED1闪烁、LED3常亮，且没有按住USR。对应当前程序的参考心跳和U4高电平复位指示；仅记录这两颗灯，未擅自填入其余灯状态或实测电压。按诊断逻辑推断外部复位持续有效，会让PLL和音频保持复位，物理成因尚不明确。

重新视觉核对核心板4071与4072原理图第7页：SW5经R35=1k接1.5V，U4_USR_KEY由R37=4.7k下拉、C167=100nF接地。松开低、按下高，不能反转RTL复位极性。安装版UG304-1.3.8E第3.3.1、3.5.4节确认Arora V的LVCMOS输入支持弱下拉及PULL_MODE=DOWN。

本次仅将原src/keyboard.cst中rst的PULL_MODE由NONE改为DOWN，球位U4、LVCMOS15、DRIVE=OFF、1.5V及现有高有效复位逻辑均不变。它偏离通用参考CST的NONE，是与原理图松键低电平一致的输入偏置验证；原理图已有外部4.7k下拉，故不能断言缺少内部下拉就是根因，也不能保证这次修改能克服实际的持续高电平来源。没有屏蔽复位、增加超时强制启动或改PLL参数。

请用户重新综合、布局布线、烧录当前主工程，检查新实现报告rst一行的Pull Mode为DOWN。上电不按USR：若正常就绪，LED4应亮，前四灯恢复流水，LED3不再持续亮；短按USR仍应静音并在释放后恢复。若仍停在LED1心跳、LED3常亮，则本次下拉验证未解除复位，下一步检查实际U4/USR电路、装配或编号对应；不把该现象归为PLL锁定慢。空闲低频底噪仍单独待查。

扩充原tb_keyboard_top重现持续高复位：诊断显示复位亮、两个锁定灯灭、状态灯灭、心跳继续；确认PLL/音频未绕过复位、矩阵高阻和输出静音，释放后再按A4可恢复串行音频。数字TB不能模拟内部弱下拉的模拟电气效果。已有22:23用户实现报告与.fs哈希保存到reports/reset_input；它们属于本次约束修改之前，不能当作新约束已实现的证明。结果见reports/reset_input/validation.json。

用户后续确认：U4内部下拉版本“现在正常了”，启动恢复得到定性实板反馈；没有新增电压或时间测量，物理异常原因未证实。此前“尚待用户验证”属于修改时的记录。空闲底噪仍待处理。

2026-10-15用户更正：已确认底噪为耳机阻抗过低，取消软件处理；此前待查底噪记录保留为历史，不再据此改PA_EN策略。输入/音源接口分离不改变六灯、USR、PLL或功放含义。

2026-10-15四声部版：LED5表示至少一个已分配声部仍被按住；全部松开即灭，四个独立Release尾音仍可继续。若旧键被替换且未重按，它不占声部；LED5不表示全部物理键状态。其余灯、启动诊断及U4下拉不变。
