xixi-2380/fpga-instrument/reports/keyboard/validation.md

# D2 矩阵键盘及单声部 ADSR 验证

七个新增独立 TB 全部通过；正常扫描、无二极管鬼键网络、音符优先级、ADSR、串行音频与板级 PLL 分别检查。

| 测试 | 检查数 |
|---|---:|
| tb_matrix_keypad | 7183 |
| tb_mono_note_control | 163 |
| tb_adsr_envelope | 59 |
| tb_adsr_production | 14881 |
| tb_keyboard_core | 2342532 |
| tb_keyboard_top | 266868 |
| tb_keyboard_latency | 5 |

总计 2631691 次检查。
生产 ADSR 的 480/4800/9600 样本时长精确检查，零时长、Sustain 0/1、Release 中重触发及 Off 优先边界通过。
完整音频 TB 逐码比较独立 DDS/定点/串行参考，并检查 1280 周期帧和欠载；板级 TB 用厂商 PLL 模型检查引脚及复位。

生产扫描/消抖参数下的一次刺激：Note On 3083.548 us，首个非零串行码 3135.306 us，Note Off 2948.164 us。
以上为仿真数据，不是硬件输入到模拟输出测量，不声称已验收实板 <5 ms。

## 历史离线实现记录

本次已发生的离线综合及 P&R：18 个端口位置匹配，setup=0、hold=0。
资源：Logic 916, Register 384, BSRAM 4, DSP 2, PLL 2
用户已明确后续综合编译、布局布线、烧录均自行完成；助手此后只改源码/约束/脚本/文档和运行 HDL 仿真，不再启动 EDA 编译或下载器。

## 范围和已知问题

- 单声部，16 键覆盖 MIDI 60..75，不宣称已实现复音或 32 个声部。
- 键盘无每键二极管。任何两个列共享至少两个按下行时视为歧义，清除接受状态、释放当前音符并抑制新增音符；真实四角和三角鬼键不能区分。
- 解除歧义并完成 3 ms 消抖后恢复识别；Release 尾音按 200 ms 淡出，并非鬼键一出现就截断 DAC。
- 新按键优先；同拍多个新增键选最高键号；松开当前键后退回仍按住的最高键号。
- 行输入有两级同步，列输出只驱动低或高阻。扫描与音频同属 61.44 MHz 域，控制原子采样于 frame_ce。
- 保留 PR1014 原 P16 时钟路由和 CK3000 综合时钟关系警告。P&R 显式 50/32/61.44 MHz 时钟表正确。
- 音频及列输出路径约束 0..30 ns；异步行输入不伪造同步输入到达时间。未独立导出全设计未约束路径统计，full_sta_signed=false。
- GPIO 镜像不代替 DAC 焊脚电气测量；实际矩阵线序/行上拉/接触抖动、模拟输出、硬件延时和长稳均待用户验证。
- 未由助手烧录。已有 D2 .fs 只是历史生成产物，后续请用户以源码工程自行编译。

关键证据：reports/sim/D2_samples.csv、各 TB 日志、D2.tr、D2.rpt.txt、build.log。

## 2026-10-14：修正物理行列定义

用户澄清：W26 控制最上方横行，W25 控制最左侧竖列。当前 key_row[0..3] 为 W26/L22/Y26/AA25（同步上拉输入），key_col[0..3] 为 W25/M24/Y25/AA24（选中低、其余高阻输出）。修正 keyboard.cst、编译脚本的位置核查表、机器可读映射及操作说明；音频 GPIO 不变，内部扫描/ADSR 逻辑不变。
新增基于实际 CST 的物理开关网络 TB：修正版 16 位置按下/松开、音频和鬼键共 34 项通过；旧版对照也通过 34 项，显示只转置键位。因此完全无声尚不能归因于此次行列解释，故障未标为修复。
没有运行 Gowin 综合/布局布线或烧录；现有旧 .fs 与旧 P&R 仅作历史记录，当前源码需用户重新编译。
