xixi-2380/fpga-instrument/reports/tone_play/validation.md

# D1 离线交付验证

新增板级独立仿真 PASS：375334 次检查。
双声道采用生产 480/240 帧策略，首次启动和播放中复位后各解码 850 帧；左/右入口分别以加速启动完成隔离检查。
独立模型按 BCK 上升沿接收码字，与数学 DDS 和定点淡入参考逐样本比较；检查镜像、边沿、幅度、零码及欠载。
既有 tone_core 仿真另已通过 48000 连续帧及两个复位/模式场景；本次未重复运行未改变的核心。

| 文件 | Logic | Register | BSRAM | DSP | PLL | setup/hold 违例 |
|---|---:|---:|---:|---:|---:|---|
| bringup\D1_stereo_440.fs | 212 | 141 | 4 | 1 | 2 | 0 / 0 |
| bringup\D1_left_440.fs | 213 | 141 | 4 | 1 | 2 | 0 / 0 |
| bringup\D1_right_440.fs | 215 | 141 | 4 | 1 | 2 | 0 / 0 |

三个版本的 10 个实际引脚位置均匹配 CST；ROM 初始化在综合网表中非零，生成配置请求包含 BSRAM 初始化且 SecurityBit OFF。
时钟表分别为 50/32/61.44 MHz。GPIO：U22/BCK、V19/WS、W20/DIN、U26/PA_EN。

## 约束范围和已知问题

- 实现约束覆盖 8 个音频/镜像输出，最大 30 ns、最小 0 ns；没有音频 false-path 或多周期豁免。
- ref_clk、两个 PLL 生成时钟显式定义。mid_clk 只作为第二级 PLL 输入，工具报告没有可用于计算 mid_clk Fmax 的寄存器路径，属于结构预期。
- 异步用户复位与 LOCK 经现有复位/锁定同步模块处理；不伪造同步输入到达时间。其模拟电气与异步恢复仍不记作完整板级 STA 签核。
- Gowin 当前 .tr 记录所分析端点及 setup/hold 结果，未另导出全设计未约束路径统计；不声称“全设计零未约束路径”。
- 原 P16 参考时钟仍有 PR1014 普通路由警告，CK3000 综合时钟关系警告保留；P&R 显式时钟表正确。
- 0..30 ns 仅为实现预算，GPIO 波形不能代替 DAC 焊脚的电气测量。
- 核心板具体 PCB 修订与芯片速度字仍不可读，采用官方文档 C1/I0；实际电平、音频输出、左右对应及长稳待用户验收。
- 本次新文件未由助手烧录，两个自动烧录入口保持停用。

## 文件哈希

- bringup\D1_stereo_440.fs：`e4066fb37bc02216a28d54860329be0d5d526213a20853b4d547c125263ffdb2`
- bringup\D1_left_440.fs：`6b0f593229b1f1c6eb556a52fac86bf42d809ba8d1351975b4ec99efc14398ba`
- bringup\D1_right_440.fs：`07eb1a6515c25bfc850a408275954365d58c978c169e5ea5bd39da51cba650a8`
