xixi-2380/fpga-instrument/reports/bringup/D0.pin.html

- Pin Messages
- Pin Details
  - Pinout by Port Name
  - All Package Pins

# Pin Messages

Report Title | Pin Report
Design File | E:\gowin\fpga-instrument-mega138k-pro\impl\gwsynthesis\bringup_D0_muted.vg
Physical Constraints File | E:\gowin\fpga-instrument-mega138k-pro\boards\mega138k_pro\bringup.cst
Timing Constraints File | E:\gowin\fpga-instrument-mega138k-pro\boards\mega138k_pro\bringup_digital.sdc
Tool Version | V1.9.12.04 (64-bit)
Part Number | GW5AST-LV138FPG676AC1/I0
Device | GW5AST-138
Device Version | C
Created Time | Tue Oct 13 17:32:36 2026
Legal Announcement | Copyright (C)2014-2026 Gowin Semiconductor Corporation. All rights reserved.

# Pin Details

## Pinout by Port Name:

Port Name | Diff Pair | Loc./Bank | Constraint | Dir. | Site | CFG | IO Type | Drive | Pull Mode | PCI Clamp | Hysteresis | Open Drain | Vref | Single Resistor | Diff Resistor | BankVccio | Pull Strength | Ctle
clk | - | P16/3 | Y | in | IOR103[B] | EMCCLK | LVCMOS33 | OFF | NONE | OFF | ON | OFF | OFF | OFF | OFF | 3.3 | MEDIUM | NONE
rst | - | U4/7 | Y | in | IOL1[A] | - | LVCMOS15 | OFF | NONE | OFF | ON | OFF | OFF | OFF | OFF | 1.5 | MEDIUM | NONE
HP_BCK | - | E22/5 | Y | out | IOB37[A] | - | LVCMOS33 | 8 | NONE | OFF | OFF | OFF | OFF | OFF | OFF | 3.3 | MEDIUM | NONE
HP_WS | - | F24/4 | Y | out | IOB140[B] | - | LVCMOS33 | 8 | NONE | OFF | OFF | OFF | OFF | OFF | OFF | 3.3 | MEDIUM | NONE
HP_DIN | - | G24/4 | Y | out | IOB140[A] | - | LVCMOS33 | 8 | NONE | OFF | OFF | OFF | OFF | OFF | OFF | 3.3 | MEDIUM | NONE
PA_EN | - | H17/5 | Y | out | IOB91[A] | - | LVCMOS33 | 8 | NONE | OFF | OFF | OFF | OFF | OFF | OFF | 3.3 | MEDIUM | NONE

## All Package Pins:

Loc./Bank | Signal | Dir. | Site | CFG | IO Type | Drive | Pull Mode | PCI Clamp | Hysteresis | Open Drain | Vref | Single Resistor | Diff Resistor | Bank Vccio | Pull Strength | Ctle
E22/5 | HP_BCK | out | IOB37[A] | - | LVCMOS33 | 8 | NONE | OFF | OFF | OFF | OFF | OFF | OFF | 3.3 | MEDIUM | NONE
D23/5 | - | in | IOB38[A] | - | LVCMOS33 | OFF | UP | OFF | ON | OFF | OFF | OFF | OFF | 3.3 | MEDIUM | NONE
D24/5 | - | in | IOB38[B] | - | LVCMOS33 | OFF | UP | OFF | ON | OFF | OFF | OFF | OFF | 3.3 | MEDIUM | NONE
C24/5 | - | in | IOB40[A] | - | LVCMOS33 | OFF | UP | OFF | ON | OFF | OFF | OFF | OFF | 3.3 | MEDIUM | NONE
B24/5 | - | in | IOB40[B] | - | LVCMOS33 | OFF | UP | OFF | ON | OFF | OFF | OFF | OFF | 3.3 | MEDIUM | NONE
A23/5 | - | in | IOB42[A] | - | LVCMOS33 | OFF | UP | OFF | ON | OFF | OFF | OFF | OFF | 3.3 | MEDIUM | NONE
A24/5 | - | in | IOB42[B] | - | LVCMOS33 | OFF | UP | OFF | ON | OFF | OFF | OFF | OFF | 3.3 | MEDIUM | NONE
B25/5 | - | in | IOB44[A] | - | LVCMOS33 | OFF | UP | OFF | ON | OFF | OFF | OFF | OFF | 3.3 | MEDIUM | NONE
A25/5 | - | in | IOB44[B] | - | LVCMOS33 | OFF | UP | OFF | ON | OFF | OFF | OFF | OFF | 3.3 | MEDIUM | NONE
C26/5 | - | in | IOB47[A] | - | LVCMOS33 | OFF | UP | OFF | ON | OFF | OFF | OFF | OFF | 3.3 | MEDIUM | NONE
B26/5 | - | in | IOB47[B] | - | LVCMOS33 | OFF | UP | OFF | ON | OFF | OFF | OFF | OFF | 3.3 | MEDIUM | NONE
C22/5 | - | in | IOB49[A] | - | LVCMOS33 | OFF | UP | OFF | ON | OFF | OFF | OFF | OFF | 3.3 | MEDIUM | NONE
C23/5 | - | in | IOB49[B] | VREF | LVCMOS33 | OFF | UP | OFF | ON | OFF | OFF | OFF | OFF | 3.3 | MEDIUM | NONE
C17/5 | - | in | IOB51[A] | - | LVCMOS33 | OFF | UP | OFF | ON | OFF | OFF | OFF | OFF | 3.3 | MEDIUM | NONE
B17/5 | - | in | IOB51[B] | - | LVCMOS33 | OFF | UP | OFF | ON | OFF | OFF | OFF | OFF | 3.3 | MEDIUM | NONE
E16/5 | - | in | IOB53[A] | - | LVCMOS33 | OFF | UP | OFF | ON | OFF | OFF | OFF | OFF | 3.3 | MEDIUM | NONE
D16/5 | - | in | IOB53[B] | - | LVCMOS33 | OFF | UP | OFF | ON | OFF | OFF | OFF | OFF | 3.3 | MEDIUM | NONE
A17/5 | - | in | IOB56[A] | - | LVCMOS33 | OFF | UP | OFF | ON | OFF | OFF | OFF | OFF | 3.3 | MEDIUM | NONE
A18/5 | - | in | IOB56[B] | - | LVCMOS33 | OFF | UP | OFF | ON | OFF | OFF | OFF | OFF | 3.3 | MEDIUM | NONE
B19/5 | - | in | IOB58[A] | - | LVCMOS33 | OFF | UP | OFF | ON | OFF | OFF | OFF | OFF | 3.3 | MEDIUM | NONE
A19/5 | - | in | IOB58[B] | - | LVCMOS33 | OFF | UP | OFF | ON | OFF | OFF | OFF | OFF | 3.3 | MEDIUM | NONE
E17/5 | - | in | IOB60[A] | SGCLKT_6/BPLL0_T_IN0/BPLL1_T_IN0 | LVCMOS33 | OFF | UP | OFF | ON | OFF | OFF | OFF | OFF | 3.3 | MEDIUM | NONE
E18/5 | - | in | IOB60[B] | SGCLKC_6/BPLL0_C_IN0/BPLL1_C_IN0 | LVCMOS33 | OFF | UP | OFF | ON | OFF | OFF | OFF | OFF | 3.3 | MEDIUM | NONE
D18/5 | - | in | IOB62[A] | MGCLKT_6/BPLL0_T_IN1/BPLL1_T_IN1 | LVCMOS33 | OFF | UP | OFF | ON | OFF | OFF | OFF | OFF | 3.3 | MEDIUM | NONE
C18/5 | - | in | IOB62[B] | MGCLKC_6/BPLL0_C_IN1/BPLL1_C_IN1 | LVCMOS33 | OFF | UP | OFF | ON | OFF | OFF | OFF | OFF | 3.3 | MEDIUM | NONE
D19/5 | - | in | IOB66[A] | MGCLKT_7/BPLL0_T_FB0/BPLL1_T_FB0 | LVCMOS33 | OFF | UP | OFF | ON | OFF | OFF | OFF | OFF | 3.3 | MEDIUM | NONE
C19/5 | - | in | IOB66[B] | MGCLKC_7/BPLL0_C_FB0/BPLL1_C_FB0 | LVCMOS33 | OFF | UP | OFF | ON | OFF | OFF | OFF | OFF | 3.3 | MEDIUM | NONE
E20/5 | - | in | IOB68[A] | SGCLKT_7/BPLL0_T_FB1/BPLL1_T_FB1 | LVCMOS33 | OFF | UP | OFF | ON | OFF | OFF | OFF | OFF | 3.3 | MEDIUM | NONE
D20/5 | - | in | IOB68[B] | SGCLKC_7/BPLL0_C_FB1/BPLL1_C_FB1 | LVCMOS33 | OFF | UP | OFF | ON | OFF | OFF | OFF | OFF | 3.3 | MEDIUM | NONE
B20/5 | - | in | IOB70[A] | - | LVCMOS33 | OFF | UP | OFF | ON | OFF | OFF | OFF | OFF | 3.3 | MEDIUM | NONE
A20/5 | - | in | IOB70[B] | - | LVCMOS33 | OFF | UP | OFF | ON | OFF | OFF | OFF | OFF | 3.3 | MEDIUM | NONE
C21/5 | - | in | IOB72[A] | - | LVCMOS33 | OFF | UP | OFF | ON | OFF | OFF | OFF | OFF | 3.3 | MEDIUM | NONE
B21/5 | - | in | IOB72[B] | - | LVCMOS33 | OFF | UP | OFF | ON | OFF | OFF | OFF | OFF | 3.3 | MEDIUM | NONE
B22/5 | - | in | IOB74[A] | - | LVCMOS33 | OFF | UP | OFF | ON | OFF | OFF | OFF | OFF | 3.3 | MEDIUM | NONE
A22/5 | - | in | IOB74[B] | - | LVCMOS33 | OFF | UP | OFF | ON | OFF | OFF | OFF | OFF | 3.3 | MEDIUM | NONE
E21/5 | - | in | IOB76[A] | - | LVCMOS33 | OFF | UP | OFF | ON | OFF | OFF | OFF | OFF | 3.3 | MEDIUM | NONE
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
F25/4 | - | in | IOB144[B] | - | LVCMOS33 | OFF | UP | OFF | ON | OFF | OFF | OFF | OFF | 3.3 | MEDIUM | NONE
K18/4 | - | in | IOB146[A] | - | LVCMOS33 | OFF | UP | OFF | ON | OFF | OFF | OFF | OFF | 3.3 | MEDIUM | NONE
J10/10 | - | out | IOB169[A] | TDO | LVCMOS33 | 8 | UP | OFF | OFF | OFF | OFF | OFF | OFF | 3.3 | MEDIUM | NONE
H11/10 | - | in | IOB169[B] | TMS | LVCMOS33 | OFF | UP | OFF | ON | OFF | OFF | OFF | OFF | 3.3 | MEDIUM | NONE
V11/10 | - | in | IOB171[A] | READY | LVCMOS33 | OFF | UP | OFF | ON | OFF | OFF | OFF | OFF | 3.3 | MEDIUM | NONE
W10/10 | - | in | IOB171[B] | DONE | LVCMOS33 | OFF | UP | OFF | ON | OFF | OFF | OFF | OFF | 3.3 | MEDIUM | NONE
H12/10 | - | in | IOB173[A] | TCK | LVCMOS33 | OFF | UP | OFF | ON | OFF | OFF | OFF | OFF | 3.3 | MEDIUM | NONE
H10/10 | - | in | IOB173[B] | TDI | LVCMOS33 | OFF | UP | OFF | ON | OFF | OFF | OFF | OFF | 3.3 | MEDIUM | NONE
AB7/10 | - | in | IOB175[A] | MODE0 | LVCMOS33 | OFF | UP | OFF | ON | OFF | OFF | OFF | OFF | 3.3 | MEDIUM | NONE
H13/10 | - | in | IOB175[B] | CCLK | LVCMOS33 | OFF | UP | OFF | ON | OFF | OFF | OFF | OFF | 3.3 | MEDIUM | NONE
Y9/10 | - | in | IOB177[A] | MODE1 | LVCMOS33 | OFF | UP | OFF | ON | OFF | OFF | OFF | OFF | 3.3 | MEDIUM | NONE
W9/10 | - | in | IOB177[B] | MODE2 | LVCMOS33 | OFF | UP | OFF | ON | OFF | OFF | OFF | OFF | 3.3 | MEDIUM | NONE
AB15/10 | - | in | IOB179[A] | CFGBVS | LVCMOS33 | OFF | UP | OFF | ON | OFF | OFF | OFF | OFF | 3.3 | MEDIUM | NONE
AE16/10 | - | in | IOB179[B] | RECONFIG_N | LVCMOS33 | OFF | UP | OFF | ON | OFF | OFF | OFF | OFF | 3.3 | MEDIUM | NONE
U4/7 | rst | in | IOL1[A] | - | LVCMOS15 | OFF | NONE | OFF | ON | OFF | OFF | OFF | OFF | 1.5 | MEDIUM | NONE
T8/7 | - | in | IOL2[A] | ADCINCK0 | LVCMOS15 | OFF | UP | OFF | ON | OFF | OFF | OFF | OFF | 1.5 | MEDIUM | NONE
T7/7 | - | in | IOL2[B] | - | LVCMOS15 | OFF | UP | OFF | ON | OFF | OFF | OFF | OFF | 1.5 | MEDIUM | NONE
U6/7 | - | in | IOL4[A] | - | LVCMOS15 | OFF | UP | OFF | ON | OFF | OFF | OFF | OFF | 1.5 | MEDIUM | NONE
U5/7 | - | in | IOL4[B] | - | LVCMOS15 | OFF | UP | OFF | ON | OFF | OFF | OFF | OFF | 1.5 | MEDIUM | NONE
T5/7 | - | in | IOL6[A] | - | LVCMOS15 | OFF | UP | OFF | ON | OFF | OFF | OFF | OFF | 1.5 | MEDIUM | NONE
R5/7 | - | in | IOL6[B] | - | LVCMOS15 | OFF | UP | OFF | ON | OFF | OFF | OFF | OFF | 1.5 | MEDIUM | NONE
R7/7 | - | in | IOL8[A] | - | LVCMOS15 | OFF | UP | OFF | ON | OFF | OFF | OFF | OFF | 1.5 | MEDIUM | NONE
R6/7 | - | in | IOL8[B] | - | LVCMOS15 | OFF | UP | OFF | ON | OFF | OFF | OFF | OFF | 1.5 | MEDIUM | NONE
P6/7 | - | in | IOL11[A] | - | LVCMOS15 | OFF | UP | OFF | ON | OFF | OFF | OFF | OFF | 1.5 | MEDIUM | NONE
P5/7 | - | in | IOL11[B] | VREF | LVCMOS15 | OFF | UP | OFF | ON | OFF | OFF | OFF | OFF | 1.5 | MEDIUM | NONE
R8/7 | - | in | IOL13[A] | - | LVCMOS15 | OFF | UP | OFF | ON | OFF | OFF | OFF | OFF | 1.5 | MEDIUM | NONE
P8/7 | - | in | IOL13[B] | - | LVCMOS15 | OFF | UP | OFF | ON | OFF | OFF | OFF | OFF | 1.5 | MEDIUM | NONE
U2/7 | - | in | IOL15[A] | - | LVCMOS15 | OFF | UP | OFF | ON | OFF | OFF | OFF | OFF | 1.5 | MEDIUM | NONE
U1/7 | - | in | IOL15[B] | - | LVCMOS15 | OFF | UP | OFF | ON | OFF | OFF | OFF | OFF | 1.5 | MEDIUM | NONE
T2/7 | - | in | IOL17[A] | - | LVCMOS15 | OFF | UP | OFF | ON | OFF | OFF | OFF | OFF | 1.5 | MEDIUM | NONE
R2/7 | - | in | IOL17[B] | - | LVCMOS15 | OFF | UP | OFF | ON | OFF | OFF | OFF | OFF | 1.5 | MEDIUM | NONE
T4/7 | - | in | IOL20[A] | - | LVCMOS15 | OFF | UP | OFF | ON | OFF | OFF | OFF | OFF | 1.5 | MEDIUM | NONE
T3/7 | - | in | IOL20[B] | - | LVCMOS15 | OFF | UP | OFF | ON | OFF | OFF | OFF | OFF | 1.5 | MEDIUM | NONE
R1/7 | - | in | IOL22[A] | - | LVCMOS15 | OFF | UP | OFF | ON | OFF | OFF | OFF | OFF | 1.5 | MEDIUM | NONE
P1/7 | - | in | IOL22[B] | - | LVCMOS15 | OFF | UP | OFF | ON | OFF | OFF | OFF | OFF | 1.5 | MEDIUM | NONE
R3/7 | - | in | IOL24[A] | MGCLKT_11/LPLL0_T_IN1/LPLL1_T_IN1 | LVCMOS15 | OFF | UP | OFF | ON | OFF | OFF | OFF | OFF | 1.5 | MEDIUM | NONE
P3/7 | - | in | IOL24[B] | MGCLKC_11/LPLL0_C_IN1/LPLL1_C_IN1 | LVCMOS15 | OFF | UP | OFF | ON | OFF | OFF | OFF | OFF | 1.5 | MEDIUM | NONE
P4/7 | - | in | IOL26[A] | SGCLKT_11/LPLL0_T_IN0/LPLL1_T_IN0 | LVCMOS15 | OFF | UP | OFF | ON | OFF | OFF | OFF | OFF | 1.5 | MEDIUM | NONE
N4/7 | - | in | IOL26[B] | SGCLKC_11/LPLL0_C_IN0/LPLL1_C_IN0 | LVCMOS15 | OFF | UP | OFF | ON | OFF | OFF | OFF | OFF | 1.5 | MEDIUM | NONE
N3/7 | - | in | IOL29[A] | MGCLKT_10/LPLL0_T_FB1/LPLL1_T_FB1 | LVCMOS15 | OFF | UP | OFF | ON | OFF | OFF | OFF | OFF | 1.5 | MEDIUM | NONE
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
Y20/2 | - | in | IOR17[B] | - | LVCMOS33 | OFF | UP | OFF | ON | OFF | OFF | OFF | OFF | 3.3 | MEDIUM | NONE
T20/2 | - | in | IOR20[A] | - | LVCMOS33 | OFF | UP | OFF | ON | OFF | OFF | OFF | OFF | 3.3 | MEDIUM | NONE
U20/2 | - | in | IOR20[B] | - | LVCMOS33 | OFF | UP | OFF | ON | OFF | OFF | OFF | OFF | 3.3 | MEDIUM | NONE
T19/2 | - | in | IOR22[A] | - | LVCMOS33 | OFF | UP | OFF | ON | OFF | OFF | OFF | OFF | 3.3 | MEDIUM | NONE
U19/2 | - | in | IOR22[B] | - | LVCMOS33 | OFF | UP | OFF | ON | OFF | OFF | OFF | OFF | 3.3 | MEDIUM | NONE
W21/2 | - | in | IOR24[A] | SGCLKT_1/RPLL0_T_FB0/RPLL1_T_FB0 | LVCMOS33 | OFF | UP | OFF | ON | OFF | OFF | OFF | OFF | 3.3 | MEDIUM | NONE
Y21/2 | - | in | IOR24[B] | SGCLKC_1/RPLL0_C_FB0/RPLL1_C_FB0 | LVCMOS33 | OFF | UP | OFF | ON | OFF | OFF | OFF | OFF | 3.3 | MEDIUM | NONE
U21/2 | - | in | IOR26[A] | MGCLKT_1/RPLL0_T_FB1/RPLL1_T_FB1 | LVCMOS33 | OFF | UP | OFF | ON | OFF | OFF | OFF | OFF | 3.3 | MEDIUM | NONE
V21/2 | - | in | IOR26[B] | MGCLKC_1/RPLL0_C_FB1/RPLL1_C_FB1 | LVCMOS33 | OFF | UP | OFF | ON | OFF | OFF | OFF | OFF | 3.3 | MEDIUM | NONE
Y22/2 | - | in | IOR29[A] | SGCLKT_0/RPLL0_T_IN0/RPLL1_T_IN0 | LVCMOS33 | OFF | UP | OFF | ON | OFF | OFF | OFF | OFF | 3.3 | MEDIUM | NONE
Y23/2 | - | in | IOR29[B] | SGCLKC_0/RPLL0_C_IN0/RPLL1_C_IN0 | LVCMOS33 | OFF | UP | OFF | ON | OFF | OFF | OFF | OFF | 3.3 | MEDIUM | NONE
U22/2 | - | in | IOR31[A] | MGCLKT_0/RPLL0_T_IN1/RPLL1_T_IN1 | LVCMOS33 | OFF | UP | OFF | ON | OFF | OFF | OFF | OFF | 3.3 | MEDIUM | NONE
V22/2 | - | in | IOR31[B] | MGCLKC_0/RPLL0_C_IN1/RPLL1_C_IN1 | LVCMOS33 | OFF | UP | OFF | ON | OFF | OFF | OFF | OFF | 3.3 | MEDIUM | NONE
AA22/2 | - | in | IOR33[A] | FBTEST_R0 | LVCMOS33 | OFF | UP | OFF | ON | OFF | OFF | OFF | OFF | 3.3 | MEDIUM | NONE
AA23/2 | - | in | IOR33[B] | CLKTEST_R0 | LVCMOS33 | OFF | UP | OFF | ON | OFF | OFF | OFF | OFF | 3.3 | MEDIUM | NONE
AB24/2 | - | in | IOR35[A] | - | LVCMOS33 | OFF | UP | OFF | ON | OFF | OFF | OFF | OFF | 3.3 | MEDIUM | NONE
AC24/2 | - | in | IOR35[B] | - | LVCMOS33 | OFF | UP | OFF | ON | OFF | OFF | OFF | OFF | 3.3 | MEDIUM | NONE
V23/2 | - | in | IOR38[A] | - | LVCMOS33 | OFF | UP | OFF | ON | OFF | OFF | OFF | OFF | 3.3 | MEDIUM | NONE
W23/2 | - | in | IOR38[B] | - | LVCMOS33 | OFF | UP | OFF | ON | OFF | OFF | OFF | OFF | 3.3 | MEDIUM | NONE
AA24/2 | - | in | IOR40[A] | - | LVCMOS33 | OFF | UP | OFF | ON | OFF | OFF | OFF | OFF | 3.3 | MEDIUM | NONE
AB25/2 | - | in | IOR40[B] | - | LVCMOS33 | OFF | UP | OFF | ON | OFF | OFF | OFF | OFF | 3.3 | MEDIUM | NONE
Y25/2 | - | in | IOR42[A] | - | LVCMOS33 | OFF | UP | OFF | ON | OFF | OFF | OFF | OFF | 3.3 | MEDIUM | NONE
AA25/2 | - | in | IOR42[B] | - | LVCMOS33 | OFF | UP | OFF | ON | OFF | OFF | OFF | OFF | 3.3 | MEDIUM | NONE
AB26/2 | - | in | IOR44[A] | - | LVCMOS33 | OFF | UP | OFF | ON | OFF | OFF | OFF | OFF | 3.3 | MEDIUM | NONE
AC26/2 | - | in | IOR44[B] | - | LVCMOS33 | OFF | UP | OFF | ON | OFF | OFF | OFF | OFF | 3.3 | MEDIUM | NONE
V24/2 | - | in | IOR47[A] | - | LVCMOS33 | OFF | UP | OFF | ON | OFF | OFF | OFF | OFF | 3.3 | MEDIUM | NONE
W24/2 | - | in | IOR47[B] | VREF | LVCMOS33 | OFF | UP | OFF | ON | OFF | OFF | OFF | OFF | 3.3 | MEDIUM | NONE
W25/2 | - | in | IOR49[A] | - | LVCMOS33 | OFF | UP | OFF | ON | OFF | OFF | OFF | OFF | 3.3 | MEDIUM | NONE
Y26/2 | - | in | IOR49[B] | - | LVCMOS33 | OFF | UP | OFF | ON | OFF | OFF | OFF | OFF | 3.3 | MEDIUM | NONE
V26/2 | - | in | IOR51[A] | - | LVCMOS33 | OFF | UP | OFF | ON | OFF | OFF | OFF | OFF | 3.3 | MEDIUM | NONE
W26/2 | - | in | IOR51[B] | - | LVCMOS33 | OFF | UP | OFF | ON | OFF | OFF | OFF | OFF | 3.3 | MEDIUM | NONE
U25/2 | - | in | IOR53[A] | - | LVCMOS33 | OFF | UP | OFF | ON | OFF | OFF | OFF | OFF | 3.3 | MEDIUM | NONE
U26/2 | - | in | IOR53[B] | - | LVCMOS33 | OFF | UP | OFF | ON | OFF | OFF | OFF | OFF | 3.3 | MEDIUM | NONE
U24/2 | - | in | IOR55[A] | - | LVCMOS33 | OFF | UP | OFF | ON | OFF | OFF | OFF | OFF | 3.3 | MEDIUM | NONE
T22/3 | - | in | IOR56[A] | D19 | LVCMOS33 | OFF | NONE | OFF | ON | OFF | OFF | OFF | OFF | 3.3 | MEDIUM | NONE
R22/3 | - | in | IOR56[B] | D18 | LVCMOS33 | OFF | NONE | OFF | ON | OFF | OFF | OFF | OFF | 3.3 | MEDIUM | NONE
T24/3 | - | in | IOR58[A] | CLKHOLD_N | LVCMOS33 | OFF | UP | OFF | ON | OFF | OFF | OFF | OFF | 3.3 | MEDIUM | NONE
T25/3 | - | in | IOR58[B] | D22 | LVCMOS33 | OFF | NONE | OFF | ON | OFF | OFF | OFF | OFF | 3.3 | MEDIUM | NONE
R25/3 | - | in | IOR60[A] | D26 | LVCMOS33 | OFF | NONE | OFF | ON | OFF | OFF | OFF | OFF | 3.3 | MEDIUM | NONE
P25/3 | - | in | IOR60[B] | D25/VREF | LVCMOS33 | OFF | NONE | OFF | ON | OFF | OFF | OFF | OFF | 3.3 | MEDIUM | NONE
T23/3 | - | in | IOR62[A] | D17 | LVCMOS33 | OFF | NONE | OFF | ON | OFF | OFF | OFF | OFF | 3.3 | MEDIUM | NONE
R23/3 | - | in | IOR62[B] | D16 | LVCMOS33 | OFF | NONE | OFF | ON | OFF | OFF | OFF | OFF | 3.3 | MEDIUM | NONE
R26/3 | - | in | IOR65[A] | D21 | LVCMOS33 | OFF | NONE | OFF | ON | OFF | OFF | OFF | OFF | 3.3 | MEDIUM | NONE
P26/3 | - | in | IOR65[B] | D20 | LVCMOS33 | OFF | NONE | OFF | ON | OFF | OFF | OFF | OFF | 3.3 | MEDIUM | NONE
N26/3 | - | in | IOR67[A] | D24 | LVCMOS33 | OFF | NONE | OFF | ON | OFF | OFF | OFF | OFF | 3.3 | MEDIUM | NONE
M26/3 | - | in | IOR67[B] | D23 | LVCMOS33 | OFF | NONE | OFF | ON | OFF | OFF | OFF | OFF | 3.3 | MEDIUM | NONE
R20/3 | - | in | IOR69[A] | D28 | LVCMOS33 | OFF | NONE | OFF | ON | OFF | OFF | OFF | OFF | 3.3 | MEDIUM | NONE
R21/3 | - | in | IOR69[B] | D27 | LVCMOS33 | OFF | NONE | OFF | ON | OFF | OFF | OFF | OFF | 3.3 | MEDIUM | NONE
P19/3 | - | in | IOR71[A] | CSI_B | LVCMOS33 | OFF | UP | OFF | ON | OFF | OFF | OFF | OFF | 3.3 | MEDIUM | NONE
N19/3 | - | in | IOR71[B] | D31 | LVCMOS33 | OFF | NONE | OFF | ON | OFF | OFF | OFF | OFF | 3.3 | MEDIUM | NONE
R18/3 | - | in | IOR73[A] | - | LVCMOS33 | OFF | UP | OFF | ON | OFF | OFF | OFF | OFF | 3.3 | MEDIUM | NONE
P23/3 | - | in | IOR74[A] | D30 | LVCMOS33 | OFF | NONE | OFF | ON | OFF | OFF | OFF | OFF | 3.3 | MEDIUM | NONE
P24/3 | - | in | IOR74[B] | D29 | LVCMOS33 | OFF | NONE | OFF | ON | OFF | OFF | OFF | OFF | 3.3 | MEDIUM | NONE
N23/3 | - | in | IOR76[A] | RDWR | LVCMOS33 | OFF | DOWN | OFF | ON | OFF | OFF | OFF | OFF | 3.3 | MEDIUM | NONE
N24/3 | - | out | IOR76[B] | DOUT_CSO_B | LVCMOS33 | 8 | UP | OFF | OFF | OFF | OFF | OFF | OFF | 3.3 | MEDIUM | NONE
P20/3 | - | in | IOR78[A] | SGCLKT_3/RPLL2_T_FB0/RPLL3_T_FB0 | LVCMOS33 | OFF | UP | OFF | ON | OFF | OFF | OFF | OFF | 3.3 | MEDIUM | NONE
P21/3 | - | in | IOR78[B] | SGCLKC_3/RPLL2_C_FB0/RPLL3_C_FB0 | LVCMOS33 | OFF | UP | OFF | ON | OFF | OFF | OFF | OFF | 3.3 | MEDIUM | NONE
N21/3 | - | in | IOR80[A] | MGCLKT_3/RPLL2_T_FB1/RPLL3_T_FB1 | LVCMOS33 | OFF | UP | OFF | ON | OFF | OFF | OFF | OFF | 3.3 | MEDIUM | NONE
N22/3 | - | in | IOR80[B] | MGCLKC_3/RPLL2_C_FB1/RPLL3_C_FB1 | LVCMOS33 | OFF | UP | OFF | ON | OFF | OFF | OFF | OFF | 3.3 | MEDIUM | NONE
M21/3 | - | in | IOR83[A] | MGCLKT_2/RPLL2_T_IN1/RPLL3_T_IN1 | LVCMOS33 | OFF | UP | OFF | ON | OFF | OFF | OFF | OFF | 3.3 | MEDIUM | NONE
M22/3 | - | in | IOR83[B] | MGCLKC_2/RPLL2_C_IN1/RPLL3_C_IN1 | LVCMOS33 | OFF | UP | OFF | ON | OFF | OFF | OFF | OFF | 3.3 | MEDIUM | NONE
L22/3 | - | in | IOR85[A] | SGCLKT_2/RPLL2_T_IN0/RPLL3_T_IN0 | LVCMOS33 | OFF | UP | OFF | ON | OFF | OFF | OFF | OFF | 3.3 | MEDIUM | NONE
L23/3 | - | in | IOR85[B] | SGCLKC_2/RPLL2_C_IN0/RPLL3_C_IN0 | LVCMOS33 | OFF | UP | OFF | ON | OFF | OFF | OFF | OFF | 3.3 | MEDIUM | NONE
M24/3 | - | in | IOR87[A] | D14 | LVCMOS33 | OFF | NONE | OFF | ON | OFF | OFF | OFF | OFF | 3.3 | MEDIUM | NONE
M25/3 | - | in | IOR87[B] | D15 | LVCMOS33 | OFF | NONE | OFF | ON | OFF | OFF | OFF | OFF | 3.3 | MEDIUM | NONE
L24/3 | - | in | IOR89[A] | SSPI_CS_N | LVCMOS33 | OFF | UP | OFF | ON | OFF | OFF | OFF | OFF | 3.3 | MEDIUM | NONE
L25/3 | - | in | IOR89[B] | D13 | LVCMOS33 | OFF | NONE | OFF | ON | OFF | OFF | OFF | OFF | 3.3 | MEDIUM | NONE
M20/3 | - | in | IOR92[A] | D11 | LVCMOS33 | OFF | NONE | OFF | ON | OFF | OFF | OFF | OFF | 3.3 | MEDIUM | NONE
L20/3 | - | in | IOR92[B] | D12 | LVCMOS33 | OFF | NONE | OFF | ON | OFF | OFF | OFF | OFF | 3.3 | MEDIUM | NONE
K25/3 | - | in | IOR94[A] | D09 | LVCMOS33 | OFF | NONE | OFF | ON | OFF | OFF | OFF | OFF | 3.3 | MEDIUM | NONE
K26/3 | - | in | IOR94[B] | D10 | LVCMOS33 | OFF | NONE | OFF | ON | OFF | OFF | OFF | OFF | 3.3 | MEDIUM | NONE
P18/3 | - | in | IOR96[A] | MCS_N | LVCMOS33 | OFF | UP | OFF | ON | OFF | OFF | OFF | OFF | 3.3 | MEDIUM | NONE
N18/3 | - | in | IOR96[B] | D08/VREF/SO | LVCMOS33 | OFF | UP | OFF | ON | OFF | OFF | OFF | OFF | 3.3 | MEDIUM | NONE
R16/3 | - | in | IOR98[A] | D06/SSPI_CLK | LVCMOS33 | OFF | UP | OFF | ON | OFF | OFF | OFF | OFF | 3.3 | MEDIUM | NONE
R17/3 | - | in | IOR98[B] | D07/SSPI_WPN | LVCMOS33 | OFF | UP | OFF | ON | OFF | OFF | OFF | OFF | 3.3 | MEDIUM | NONE
N16/3 | - | in | IOR101[A] | D04 | LVCMOS33 | OFF | UP | OFF | ON | OFF | OFF | OFF | OFF | 3.3 | MEDIUM | NONE
N17/3 | - | in | IOR101[B] | D05/SI | LVCMOS33 | OFF | UP | OFF | ON | OFF | OFF | OFF | OFF | 3.3 | MEDIUM | NONE
P15/3 | - | in | IOR103[A] | PUDC_B | LVCMOS33 | OFF | DOWN | OFF | ON | OFF | OFF | OFF | OFF | 3.3 | MEDIUM | NONE
P16/3 | clk | in | IOR103[B] | EMCCLK | LVCMOS33 | OFF | NONE | OFF | ON | OFF | OFF | OFF | OFF | 3.3 | MEDIUM | NONE
R14/3 | - | in | IOR105[A] | D00/MOSI | LVCMOS33 | OFF | UP | OFF | ON | OFF | OFF | OFF | OFF | 3.3 | MEDIUM | NONE
R15/3 | - | in | IOR105[B] | D01/DIN | LVCMOS33 | OFF | UP | OFF | ON | OFF | OFF | OFF | OFF | 3.3 | MEDIUM | NONE
P14/3 | - | in | IOR107[A] | D02/ADCINCK1 | LVCMOS33 | OFF | UP | OFF | ON | OFF | OFF | OFF | OFF | 3.3 | MEDIUM | NONE
N14/3 | - | in | IOR107[B] | D03 | LVCMOS33 | OFF | UP | OFF | ON | OFF | OFF | OFF | OFF | 3.3 | MEDIUM | NONE
M19/3 | - | in | IOR109[A] | - | LVCMOS33 | OFF | UP | OFF | ON | OFF | OFF | OFF | OFF | 3.3 | MEDIUM | NONE
R11/ADC | - | in | ADCTN | - | - | - | - | - | - | - | - | - | - | - | - | -
R12/ADC | - | in | ADCTP | - | - | - | - | - | - | - | - | - | - | - | - | -
P11/ADC | - | in | ADCVN | - | - | - | - | - | - | - | - | - | - | - | - | -
N12/ADC | - | in | ADCVP | - | - | - | - | - | - | - | - | - | - | - | - | -
AA3/MIPI | - | inout | M0_CKN | - | - | - | - | - | - | - | - | - | - | - | - | -
Y3/MIPI | - | inout | M0_CKP | - | - | - | - | - | - | - | - | - | - | - | - | -
W1/MIPI | - | inout | M0_D0N | - | - | - | - | - | - | - | - | - | - | - | - | -
V1/MIPI | - | inout | M0_D0P | - | - | - | - | - | - | - | - | - | - | - | - | -
AA2/MIPI | - | inout | M0_D1N | - | - | - | - | - | - | - | - | - | - | - | - | -
Y2/MIPI | - | inout | M0_D1P | - | - | - | - | - | - | - | - | - | - | - | - | -
W3/MIPI | - | inout | M0_D2N | - | - | - | - | - | - | - | - | - | - | - | - | -
V3/MIPI | - | inout | M0_D2P | - | - | - | - | - | - | - | - | - | - | - | - | -
W4/MIPI | - | inout | M0_D3N | - | - | - | - | - | - | - | - | - | - | - | - | -
V4/MIPI | - | inout | M0_D3P | - | - | - | - | - | - | - | - | - | - | - | - | -
AF2/MIPI | - | inout | M1_CKN | - | - | - | - | - | - | - | - | - | - | - | - | -
AE2/MIPI | - | inout | M1_CKP | - | - | - | - | - | - | - | - | - | - | - | - | -
AC1/MIPI | - | inout | M1_D0N | - | - | - | - | - | - | - | - | - | - | - | - | -
AB1/MIPI | - | inout | M1_D0P | - | - | - | - | - | - | - | - | - | - | - | - | -
AE1/MIPI | - | inout | M1_D1N | - | - | - | - | - | - | - | - | - | - | - | - | -
AD1/MIPI | - | inout | M1_D1P | - | - | - | - | - | - | - | - | - | - | - | - | -
AF3/MIPI | - | inout | M1_D2N | - | - | - | - | - | - | - | - | - | - | - | - | -
AE3/MIPI | - | inout | M1_D2P | - | - | - | - | - | - | - | - | - | - | - | - | -
AF5/MIPI | - | inout | M1_D3N | - | - | - | - | - | - | - | - | - | - | - | - | -
AE5/MIPI | - | inout | M1_D3P | - | - | - | - | - | - | - | - | - | - | - | - | -
AF15/Q0 | - | inout | Q0_ATEST_O | - | - | - | - | - | - | - | - | - | - | - | - | -
C12/Q0 | - | in | Q0_LN0_RXM_I | - | - | - | - | - | - | - | - | - | - | - | - | -
D12/Q0 | - | in | Q0_LN0_RXP_I | - | - | - | - | - | - | - | - | - | - | - | - | -
C10/Q0 | - | out | Q0_LN0_TXM_O | - | - | - | - | - | - | - | - | - | - | - | - | -
D10/Q0 | - | out | Q0_LN0_TXP_O | - | - | - | - | - | - | - | - | - | - | - | - | -
C14/Q0 | - | in | Q0_LN1_RXM_I | - | - | - | - | - | - | - | - | - | - | - | - | -
D14/Q0 | - | in | Q0_LN1_RXP_I | - | - | - | - | - | - | - | - | - | - | - | - | -
C8/Q0 | - | out | Q0_LN1_TXM_O | - | - | - | - | - | - | - | - | - | - | - | - | -
D8/Q0 | - | out | Q0_LN1_TXP_O | - | - | - | - | - | - | - | - | - | - | - | - | -
A13/Q0 | - | in | Q0_LN2_RXM_I | - | - | - | - | - | - | - | - | - | - | - | - | -
B13/Q0 | - | in | Q0_LN2_RXP_I | - | - | - | - | - | - | - | - | - | - | - | - | -
A9/Q0 | - | out | Q0_LN2_TXM_O | - | - | - | - | - | - | - | - | - | - | - | - | -
B9/Q0 | - | out | Q0_LN2_TXP_O | - | - | - | - | - | - | - | - | - | - | - | - | -
A11/Q0 | - | in | Q0_LN3_RXM_I | - | - | - | - | - | - | - | - | - | - | - | - | -
B11/Q0 | - | in | Q0_LN3_RXP_I | - | - | - | - | - | - | - | - | - | - | - | - | -
A7/Q0 | - | out | Q0_LN3_TXM_O | - | - | - | - | - | - | - | - | - | - | - | - | -
B7/Q0 | - | out | Q0_LN3_TXP_O | - | - | - | - | - | - | - | - | - | - | - | - | -
E11/Q0 | - | in | Q0_REFCLKM_0 | - | - | - | - | - | - | - | - | - | - | - | - | -
E13/Q0 | - | in | Q0_REFCLKM_1 | - | - | - | - | - | - | - | - | - | - | - | - | -
F11/Q0 | - | in | Q0_REFCLKP_0 | - | - | - | - | - | - | - | - | - | - | - | - | -
F13/Q0 | - | in | Q0_REFCLKP_1 | - | - | - | - | - | - | - | - | - | - | - | - | -
AF15/Q1 | - | inout | Q1_ATEST_O | - | - | - | - | - | - | - | - | - | - | - | - | -
AD14/Q1 | - | in | Q1_LN0_RXM_I | - | - | - | - | - | - | - | - | - | - | - | - | -
AC14/Q1 | - | in | Q1_LN0_RXP_I | - | - | - | - | - | - | - | - | - | - | - | - | -
AD8/Q1 | - | out | Q1_LN0_TXM_O | - | - | - | - | - | - | - | - | - | - | - | - | -
AC8/Q1 | - | out | Q1_LN0_TXP_O | - | - | - | - | - | - | - | - | - | - | - | - | -
AD12/Q1 | - | in | Q1_LN1_RXM_I | - | - | - | - | - | - | - | - | - | - | - | - | -
AC12/Q1 | - | in | Q1_LN1_RXP_I | - | - | - | - | - | - | - | - | - | - | - | - | -
AD10/Q1 | - | out | Q1_LN1_TXM_O | - | - | - | - | - | - | - | - | - | - | - | - | -
AC10/Q1 | - | out | Q1_LN1_TXP_O | - | - | - | - | - | - | - | - | - | - | - | - | -
AF13/Q1 | - | in | Q1_LN2_RXM_I | - | - | - | - | - | - | - | - | - | - | - | - | -
AE13/Q1 | - | in | Q1_LN2_RXP_I | - | - | - | - | - | - | - | - | - | - | - | - | -
AF9/Q1 | - | out | Q1_LN2_TXM_O | - | - | - | - | - | - | - | - | - | - | - | - | -
AE9/Q1 | - | out | Q1_LN2_TXP_O | - | - | - | - | - | - | - | - | - | - | - | - | -
AF11/Q1 | - | in | Q1_LN3_RXM_I | - | - | - | - | - | - | - | - | - | - | - | - | -
AE11/Q1 | - | in | Q1_LN3_RXP_I | - | - | - | - | - | - | - | - | - | - | - | - | -
AF7/Q1 | - | out | Q1_LN3_TXM_O | - | - | - | - | - | - | - | - | - | - | - | - | -
AE7/Q1 | - | out | Q1_LN3_TXP_O | - | - | - | - | - | - | - | - | - | - | - | - | -
AB11/Q1 | - | in | Q1_REFCLKM_0 | - | - | - | - | - | - | - | - | - | - | - | - | -
AB13/Q1 | - | in | Q1_REFCLKM_1 | - | - | - | - | - | - | - | - | - | - | - | - | -
AA11/Q1 | - | in | Q1_REFCLKP_0 | - | - | - | - | - | - | - | - | - | - | - | - | -
AA13/Q1 | - | in | Q1_REFCLKP_1 | - | - | - | - | - | - | - | - | - | - | - | - | -
