xixi-2380/fpga-instrument/docs/change_log.md

# 修改记录

## 2026-10-13 / 阶段 1 初次实现

- 功能：32 位 DDS、4096x16 同步正弦 ROM、24 位定点增益与饱和输出、双声道帧缓冲、16 位 PT8211 LSBJ、480 帧静音和 240 帧淡入。
- 接口：音频单时钟域，按帧固定调度；ready/valid 成对样本交付；复位/LOCK 同步释放；详细契约见 interfaces.md。
- 环境：安装项目内可移植 Icarus 13 及运行库，不改系统 PATH；Gowin V1.9.12.04。
- 硬件检查：JTAG ID 0x0001081B，1 个器件；C 版由用户确认，PCB 修订及速度等级未确认。
- 时钟修正：原计划 50→96→61.44 MHz 在 P&R 报 PA2078，PFD 10/3.84 MHz 不满足 19..81.25 MHz。保留 rejected_original 报告；更改为 50→32→61.44 MHz，PFD 50/32 MHz，VCO 800/768 MHz，第二级输出分频 12.5。
- 测试修正：帧缓冲 TB 在下降沿改变 frame_ce 后立即读取组合输出，出现 delta-cycle 竞态；增加稳定等待，RTL 无须变更。
- 启动边界复核：第一帧边界表示开始、不是完成一帧；功放开启改在 480 个完整零码帧后，更新独立参考模型并重新执行连续性测试。
- 仿真结果：各模块独立测试、48,000 连续帧和官方 PLL/板级集成测试；确切 PASS/断言数见 reports/validation.md 和原始日志。
- 实现结果：修正 PLL 后离线 P&R 完成；资源与时序见 reports/validation.md。没有实板 CST，不能把内部可行性结果当板级验收。
- 已知问题：PCB 修订、速度等级、PA_EN 极性及电压未实板核验；外部音频 STA 未签核；综合有 CK3000 警告，P&R 显式时钟表正确；未烧录、未测量、未运行 30 分钟实板播放。
- 下一阶段：先完成硬件签核，再进行 SRAM 验证和波形测量；保持 24/40/16 位音频接口和每帧 1280 周期预算，详见 interfaces.md。

## 2026-10-13 / 用户照片核验

- 背面白色版本贴纸读为 Version: v4071f3，Dock 记录为 4071f3；正面丝印对应 Tang Mega 138K Pro Dock。
- 与本地官方 4071f3 PDF 第 18 页匹配，音频参考映射保持 E22/F24/G24/H17；未据此声称电压、芯片 EN 极性或波形已实测。
- 核心板修订和 FPGA 速度等级仍不可读，散热片无需拆除，待购买资料或厂商信息补足。
- 保存两张原始照片与 SHA-256，更新硬件清单；未修改 RTL、未烧录，13 项既有仿真结果保持原有适用范围。

## 2026-10-13 / FPGA 基础型号确认

- 用户确认 FPGA 型号 GW5AST-LV138FPG676A；与工程 GW5AST-138C、FPG676A 封装一致。型号末尾 A 与 Device Version C 分开记录。
- C1/I0 保持为未核实的离线时序假设，不依据基础型号补写实物速度等级；不修改 RTL、引脚或下载状态。

## 2026-10-13 / D0 上板数字诊断准备

- 新增 bringup_digital 包装：运行 BCK/WS，DIN/PA_EN 硬置零；独立官方模型 TB 通过，原 13 项音频测试适用范围未改变。
- 生成六端口 CST，核对实际 P&R 位置和 IO 标准。官方型号表为 C1/I0 提供资料依据；4071/4072 的时钟复位连接交叉一致，实际核心板修订仍未填写。
- 源同步实现约束最终使用 0..30 ns 输出路径界限，没有 false-path 或多周期豁免；保留前两次约束建模诊断。D0 最终 setup/hold 均 0 违例，PR1014/CK3000 警告分析见 bringup_D0.md。
- 用户确认示波器、耳机已准备，无其他 FPGA 外设。下载仅 SRAM Program and Verify，实际成功与否以原始日志和结构化记录为准；示波器结果仍待用户提供。

## 2026-10-13：停止自动烧录，交付手动验证文件

- 遵照用户指令，烧录改由用户操作；program_bringup.py、program_sram.py 在访问设备前直接退出。构建脚本仅离线运行。
- 首次 SRAM 加载完成但回读校验失败；保留原始日志，不记为校验成功。修正 build_bringup.tcl 的 -bit_security 0，生成关闭读回保护的 D0 文件。
- 修正打包时 Gowin 输出文件只读属性造成的覆盖失败，增加 --package-only，重用已完成的离线构建。仅处理工程自身生成的打包文件。
- RTL 与接口未改变；沿用已通过的独立仿真和当前真实引脚 P&R 报告。D0 仅验证数字时钟，DIN/PA_EN 固定零。
- 实测频率、实际电压、模拟音频、长稳仍待用户上板反馈；修正版未由助手烧录。

## 2026-10-13：D0 音频信号引出通用 GPIO

- 按用户要求，保留 DAC/功放原引脚，把 BCK/WS/DIN/PA_EN 镜像到 PMOD1 J24 的 C24/B24/E25/D25，标称 LVCMOS33。官方原理图第 16 页、全引脚 CST、照片丝印交叉核对。
- 新增四个输出端口、CST 和输出延迟约束，仍为同一内部时钟域；DIN/PA_EN 保持零。
- 更新独立 TB 检查镜像边沿、字边界和复位；构建改用独立 D0_gpio_mirror 文件名，保留旧镜像前产物。结果以本次仿真日志及 D0_gpio 时序报告为准。
- 烧录由用户操作，两个自动入口继续禁用。GPIO 波形不能代替 DAC 引脚时序及模拟音频实测。

本次结果：tb_bringup_digital PASS，36666 次断言检查，其中 1409 次镜像转换检查；实际 10 个端口球位/约束状态一致，setup=0、hold=0。新文件 D0_gpio_mirror.fs，SHA-256 e7130b096bce0ddb7d785be1045e1071825dd20afe36f2d2ce1a22f2adf2d968。PR1014（原 P16 时钟路由）与 CK3000 警告保留，锁定/频率仍待实测。新文件未由助手烧录。

## 2026-10-13：按用户图片改用 J23 指定排针

- GPIO 镜像由 PMOD1 移至用户指定图片上排 U22/V19/W20/U26，依次为 BCK/WS/DIN/PA_EN。原 DAC 连接和内部逻辑不变。
- 官方 Dock 原理图第 16 页、官方 Header CST、核心板 4071/4072 Bank 2 引出交叉核对；显式 LVCMOS33。图中八孔均非 GND，文档单独说明接地。
- 新产物使用独立 D0_header_mirror.fs 文件名，保留此前文件及报告。重新运行独立 TB 及实际引脚布局布线，结果见本次日志。
- 烧录继续由用户手动执行；本版静音，电压/频率实测待反馈。

本次指定排针版结果：tb_bringup_digital PASS，36666 次检查，含 1409 次镜像转换；10 个端口约束位置匹配，setup=0、hold=0。新文件 D0_header_mirror.fs，SHA-256 0a03b95728c83c7b0e5179e121d66c8b618244a5771e1d5659383b8601939355。J23 针序按原理图为 U22/V19/W20/U26 对应 39/37/35/33；仅更正文档针号与 CST 注释，实际 IO_LOC/IO_PORT 均未变化，无需重跑 P&R。未由助手烧录，实测待反馈。

## 2026-10-13：D1 低幅 440 Hz 实际发声准备

- 新增统一音频板级顶层及双/左/右三个常量模式入口，复用既有 DDS、ROM、Q1.23 增益、帧缓冲和 PT8211 发送器；480 帧完整零码、PA_EN、240 帧淡入、1/32 增益保持集中配置。
- 原 DAC 连接与用户指定 U22/V19/W20/U26 测量镜像保留；不新增内部时钟或 CDC。
- 新增独立板级 TB，按引脚解码与数学 DDS/定点参考逐样本比较，覆盖正常启动、左右隔离、连续帧、边沿、镜像及播放中复位。仿真/实际引脚 P&R 结果待本次工具运行后追加。
- 用户反馈 D0“没有问题”，未提供数值，不把它扩展为模拟音频、实测电压或长稳验收。新 D1 文件仍由用户烧录，两个自动入口继续停用。

D1 本次结果：tb_tone_play PASS，375334 次检查，双声道两轮各 850 帧，左/右两轮各 120 帧。初版 TB 的三个 PLL 模型持续运行耗时较长，停止后仅优化 TB 已完成隔离检查实例的时钟/复位生命周期，生产 RTL 未改变；重新运行通过（约 353 秒）。三个实际引脚 P&R 均 setup=0、hold=0，4 BSRAM、1 DSP、2 PLL 保留；完整结果及警告分析见 reports/tone_play/validation.md。烧录与实测待用户操作。

## 2026-10-13：演奏输入改用用户 4x4 矩阵键盘

列从左到右 W26/L22/Y26/AA25；行从上到下 W25/M24/Y25/AA24。八个球位已在官方 Header CST 核对，标称 3.3V，互不重复且与现有音频引脚及测量点不冲突。后续按 key_col[0..3]、key_row[0..3] 与 bit(row*4+col) 实现，计划非选列高阻、行上拉、同步/消抖及原子状态提交。每键独立二极管暂未确认；不提前声称任意多键识别。仅更新接线记录，RTL/下载文件未改变；静态映射检查通过。详见 docs/matrix_keypad.md。用户反馈 D1 正常发声，实测数值及其余验收待补充；仍由用户烧录。

## 2026-10-13：D2 矩阵键盘单声部 ADSR

新增矩阵扫描、同步/消抖、鬼键歧义释放、采样边界 Note On/Off、精确时长 ADSR 和流水线音频集成；保持 U22/V19/W20/U26 音频镜像。七个新 TB 通过，共 2631691 检查；单次生产参数首非零码延时仿真约 3.135 ms。历史 D2 P&R 18 端口匹配、setup/hold=0，资源见 reports/keyboard/validation.md。

用户明确综合编译/布局布线/烧录自行完成，后续助手仅改文件及纯 HDL 仿真；当前新 D2 未由助手烧录，实板键位/电气/音频/延时/长稳仍待用户验收。接口与下一阶段约束详见 docs/bringup_keyboard.md。单声部新按键优先、同帧最高键号优先，松开回退至仍按住的最高键号；不宣称复音或无二极管任意多键无冲突。

## 2026-10-14：D2 无响应排查

核对已有端口及上拉报告、ROM 初始化和 .fs 哈希，新增现有综合网表的 Icarus 功能仿真；A4 识别/发声/松开通过（22112 次检查），PLL/复位用行为时钟旁路，实板原因尚未定位。未修改功能 RTL，未运行 Gowin 编译或下载器。待用户实际 .fs 路径和 BCK/WS/PA_EN/键盘行线读数，详见 reports/keyboard/diagnosis_2026-10-14.md。

## 2026-10-14：修正物理行列定义

用户澄清：W26 控制最上方横行，W25 控制最左侧竖列。当前 key_row[0..3] 为 W26/L22/Y26/AA25（同步上拉输入），key_col[0..3] 为 W25/M24/Y25/AA24（选中低、其余高阻输出）。修正 keyboard.cst、编译脚本的位置核查表、机器可读映射及操作说明；音频 GPIO 不变，内部扫描/ADSR 逻辑不变。
新增基于实际 CST 的物理开关网络 TB：修正版 16 位置按下/松开、音频和鬼键共 34 项通过；旧版对照也通过 34 项，显示只转置键位。因此完全无声尚不能归因于此次行列解释，故障未标为修复。
没有运行 Gowin 综合/布局布线或烧录；现有旧 .fs 与旧 P&R 仅作历史记录，当前源码需用户重新编译。

## 2026-10-14：板载运行流水灯

新增 run_leds 及独立 TB，50 MHz 域四灯每 250 ms 轮流亮、不依赖音频 PLL 或用户复位；LED4 为同步后的音频域就绪，LED5 为同步后的音符门控。六灯均低有效，按 Dock 4071f3 图 LED0..5 约束 J14/R26/L20/M25/N21/N23（该版本 LED0/1 命名与旧 CST 位序相反）。键盘及音频球位未变。
更新 keyboard_top 六位 led_n 端口、GPRJ、CST/SDC、编译脚本及输出配置；输出基名 D2_keyboard_leds，用于区分原旧文件。状态信号各两级同步，仅单向观测，不影响音频控制。
tb_run_leds=111、tb_keyboard_top=329180 检查通过，物理键盘映射测试两方向各34项通过。没有运行 EDA 综合/布局布线/烧录，没有生成新的 .fs；当前需用户重新编译，实际无声原因尚未确定。详细用法见 docs/bringup_run_leds.md。

## 2026-10-14：迁移至统一工作根目录

按用户要求，将必要工程文件迁入 E:\gowin\fpga-instrument，主工程保持 keyboard_adsr.gprj / keyboard_top / D2_keyboard_leds。RTL、CST/SDC、参数、ROM 和 TB 原字节迁移；更新现有过程配置中的 include 路径及现有操作文档，重写现有 README 说明当前入口、目录职责、历史证据与操作分工。

原目录及目标下既有嵌套旧参考工程保留不变；不迁入旧 .gprj.user 状态缓存、大批实现中间文件及可再生 .vvp。原始资料、照片和历史日志按原字节保存，历史 D1/D2 下载产物不表示当前源码已实现。必要的旧 D2 网表仅用于现有功能仿真，其 PLL 旁路限制仍然成立。

在原 run_sim.py 与 run_keyboard_pinmap.py 中添加 --out-dir；新日志保存到 reports/migration/，不覆盖旧证据。新增根目录 .gitignore，排除本机工具、历史下载文件、IDE 缓存和可再生输出，保留工程过程配置。初始化本地 Git，用户提示后才提交；本次不提交或推送。

迁移清单、复制与修改前后哈希见 reports/migration/manifest.json；本次 HDL 验证结果另记 reports/migration/validation.json，不沿用旧实现报告作新版本通过证明。没有执行综合、布局布线、EDA 构建或访问 Programmer/JTAG；D2 无声仍待流水灯版实板结果。

迁移后实际验证：tb_run_leds=111、tb_keyboard_top（官方 PLL 模型）=329180、tb_keyboard_latency=5、当前/历史行列映射各34项，全部 PASS，共329364项检查。生产参数首个非零串行码仿真延迟约3.135 ms；不作为实板模拟输出延迟。六个工程依赖、24个球位唯一性、源目录与旧参考完整性检查通过。Git 分支 codex/fpga-migration，未暂存、未提交、未推送。

## 2026-10-14：按用户指令提交，并附已知错误内容

本段记录用户已授权提交；前述“未提交”及迁移 validation.json 中的 Git 状态属于迁移验证时的历史快照。

- 当前未解决故障：用户反馈 D2 键盘版“烧录后没有任何反应”，按键仍无声。原因尚未定位，行列更正不能证明已修复；D2_keyboard_leds 待用户编译烧录并反馈流水灯、LED4/5 和测量结果。
- 本次迁移仿真：329364 项检查全部 PASS，无仿真编译或运行失败。仍有 warning：无源矩阵模型继承 timescale；官方 prim_sim.v 出现 implicit definition of wire（I_hs、cnt_reset、rst、clk2_dt_dir）和 @* found no sensitivities so it will never trigger。原文见 reports/migration/sim/*_compile.log 及 reports/migration/pinmap/*/compile.log；未修改官方模型。
- 历史 PLL 失败（不是本次错误）：ERROR (PA2078): Invalid PFD frequency 'FCLKIN/IDIV_SEL'，旧 pll1/pll2 参数不符合工具范围。证据保留于 reports/gowin/rejected_original/pnr.log；当前源码已采用不同的 50→32→61.44 MHz 配置，本次没有重新综合或布局布线验证。
- 历史下载回读失败（不是本次操作）：Error: Verify failed of at 0，Status Code 0x00026230。证据见 reports/hardware/attempt1_readback_protected/D0_program_sram.log；该历史操作配置已加载但回读校验失败，不能记作校验通过。本次没有访问下载器或 JTAG。

添加 .gitattributes 保留迁移文件原始字节，避免本机 core.autocrlf=true 改变已记录的 SHA-256。提交包含源码、配置、文档及对应证据；忽略工具二进制、历史 .fs、.vvp、IDE 缓存与实现中间文件。不推送远程仓库。

## 2026-10-14：清理无关工程与可再生产物

按用户“清除不必要的文件”要求，工作目录仅保留 keyboard_adsr.gprj 及对应过程配置。移除旧 D0/D1/可行性工程、空嵌套工程、专用板级模块及测试、旧构建与禁用下载脚本、旧网表测试入口和生成网表；当前工程剔除未使用的 tone_top/tone_core，功能 RTL、当前引脚/时序约束、参数和 ROM 不变。

在原 build_keyboard.py 上修改为直接读取现有主工程，不重建工程文件；支持 --sim-dir，默认使用当前验证日志，构建报告与历史报告分开。run_sim.py 和引脚映射脚本默认写当前结果目录；原 tb_keyboard_core 改为从 SIM_OUT_DIR plusarg 保存 CSV，修正固定路径覆盖历史证据的问题。

删除旧 .fs 前确认原工程保有相同 SHA-256；移除模拟器安装缓存和可再生 .vvp，保留运行环境。重复手册已删除，历史说明原文件移到 docs/archive，交付状态原文件移到 reports/bringup/delivery_records。原始错误日志、官方资料、用户照片及迁移证据保留不变。

用户明确授权清理已覆盖此前“保留空嵌套旧工程”的默认安排；源工程不变，旧源码可从 Git 3e1e93b 恢复。没有运行综合、布局布线、下载或 JTAG；没有自动暂存、提交或推送。本次验证结果见 reports/cleanup/validation.json。

清理后验证：17个当前模块测试、1个板级测试及2种引脚映射均PASS，共2721674项检查。当前19个工程文件依赖完整，179份既有报告/资料内容与提交基线一致，旧CSV未覆盖；新CSV已写入指定输出目录。仿真结束后移除可再生.vvp，保留日志与结果。D2无声原因仍未定位，未执行EDA或提交。

## 2026-10-14：按用户提供 CST 校准当前引脚配置

用户指定 E:\FPGA竞赛\开发板资料\09_Misc\tang_mega_138k-pro_pins.cst；其内容与只读 references 同名文件完全一致，SHA-256 f647104f7b74800890d0283a438b226301bff3a3429a04ec0f6df63c9026e8ba。按当前顶层24个端口位核对，不导入未使用外设或DDR实例约束。

在原 keyboard.cst 上将 P16 时钟 PULL_MODE 改为 UP，并按此次用户指定的 CST 逻辑位序将 led_n[0]/[1] 改为 R26/J14；其余22个球位不变。该逻辑编号与4071f3原理图第15页的LED0=J14、LED1=R26相反，本次按用户指定文件统一软件位序，并在原操作说明明确物理图纸标签差别。此变更取代此前按图纸编号排列LED0/1的选择，不代表发现无声根因。

音频、复位、键盘及GPIO测量球位匹配参考；保持明确的LVCMOS33/LVCMOS15。键盘输入行仍上拉、DRIVE=OFF，不能照抄通用Header的输出默认值；列仍低/高阻。参考CST缺少PA_EN，已视图核对匹配板版原理图第18页及第5页，保留H17，不声称这一路来自CST。

同步修改原构建脚本LED检查表、扩充原reference_pins.csv为完整24位清单，记录来源、别名、电气属性及例外；保留清理中的未提交改动。原始CST/PDF及历史日志不修改，历史验证记录仍属于旧位序。验证结果另记reports/pin_calibration/validation.json。没有综合、布局布线、烧录或自动提交；新约束待用户重新编译实现。

本次校准验证：23个CST映射与电气属性逐项匹配（保留已注明的键盘输入例外），PA_EN单独按原理图核对；24球位唯一，构建检查表和引脚清单与当前约束一致。tb_run_leds=111、tb_keyboard_top=329180、两种物理键盘映射各34项，全部PASS，共329359项检查。功能RTL/参数/ROM/测试平台未变，原始参考文件未改；仿真不能验证IO上拉或实现后球位，仍待用户重新编译及实测。

## 2026-10-14：实板可发声，但冷启动等待与底噪待定位

用户反馈：流水灯上电立即运行，键盘和LED4/5初期不响应，数分钟后恢复出声；恢复后LED4稳定、松键LED5灭但持续低频嘶声。核心板USR短按无改善，用户无法进行示波器测量。记录为定性反馈，不填写实测频率、幅度或延迟，不将故障记作已修复。

只读检查用户已有D2_keyboard_leds实现报告，setup/hold违例0，仍有PR1014通用参考时钟路由警告；警告不是已确认根因。保存报告及综合网表快照和现有.fs哈希于reports/startup_noise；没有运行EDA或下载。原始程序没有数分钟的软件等待，USR复位无改善削弱单纯启动复位解释。

在原run_leds、keyboard_top、run_leds_config及原TB上增加只读启动诊断：持续未就绪约1秒后，逻辑LED0=R26参考心跳，LED1=J14原始LOCK1，LED2=L20原始LOCK2，LED3=M25高有效复位输入；LED4/5不变。所有观察输入两级同步，无控制反馈；就绪自动恢复四灯流水。PLL、锁定资格、复位、音频数据、增益和引脚约束保持原样。

扩充原板级TB检查Release后两个声道连续20帧零码、原空闲功放仍开、持续PLL2失锁诊断及恢复。数字零码仿真不代表实板DIN或模拟底噪已验证。同步原操作说明、状态记录和接口文档，等待用户重新编译烧录后的诊断灯反馈。测试结果见reports/startup_noise/validation.json；本次不自动提交。

启动诊断版仿真：tb_run_leds=183、tb_keyboard_top=593419、tb_clock_reset=6，两种引脚映射各34项，共593676项全部PASS。确认故障显示和恢复、20帧空闲零码、失锁立即静音；没有改变PLL/复位/音频逻辑或24个球位。仿真运行文件已清除，保留日志和报告。根因与实板噪声仍未确认。

## 2026-10-14：参照高云原生示例整理为src布局

用户确认保留E:\gowin\fpga-instrument及现有Git，参考C:\Gowin\Gowin_V1.9.12.04_x64\IDE\bin\Documents\fpga_project_test的根目录GPRJ、src源码、impl输出结构。移动现有原文件，不建立副本；17个当前HDL和CST/SDC集中在src，四个头文件与ROM分别位于src/config、src/rom，原硬件记录移到docs/hardware。旧空源码目录已移除。

修改原keyboard_adsr.gprj的相对路径和格式；按安装包原生示例支持的file.other类型登记头文件与HEX，方便IDE直接打开编辑。单一入口、顶层、器件、引脚和输出名保持原值。现有run_sim与引脚映射脚本从同一GPRJ读取HDL列表，更新include路径；原构建脚本、过程配置、ROM生成脚本及ROM加载路径同步修正。

现有.gprj.user只清空旧流程状态和结果列表，保留UI布局；未删除用户实现报告或.fs，也没有执行综合/布局布线/下载。历史文档与报告保持原路径和哈希作版本证据，当前说明和硬件状态同步新位置。C盘参考工程只读未改。

结构验证及迁移前后哈希另记reports/ide_layout/validation.json；本次不自动提交。冷启动等待和空闲底噪未解决，上一轮启动诊断逻辑保持不变。

新src布局验证：17个模块测试、1个板级测试及两种物理引脚映射全部PASS，共2985985项检查。GPRJ内24项文件存在且路径唯一，所有头文件可解析，ROM加载和端到端串行音频通过。原启动诊断逻辑未变，178份既有报告与资料原字节保留；本次仿真可再生文件已清除。未启动EDA或下载，未提交Git。

## 2026-10-14：修复src整理后的头文件连锁报错

用户截图及本次已有综合日志报EX5985/EX3755无法打开四个配置头文件，继而EX3842未定义宏、EX3863语法错误。实际过程配置IncludePath仍为已移走的E:/gowin/fpga-instrument/config；生成的综合.prj和解析参数同样带旧路径。上一轮Icarus显式-Isrc/config掩盖了IDE配置问题，仿真通过不能证明IDE路径有效。失败日志、生成参数与哈希保存在reports/include_fix/user_failed_build，不修改原始失败内容。

直接修改原src/*.sv的include为config/*.svh，两个直接引用配置的原TB为../src/config/*.svh；头文件内部仍引用同目录synth_config.svh。原过程配置和用户构建Tcl统一搜索src与src/config。现有仿真脚本去掉-Isrc/config，使用-grelative-include及正斜杠源文件路径，后者适配Windows版Icarus的相对文件解析。未复制第二套头文件或新建工程。

修复前无配置搜索路径的预处理复现失败；修复后从工程根目录和无关工作目录预处理均通过。逐个核验源文件相对include目标和GPRJ全部文件，反向去除本次include路径修改后，RTL/TB原字节哈希与修复前一致；配置参数、ROM、引脚和音频逻辑不变。完整HDL仿真结果另记reports/include_fix/validation.json。要求关闭再重开主工程，避免IDE缓存旧配置覆盖磁盘设置。未运行Gowin综合、布局布线、下载，未提交Git；冷启动和底噪仍待实板反馈。

头文件修复后：17项模块测试、1项顶层板级测试和两种引脚映射全部PASS，共2985985项检查。最终复核IDE磁盘搜索目录仍正确，Git diff --check通过；仅清除本次可再生.vvp和预处理展开文件，保留失败证据及全部验证日志。

## 2026-10-14：用户确认USR松开时复位诊断灯持续亮

按此前说明和用户确认记录原理图LED1闪烁、LED3常亮、未按住USR。推断U4输入持续为高而保持复位，未测量电压，未认定浮空、按键或器件故障。只读核对用户22:23新实现：包含诊断模块，rst位于U4且原Pull Mode为NONE；保存综合/布局布线报告快照及.fs哈希到reports/reset_input，不运行EDA。

两版核心板原理图第7页的USR均由4.7k外部下拉，按下经1k接1.5V，高有效极性不变。按安装UG304-1.3.8E支持的弱下拉设置，在原CST仅把rst PULL_MODE NONE改为DOWN；原reference_pins.csv和状态说明记录偏离用户通用CST的例外及未验证边界。外部下拉本来存在，内部弱下拉不是已确认根因修复，若仍高需检查实际电路或映射。

扩充原板级TB重现持续高复位、诊断及释放后A4音频恢复；未新建模块、工程或重复头文件。功能RTL、PLL参数、音频逻辑、球位及电压不变。纯HDL仿真不能验证内部下拉的电气效果。未综合、布局布线、烧录或提交Git；冷启动和底噪尚未验收。

本次针对性验证：tb_clock_reset=6、tb_run_leds=183、扩充后的tb_keyboard_top=701884，全部PASS，共702073项检查。24个球位和电气表核对一致；所有功能RTL/参数/ROM字节未变。清除本次.vvp并保留日志。新约束尚待用户实现及实板验证。

## 2026-10-14：用户确认启动恢复并要求Git提交

用户反馈“好的，现在正常了”，随后要求“git一遍然后处理底噪问题”，并要求按钮逻辑与其他模块分离以便后续更换键盘。本次先提交截至U4下拉修复的当前完整工程：包括此前授权的清理、src布局、引脚校准、头文件路径修复、启动诊断和复位输入下拉；不包含尚未实施的底噪或接口重构。

启动恢复以用户定性反馈为依据，不填写实测电压或多次冷启动成功率。最近针对性HDL仿真702073项全PASS，完整模块仿真见reports/include_fix，旧实现及失败日志保持历史归属。复位物理异常原因和空闲低频嘶声未确认；后续综合、布局布线、烧录仍由用户执行。本次用户明确授权Git提交，不推送。

## 2026-10-15：提交启动修复，按用户要求分离键盘与音源

已按用户“git一遍”要求提交f48aeca（301个文件含原文件移动及历史证据），内容截至用户确认U4内部下拉后恢复正常。原始报告包含工具固有尾随空格，按证据保留原字节；维护源码和文档的暂存差异格式检查通过。未推送。

用户随后确认底噪来自耳机阻抗过低，并明确取消底噪处理。本轮未实施曾讨论的PA自动关闭、唤醒等待或淡入策略变更；不把用户结论描述成电气测量。沿用原功放、音频参数、PLL和复位约束。

原keyboard_core改为可替换矩阵输入适配器，保留matrix_keypad和mono_note_control；将原ADSR/DDS/增益/缓存/PT8211流水线提取为独立synth_core，通过note_on/note_off/fcw和frame_ce/note_ready连接。原keyboard_top中连接两者；USR仍由clock_reset处理。新增独立模块是用户明确的职责分离需求，不复制第二版本模块或工程。ADSR默认宏移至原synth_config，数值不变，音源及ADSR不再引用键盘专属配置。

原GPRJ登记新增音源，现有仿真从同一工程读取；原键盘集成与延迟TB仅调整模块连接及观察层级，新增tb_synth_core直接输入音符，验证无键盘的发声、Release、重触发、复位和原PA行为。验证记录独立写reports/input_separation；尚未再次提交，未运行EDA或烧录。

接口分离验证：18项模块测试、1项板级及两种引脚映射全部PASS，共3294338项检查。原D2_samples.csv逐字节相同，生产参数仿真Note On=3.083548ms、首码=3.135306ms、Note Off=2.948164ms不变。25项工程依赖与相对include完整，参数数值、PLL/复位/引脚/功放控制及ROM字节不变。仿真不能代替新工程实现验收。

2026-10-15用户确认接口分离版“测试正常”并要求下一步。源文件哈希与此前3294338项仿真回归记录一致；补记用户定性实板反馈，不重复仿真或伪造测量。下一阶段优先项正在澄清，不自动提交Git。

## 2026-10-15：用户明确选择四声部复音

用户在接口分离版实板测试正常后，明确回复“四声部复音（推荐，按原规划）”。本轮在原工程继续，不创建第二套工程或带后缀的修正版。原mono_note_control及TB按新职责重命名为key_note_events；keyboard_core只保留矩阵和事件适配，synth_core内新增独立voice_allocator与voice_mixer。

输入采用audio_clk域valid/ready、7位音符身份和32位FCW。回压时载荷稳定；矩阵状态优先派发释放。声部所有权按同身份、空闲、最旧释放、最旧按住分配；旧Note Off不能误关新身份，同身份重触发不重复占槽；有界年龄排序避免计数回绕。声部命令在frame_ce统一执行；新身份同步重启相位和包络，四路各自24位增益后40位求和并一次转16位饱和。每声部原1/32增益和原启动/PA时序保留，U4下拉、PLL、CST/SDC和GPIO字节未修改。

修改原DDS/ADSR加入帧使能同步restart，原tone_gain增加16/24位输出参数；默认16位单元行为保留。新模块是四声部功能所需的独立职责，不保留旧mono重复文件。主GPRJ现含20个HDL和27项总依赖。原构建脚本更新测试名、参数记录及共享TB参考文件哈希，仅供用户运行，助手没有执行。

扩充原核心/板级/延迟/引脚TB，新增分配器与混音单元TB、共享独立正弦/取整/串行数值参考。覆盖四个独立尾音、释放后重用、第五音及旧松键、短On/Off、同身份重触发、160次溢出排序、复位、失锁恢复与鬼键释放。端到端逐帧数值核对四路相位/查表/固定点混音，不用听音替代。

开发中首次混音零输入测试暴露组合求和在输入从上电保持零时的仿真未知值；改成显式40位连续符号扩展求和后，零、负数、抵消、正负饱和及1000组随机输入通过。原失败日志保留reports/four_voice/unit_initial及mixer_*_diagnosis，最终回归单独记录，不隐藏失败。

用户取消的底噪处理没有实施；四声部通过HDL不等于Gowin资源/STA或实板验收。启动及接口分离的既有实板反馈只属于前版本。没有综合、布局布线、烧录或自动Git提交。精确回归汇总见reports/four_voice/validation.json。

四声部最终回归：20项模块、1项官方PLL板级和两种物理引脚映射全部PASS；核心测试补充安全五键组合后按每项最新结果汇总7051357项检查。生产仿真Note On=3.079088ms、首非零码=3.176972ms、Note Off=3.102037ms，均低于5ms。无配置-I路径的两种工作目录预处理通过；27项工程依赖、原保护文件哈希和维护文件格式检查通过。IDE配置再次出现旧根config路径，仅修正IncludePath并记录前后值。清除本次可再生.vvp/预处理展开文件，保留所有失败与通过日志。Git仍为f48aeca，本轮未提交。

## 2026-10-15：四声部实板测试正常，用户要求提交

用户反馈“好的，现在提交git，测试正常”。核对全部功能源文件和测试输入SHA-256，与7051357项最终回归一致，无功能改动，无须重复仿真。本次按明确授权提交此前输入/音源分离与四声部复音：通用握手事件、独立ADSR/DDS、40位混音、声部替换及旧松键保护、鬼键释放和对应验证记录。

实板结果仅按用户定性反馈记录，不推断频率、电压、延迟、资源时序或长稳测量。开发期混音零输入X问题已修复，原失败日志保留；最终HDL测试全部PASS，阵列敏感项与官方原语模型warning原文保留。前述“未提交”以及验证时Git字段是历史快照；本段记录用户本轮明确授权。不运行EDA或烧录，不推送远程。

## 2026-10-15：私有仓库上传与中文规划整理

用户明确要求提交GitHub，并选择新建私有仓库。已创建xixi-2380/fpga-instrument，将已实板测试正常的715920f及其历史上传到main；上传后核对远程提交与本地完全一致，仓库为私有。本地codex/fpga-migration跟踪origin/main，未发送协作者邀请。

用户随后要求“再把规划一起上传，显示的更改最好加上中文”。原规划位于旧交接第11节，已随历史文件上传；本次直接整理原README，在GitHub首页展示完整阶段路线、已完成/待实现状态、最终目标、32声部帧预算及后续验收重点。四声部已获用户实板定性确认；32声部、多音色、效果器、第二演奏维度和显示仍未实现或验收，记录规划不等于启动开发。

补充中文版本索引：715920f为“四声部复音与键盘/音源分离”，f48aeca为“src布局、头文件与启动复位修复”，3e1e93b为“工程迁移与无声故障记录”。本次提交使用中文标题与摘要，AGENTS记录后续中文提交偏好；已有共享提交保留原哈希和原始说明。

本次仅修改README.md、docs/change_log.md和AGENTS.md。验证范围为文档链接、规划与旧交接/现有实现的一致性、差异格式及功能源码与715920f的哈希一致性；不重复HDL仿真，不运行综合、布局布线或烧录。此前7051357项检查与用户实板反馈仍属于715920f功能基线，不作为本次新增测试。本次文档提交按用户要求上传main。

## 2026-10-15：每次成功更新后自动提交与上传

用户明确要求“每次成功更新就提交一次git和github”，作为后续持续授权，取代此前逐次提示才提交或推送的约定。每次完成一项有意义的更新并通过相应检查后，用中文标题及摘要创建一次Git提交，推送现有私有仓库origin/main并核对远程版本；仅提交本次任务改动，保持共享历史，不强制推送。推送失败时如实说明已提交但未同步。

直接修改原AGENTS.md与README.md中的协作规则。RTL按改动范围运行HDL仿真，文档执行内容、链接和差异检查；仿真与用户实板反馈分别记录。该授权仅改变提交/上传流程，不授权新功能、综合、布局布线、烧录或公开仓库。

本次仅调整三个现有文档，检查规则一致性、文档链接、差异格式及已验证源码哈希；未修改功能或重新运行HDL仿真。按本条授权提交并推送。

## 2026-10-15：下一阶段32声部实现规划

用户要求“好，现在进行下一步规划”。读取现有四声部音源、分配器、DDS、ADSR、增益、混音、帧缓冲与测试参考，在原README、interfaces和modules内完善方案；AGENTS记录本轮为规划，当前RTL仍四声部。

拟保留32份独立声部状态及包络，复用同步正弦ROM、启动增益/声部增益运算和40位顺序累加。每声部16周期、准备及收尾共预留32周期，预算544/1280周期；渲染期回压保证帧内所有权一致，音频不停钟。该预算是设计要求，尚未由新RTL验证，实际资源/时序由用户后续实现报告确认。

顺序为分配器1/4/32验证、四声部共享通路等价、32声部满负载集成，再由用户实现与实板验收。写明第33音、旧松键、独立尾音、数值参考、截止时间、复位/失锁和延迟验收；现有16键无二极管矩阵不能证明32同时输入，使用独立音符事件TB。保持原增益、引脚、PLL、功放和已关闭的底噪任务。

本次仅改五个现有文档，核对本地链接/规划锚点、帧预算与位宽算术、原实现对应关系、差异格式及58项已验证源码哈希。未修改RTL，未运行新HDL仿真、综合、布局布线或烧录；不把旧7051357项检查扩展为32声部通过。按持续授权中文提交并上传GitHub。

## 2026-10-16：32声部阶段A，分配器参数边界验证

用户明确要求现在进行程序修改，授权实施已规划32声部。在原tb_voice_allocator中加入1/4/32参数案例，独立时间戳模型核对所有权及FCW，有界排序排列/范围、重复身份、独立释放、满额替换、旧Note Off、重触发、回压、600次长序列和短On/Off均通过，共1003276项检查。原voice_allocator功能无需修改，生产配置仍为4。

基线哈希写reports/thirty_two_voice/baseline_sources.json，阶段日志及汇总独立保存stage_a，源码与工程入口哈希未变。检查差异格式并清除本次可再生vvp；未执行EDA或烧录。按持续授权提交并推送，接着实施共享运算通路。

## 2026-10-16：阶段B共享音频运算通过四声部回归

直接修改原dds_sine为独立相位上下文共用同步ROM；原synth_core保留各ADSR，在帧边界锁存FCW/restart，渲染时回压输入，每16周期调度一次共享启动乘法/tone_gain；原voice_mixer改为40位寄存累加及包含最后项的一次截断/饱和。保持音频1280周期帧、启动/PA策略及当前增益，无新CDC或派生时钟。

原DDS测试增加32上下文交错读取，原混音测试覆盖单/四/32项、气泡、最后项、随机/饱和及部分帧复位；共享参考逐声部核对相位/数值，每帧核对只交付一次及截止时间。run_sim增加受限整数参数覆盖以复用原TB。6项测试7130993检查全部通过，生产参数首码3.176972ms，官方PLL板级、五键物理组合及鬼键路径通过。日志与哈希见reports/thirty_two_voice/stage_b_validation.json。

生产VOICE_COUNT暂保持4；源码中唯一DDS/ROM、启动乘法和tone_gain路径不等于实际DSP/BSRAM资源保证。原CST/SDC、PLL、复位、启动、ROM字节与基线相同。未执行EDA或实板测试；按授权保存并上传本阶段，再接入32声部。

## 2026-10-16：阶段C完成32声部集成与回归

原配置VOICE_COUNT从4改32，保持原引脚、PLL、复位、ROM及PA/增益。原synth TB参数化，直接输入32独立编号/FCW，覆盖第33音、旧松键、重触发、全部释放、同相满幅、回压、渲染中复位和256次突发；原物理键盘TB将安全第五键改为独立声部，保留四声部参数时的溢出检查。共享数学参考逐声部及串行逐帧核对、唯一交付、连续帧与截止断言。

首次带参数编译因脚本把-P选项拼接在源码列表尾部，被本机Icarus当作文件，未进入HDL运行；失败原文保留stage_c_32_initial/tb_synth_core_compile.log。修正为源码前的分离参数后，1/4/32及多参数满幅测试均通过，未改RTL掩盖失败。

20项RTL、1项官方PLL板级、2种物理映射及3个参数/满幅变体合计14344700次检查全PASS；相同32配置初测和阶段A/B不重复累计。实际交付1/4/32分别21/69/517周期，均满足48/96/544预算；生产Note On=3079.088µs、首码=3176.972µs、Note Off=3102.851µs。GPRJ27依赖/20HDL、无额外配置搜索路径的两种cwd预处理、原保护文件哈希与格式检查通过。

原用户构建脚本改为从synth_config读取声部数，增加共享通路相关必需测试；仅静态检查，没有运行构建。README/接口/模块/上板说明与硬件状态明确当前32版未实板验收；原四声部用户确认按715920f保留。源码逻辑共享路径不代表实际DSP/BSRAM数量，分配器比较路径及32份ADSR资源/时序待用户报告。未综合、布局布线或烧录，按持续授权中文提交并上传。

## 2026-10-19：降低音频串行输出驱动作时钟同步尖峰对照

用户确认松键左声道尖峰与BCK边沿固定对应，探头尖端移到GND后基本消失，耳机保持插入。本次重新打开噪声排查；未把此现象直接等同可听底噪或确认某一耦合路径。原keyboard.cst只将三路DAC串行及三路调试镜像驱动8改4 mA，保持引脚、RTL、PLL、PA、增益和静音策略。更新现有说明、硬件状态和独立验证记录，保留此前历史证据。

音频时钟、PT8211串行及官方PLL板级三项HDL测试合计1203710次检查通过；六路驱动差异、全部球位、其他源码哈希与27项工程依赖检查通过。验证结果见reports/audio_noise/2026-10-19_drive4/validation.json；HDL不能验证IO驱动、电气噪声或Gowin实现。待用户重新综合、布局布线、烧录并以相同接法对比。

### 同步已有多音色更新

常规推送因远端已有281c167而被非快进拒绝。保留ec639c7与远端多音色提交，合并AGENTS/README冲突并保留双方说明；全部src/sim/GPRJ以远端多音色版本为准，唯一功能差异仍为原CST六路驱动。合并后另跑板级、多音色、时钟和串行测试，证据见reports/audio_noise/2026-10-19_drive4/merge_validation.json。远端记录的既有严重Setup违例不在本轮修复，不得在新时序报告通过前将此版当作稳定上板版本。

合并后官方PLL板级、多音色、音频时钟和串行四项HDL测试共1749712次检查通过，517周期交付保持；待提交src/sim/GPRJ与281c167逐字节核对，仅CST为ec639c7六路驱动对照，30依赖完整。工作区另有未暂存tb_key_note_events调整及reports/integration并行验证文件，保留且不纳入本次提交；它们未参与这四项测试。模拟噪声与当前STA仍未验收。

最终同步核对：并行集成会话已提交c021de9，包含事件TB声明顺序兼容调整及完整集成证据。其23项RTL加官方PLL板级共9386744次检查通过，当前源码哈希已核对；不与本轮1749712次重复累计。先前“未暂存/排除”描述为当时状态，最终交付以reports/audio_noise/2026-10-19_drive4/final_delivery.json为准。六路4 mA对照保持；模拟降噪及当前STA仍待实测。

## 2026-10-19：修复多音色分配器长组合链，补测普通双键爆音

用户最终明确普通双键也可触发瞬间爆音。读取下载副本当前STA，确认音频Fmax5.499 MHz、1762个Setup违例，最差allocator路径180级/181.520 ns。原voice_allocator改为逐拍读上下文/比较、注册目标/年龄、握手时常量索引提交，帧与停用可取消未确认搜索；保留32声部、三音色及原GPIO/PLL/PA/增益。

原测试增加1/3/4/17/32配置、帧前/就绪前打断、停用、复位及音色原子性；三种音色单键与普通双键起音/独立释放、板级物理双键、同相满幅均核对。最终29个配置共21,228,787次检查通过，517拍交付，首码3.176972 ms。满幅刺激曾因wait组合frame_ce的delta脉冲而计错帧，改为主时钟边沿采样后保留精确±32767断言通过，失败日志未覆盖。

证据见reports/multitimbral_fix/2026-10-19/validation.json。未运行EDA或烧录，新Fmax与爆音改善须用户重新实现并实测，不宣称硬件故障已解决。

## 2026-10-19：记录多音色模块列表未刷新并纠正头文件目录回退

用户报告EX3937未知timbre_control。磁盘原工程21个HDL及模块源码均存在，但当次IDE解析文件列表仍只有旧20个HDL；补充重新打开原工程与添加现有模块的处理方法。IDE自动保存另将IncludePath回退至废弃config目录，本次恢复src、src/config相对路径，其他设置逐项确认相同。未改变RTL，沿用4901d8f数字验证，不宣称本次已通过高云重编译或实板测试。

## 2026-10-19：加入一次《小星星》旋律与和弦试听

用户确认上电自动播放一次、结束恢复键盘。新增独立score_player与曲谱头文件，42音符、48拍、120BPM，笛管旋律加正弦三音和弦；通过原握手接口送音符，播放器与矩阵/音源分离。顶层曲终等待Off与RELEASE+4帧，再选通键盘；期间按住的键可在恢复后识别，USR重播，SCORE_ENABLE=0保持原手动模式。原音源、CST/SDC、PLL、PA和增益不变。

原工程同步为22个HDL、32依赖，仿真与构建证据列表包含新功能；参考模型支持指定层次供完整顶层逐样本对照。最终30个配置17,323,372次检查通过，含生产24000帧节拍、9604帧尾音、回压、关闭功能、官方PLL曲谱到键盘交接及原手动/引脚测试。未执行EDA或烧录，更新后须关闭重开原工程并由用户确认61.44MHz时序。
