xixi-2380/fpga-instrument/src/bluetooth_audio_bridge.sv

`timescale 1ns/1ps
// Automatic IDs 0..15 are independent; ordinary note events preserve effects.
// Only source takeover and explicit Silence clear the engine/serial buffers.
module bluetooth_audio_bridge #(parameter integer DRAIN_FRAMES=66)(
 input wire clk,rst,frame_ce,event_valid,input wire [1:0] event_kind,
 input wire [6:0] event_pitch,event_velocity,input wire inhibit,
 output wire event_ready,output wire note_valid,input wire note_ready,
 output wire note_on,output wire [6:0] note_id,
 output wire [31:0] note_fcw,output wire [6:0] note_velocity,output wire flush,
 input wire [4:0] selected_timbre,output reg [4:0] note_timbre,output wire [6:0] note_pitch,input wire audio_ready,
 input wire [6:0] event_id,output wire output_flush,input wire [4:0] event_timbre,input wire event_legacy);
 localparam [2:0] IDLE=0,CLEAR=1,SEND=2,ACK=3,DRAIN=4;
 localparam integer CW=$clog2(DRAIN_FRAMES+3);
 reg [2:0] state;reg [CW-1:0] count;
 reg prior_inhibit,on_latched,has_event,silence_latched;reg [6:0] pitch,velocity,ident;
 reg [31:0] fcw;
 function automatic [31:0] frequency(input [6:0] midi);
 begin case(midi)
 7'd21:frequency=32'd2460658;
 7'd22:frequency=32'd2606977;
 7'd23:frequency=32'd2761996;
 7'd24:frequency=32'd2926232;
 7'd25:frequency=32'd3100235;
 7'd26:frequency=32'd3284585;
 7'd27:frequency=32'd3479896;
 7'd28:frequency=32'd3686822;
 7'd29:frequency=32'd3906052;
 7'd30:frequency=32'd4138318;
 7'd31:frequency=32'd4384395;
 7'd32:frequency=32'd4645104;
 7'd33:frequency=32'd4921317;
 7'd34:frequency=32'd5213953;
 7'd35:frequency=32'd5523991;
 7'd36:frequency=32'd5852465;
 7'd37:frequency=32'd6200470;
 7'd38:frequency=32'd6569170;
 7'd39:frequency=32'd6959793;
 7'd40:frequency=32'd7373644;
 7'd41:frequency=32'd7812103;
 7'd42:frequency=32'd8276635;
 7'd43:frequency=32'd8768789;
 7'd44:frequency=32'd9290209;
 7'd45:frequency=32'd9842633;
 7'd46:frequency=32'd10427907;
 7'd47:frequency=32'd11047982;
 7'd48:frequency=32'd11704930;
 7'd49:frequency=32'd12400941;
 7'd50:frequency=32'd13138339;
 7'd51:frequency=32'd13919586;
 7'd52:frequency=32'd14747287;
 7'd53:frequency=32'd15624207;
 7'd54:frequency=32'd16553270;
 7'd55:frequency=32'd17537579;
 7'd56:frequency=32'd18580418;
 7'd57:frequency=32'd19685267;
 7'd58:frequency=32'd20855814;
 7'd59:frequency=32'd22095965;
 7'd60:frequency=32'd23409859;
 7'd61:frequency=32'd24801882;
 7'd62:frequency=32'd26276679;
 7'd63:frequency=32'd27839171;
 7'd64:frequency=32'd29494575;
 7'd65:frequency=32'd31248413;
 7'd66:frequency=32'd33106541;
 7'd67:frequency=32'd35075158;
 7'd68:frequency=32'd37160835;
 7'd69:frequency=32'd39370534;
 7'd70:frequency=32'd41711627;
 7'd71:frequency=32'd44191930;
 7'd72:frequency=32'd46819719;
 7'd73:frequency=32'd49603764;
 7'd74:frequency=32'd52553357;
 7'd75:frequency=32'd55678342;
 7'd76:frequency=32'd58989149;
 7'd77:frequency=32'd62496826;
 7'd78:frequency=32'd66213081;
 7'd79:frequency=32'd70150316;
 7'd80:frequency=32'd74321671;
 7'd81:frequency=32'd78741067;
 7'd82:frequency=32'd83423255;
 7'd83:frequency=32'd88383859;
 7'd84:frequency=32'd93639437;
 7'd85:frequency=32'd99207528;
 7'd86:frequency=32'd105106715;
 7'd87:frequency=32'd111356685;
 7'd88:frequency=32'd117978298;
 7'd89:frequency=32'd124993653;
 7'd90:frequency=32'd132426162;
 7'd91:frequency=32'd140300631;
 7'd92:frequency=32'd148643341;
 7'd93:frequency=32'd157482134;
 7'd94:frequency=32'd166846509;
 7'd95:frequency=32'd176767719;
 7'd96:frequency=32'd187278874;
 7'd97:frequency=32'd198415056;
 7'd98:frequency=32'd210213429;
 7'd99:frequency=32'd222713370;
 7'd100:frequency=32'd235956596;
 7'd101:frequency=32'd249987305;
 7'd102:frequency=32'd264852324;
 7'd103:frequency=32'd280601263;
 7'd104:frequency=32'd297286682;
 7'd105:frequency=32'd314964268;
 7'd106:frequency=32'd333693018;
 7'd107:frequency=32'd353535438;
 7'd108:frequency=32'd374557749;
 default:frequency=0; endcase end endfunction
 assign flush=state==CLEAR || state==DRAIN;
 assign output_flush=state==CLEAR;
 assign note_valid=state==SEND;
 assign note_on=on_latched;
 assign note_id=ident;
 assign note_fcw=fcw;
 assign note_velocity=velocity;
 assign note_pitch=pitch;
 assign event_ready=state==ACK || (state==SEND && note_ready);
 always @(posedge clk or posedge rst)begin
  if(rst)begin state<=IDLE;count<=0;prior_inhibit<=0;has_event<=0;silence_latched<=0;on_latched<=0;pitch<=0;fcw<=0;velocity<=127;ident<=0;note_timbre<=0;end
  else begin
   prior_inhibit<=inhibit;
   case(state)
    IDLE:if(event_valid)begin
     has_event<=1;silence_latched<=event_kind>=2;on_latched<=event_kind==1;pitch<=event_pitch;velocity<=event_velocity;ident<=event_id;note_timbre<=event_legacy===1'b0 ?event_timbre:selected_timbre;
     fcw<=frequency(event_pitch);
     if(event_kind==3)begin state<=DRAIN;count<=0;end
     else if(event_kind==2 || (inhibit && !prior_inhibit))begin state<=CLEAR;count<=0;end
     else state<=SEND;
    end else if(inhibit && !prior_inhibit)begin has_event<=0;state<=CLEAR;count<=0;end
    DRAIN:if(frame_ce)begin
     if(count==DRAIN_FRAMES-1)begin count<=0;state<=CLEAR;end
     else count<=count+1'b1;
    end
    // Two frame boundaries replace both serializer channels with silence
    // before acknowledging a clear, without disturbing BCLK/LRCLK.
    CLEAR:if(frame_ce)begin
     if(count==0)count<=1;
     else if(audio_ready)state<=has_event ? (silence_latched?ACK:SEND) : IDLE;
    end
    SEND:if(note_ready)state<=IDLE;
    ACK:state<=IDLE;
    default:state<=IDLE;
   endcase
  end
 end
endmodule
