xixi-2380/fpga-instrument/src/reset_sync.sv

`timescale 1ns/1ps
module reset_sync(input wire clk, input wire arst, output wire rst);
    (* syn_preserve=1, syn_async_reg=1 *) reg [1:0] pipe;
    always @(posedge clk or posedge arst)
        if (arst) pipe <= 2'b11;
        else pipe <= {pipe[0],1'b0};
    assign rst=pipe[1];
endmodule
