xixi-2380/fpga-instrument/(commit log)

2026-10-14 迁移 FPGA 工程至统一目录并记录未解决无声问题
    将必要文件迁入 E:\gowin\fpga-instrument，以 keyboard_adsr.gprj / keyboard_top / D2_keyboard_leds 为主入口。
    修正现有配置与操作文档路径，保留原工程及既有旧参考；RTL、约束、ROM、参数和 TB 原字节迁移。
    为现有仿真脚本增加 --out-dir，保留历史证据；配置 Git 忽略规则并保持文件字节与哈希一致。
    验证：
    - tb_run_leds=111、tb_keyboard_top=329180、tb_keyboard_latency=5，当前/历史行列映射各34项，合计329364项检查全部 PASS。
    - 六个工程的文件依赖及24个球位唯一性检查通过。
    - 生产参数首非零串行码仿真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
    [D1_decoded.csv, D2_samples.csv, reference_pins.csv, tone_samples.csv]
2026-10-15 Organize src project, fix include paths and held-reset startup
    [D2_samples.csv, reference_pins.csv]
2026-10-15 Add four-voice polyphony and separate keyboard event input
    Keep matrix scanning and key mapping in the replaceable input adapter. Feed note IDs and FCWs through valid/ready events to a keyboard-independent synth with four ADSR/DDS voices, 24-bit voice gain, a 40-bit mixer and 16-bit saturated output.
    Reuse inactive/released voices before stealing the oldest held voice. Ignore stale releases for stolen identities, preserve same-note retriggers, and retain diode-free matrix ghost protection. Keep pins, PLL/reset, U4 pull-down and amplifier startup behavior unchanged.
    Validation: 7,051,357 HDL checks passed, including physical four/five-key models, independent release, allocator overflow, sig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
    [D2_samples.csv]
2026-10-15 docs: 更新项目规划、阶段进度与中文更改说明
    - 在原README首页展示完整路线及四声部已通过的当前状态。
    - 明确32声部、多音色、效果器与扩展控制的后续目标和验收边界。
    - 补充历史版本中文索引，并记录后续提交使用中文的约定。
    - 验证文档链接、差异格式及源码哈希；仅改文档，未运行EDA或重复HDL仿真。
2026-10-15 docs: 每次成功更新后自动提交并同步GitHub
    - 记录用户持续授权，取代逐次提示才提交和推送的规则。
    - 保留中文提交说明、按变更范围验证及推送后核对。
    - 文档规则、链接和格式检查通过，功能源码哈希保持一致；未运行EDA。
2026-10-15 docs: 制定32声部共享调度方案与分阶段验收规划
    - 明确32份独立状态、共享ROM/增益与40位顺序混音方案。
    - 给出544/1280周期预算、渲染期回压及帧状态一致性要求。
    - 规划分配器验证、四声部等价、32声部集成及用户实板验收顺序。
    - 文档链接、预算、位宽、格式和源码哈希检查通过；当前RTL保持四声部，未运行EDA。
2026-10-16 test: 验证1至32声部分配与满额替换
    - 原分配器测试参数化，独立模型及1003276项检查全部通过。
    - 保存32声部开发基线和验证日志，生产RTL仍为四声部。
    - 记录用户实施授权；未运行综合、布局布线或烧录。
2026-10-16 feat: 共享波表与增益运算并完成四声部等价回归
    - 原DDS保留独立相位，共享ROM；原音源固定时隙调度，渲染期回压。
    - 原混音改40位顺序累加，最后声部参与同次截断饱和。
    - 六项HDL测试7130993检查通过，生产首码3.177ms；生产配置暂为4。
    - 保存数学参考、板级/物理键盘证据；未运行EDA，新通路待用户实板验收。
    [D2_samples.csv]
2026-10-16 feat: 完成32声部共享调度并通过完整HDL回归
    - 生产配置切换32，保持独立音符/相位/ADSR及共享ROM/增益/40位混音。
    - 满负载、第33音、旧松键、满幅、回压、复位、物理键盘和官方PLL回归通过。
    - 14344700项检查通过，实际交付517周期≤544，生产首码3.177ms。
    - 修正参数传递并保留原失败日志，同步构建声部记录和上板验收说明。
    - 未运行EDA或烧录，当前32版待用户资源/STA及实板验收。
    [D2_samples.csv]
2026-10-19 实现逐声部多音色与矩阵组合键切换
    - 保留正弦，新增笛管/簧管风格谐波预设，三组同步ROM保持原调度延迟。
    - 音色随valid/ready事件原子传递并保存在各声部，持音和尾音不随选择改变。
    - 左上角与右下角组合键循环切换，完全释放后重新允许切换。
    - 23项纯HDL测试通过，共8193676次检查；32声部混合音色逐样本参考通过，交付仍为517周期。
    - 修正IncludePath为工程相对路径，补充操作说明和当前底噪/时序状态。
    - 未运行Gowin综合/P&R或烧录；未重跑官方PLL模型或引脚测试。既有严重时序违例未宣称修复，新音色待实板试听。
    [dds_sine.sv, key_note_events.sv, keyboard_core.sv, keyboard_top.sv, synth_core.sv, tb_dds_sine.sv, tb_key_note_events.sv]
2026-10-19 fix: 降低音频串行输出驱动作时钟干扰对照
    用户确认松键左声道尖峰与BCK边沿固定对应，探头尖端接GND时基本消失，重新打开底噪排查。
    原CST中三路DAC串行及三路调试镜像驱动由8降为4 mA；保持球位、RTL、PLL、PA、增益和静音策略。
    音频时钟、PT8211串行及官方PLL板级HDL仿真通过；核对六路属性差异、其他源码哈希和工程依赖，独立保存日志。
    HDL不能验证驱动电气或降噪效果。等待用户重新综合、布局布线、烧录与相同条件下实测，不宣称底噪已修复。
2026-10-19 docs: 校正并行合并验证的提交范围记录
    - 24项HDL测试全部通过，共9386744次检查；综合、布局布线、烧录及模拟底噪仍未验证。
    - 合并提交期间另一会话暂存的三份底噪说明被一并保留在c021de9中，修正验证记录对此范围的描述；未改动这些文件内容。
    - 本次只提交验证记录，其他会话暂存的文件保持原状。
2026-10-19 docs: 核对并行合并后的底噪对照交付记录
    确认c021de9已保留六路4 mA约束和多音色更新，记录并行集成的事件TB声明顺序调整及最终源码哈希。
    核对23项RTL及官方PLL板级共9386744次检查通过，不与本轮针对性1749712次重复累计；原日志与阶段证据保留。
    补充最终交付索引，区分先前未暂存状态和合并后状态，清理README末尾空行。
    没有新增功能或EDA操作；既有Setup时序问题及模拟降噪仍未验收。
2026-10-19 fix: 重构多音色声部分配路径并补测普通双键爆音
    - 根据下载副本真实STA中的180级、181.520ns分配器路径，将原voice_allocator改为逐拍读取/比较、注册目标和年龄后握手提交，帧边界及停用可安全重试。
    - 音符身份、FCW与音色保持原子，保持32声部、三种波表、原键盘分离、替换策略、GPIO/PLL/PA/增益及4mA驱动对照。
    - 原测试增加1/3/4/17/32声部、搜索打断、三音色单键/普通双键瞬态幅度、独立松键与板级物理双键；修正满幅刺激对组合CE瞬态的误计数，保留失败证据。
    - 最终29个配置共21228787次检查通过，32声部517周期交付，首码3.1769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
    [D2_samples.csv]
2026-10-19 docs: 记录多音色模块列表未刷新与配置回退处理
    - 记录用户EX3937错误：磁盘主工程已含timbre_control，而IDE实际解析仍使用旧20个HDL文件。
    - 补充重新打开原工程、添加现有源码以及防止旧工程覆盖文件列表的处理方法。
    - 本次操作恢复IDE自动退回的IncludePath至既有src与src/config配置，其他设置一致；恢复后配置与上一提交字节相同，无额外配置差异。
    - 21个HDL、30个工程依赖及4901d8f验证源码哈希检查通过；未运行EDA或烧录，不宣称高云重编译及实板通过。
2026-10-19 加入可切换的150毫秒延迟效果器
    - 混音后新增7200点16位环形延时线，单次回声采用3/4原声与1/4延迟声。
    - 右上角与左下角组合开关，默认关闭；64采样平滑过渡，原音色切换保持。
    - 同步RAM分周期读写，填充计数屏蔽复位前旧数据，关闭效果后稳态原声逐样本一致。
    - 25项纯HDL测试通过，共17812730次检查；生产7200点脉冲/复位、32声部多音色加效果串行参考通过。
    - 保留已修复的分配器、CST/SDC及功放设置，新增操作说明和独立验证记录。
    - 未运行Gowin综合/P&R/烧录；新资源、时序和回声音质待用户验证。不含混响、合唱或底噪处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
    [audio_delay.sv, keyboard_top.sv, synth_core.sv, tb_audio_delay.sv, tb_effects_integration.sv, tb_keyboard_core.sv, tb_keyboard_latency.sv, tb_multitimbral.sv]
2026-10-19 feat: 加入小星星一次自动演奏并恢复键盘
    - 新增独立曲谱事件源与42音符谱例，默认120BPM上电播放一次，笛管旋律加正弦三音和弦，约24秒。
    - 顶层等待全部松键事件及尾音后恢复键盘，播放期间按住的键可在交接后识别；USR复位重播，SCORE_ENABLE=0保留原手动模式。
    - 保持原音源、32声部、分配策略、CST/SDC、PLL、PA和增益；更新原工程为22个HDL、32项依赖，仿真及构建证据入口同步。
    - 30个配置共17323372次检查通过，含生产节拍/尾音、回压/复位/禁用、官方PLL顶层逐样本参考及键盘交接，原手动和引脚映射回归通过。
    - 未执行EDA或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
    [D2_samples.csv]
2026-10-19 refactor: 独立文件曲谱播放器并支持文本转谱
    原位重构 score_player 为同步 ROM 事件播放器，通过 SCORE_FILE/SCORE_WORDS 选择琴谱；顶层只负责键盘与播放器事件源交接。
    将旧硬编码小星星迁移为可编辑文本和生成的 hex，增加离线转换器、中文格式/换谱说明；支持显式音高、音色、和弦、休止与结束，不调用 EDA。
    35 个 HDL 配置共 17,327,941 次检查通过，另有 6 项谱转换器测试；覆盖生产节拍、替换谱、回压、复位、故障与原键盘/音频/引脚回归。
    音源、包络、增益和约束保持；本次不是音质修复。新结构的资源、STA、综合/P&R/烧录与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
    [D2_samples.csv]
2026-10-20 fix: 对齐自动曲谱与键盘的音色和换音行为
    默认小星星改为正弦单旋律，以MIDI音高作为身份；保留42音及原音高节奏，移除默认同音区伴奏便于与键盘单键对照。
    不同音高分配独立声部并从零幅起音，旧尾音保持原频率自然释放；重复同音保持键盘相位和包络重触发语义。通用文件播放器仍支持复音和多音色。
    新增生产参数换音组件验证，覆盖C4重复、G4独立起音及232004次DDS采样；5个HDL配置共7038771次检查与7项转换器测试通过，保留初次测试竞态失败记录。
    31项工程依赖保持，包含全部原RTL、音源、包络、增益、PLL和约束。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
    [tb_score_articulation.sv, tb_score_audio.sv, tb_score_player.sv]
2026-10-21 功能：使用底板四个独立按钮选择音色和回声
    核对官方Dock 4071f3原理图第15页，物理S0/S1/S2/S3对应K16/F15/G15/G16，均3.3V上拉、低有效；按物理S编号映射，区分通用CST中交换的key[1]/key[2]别名。
    原timbre_control改为独立四路两级同步和10ms按下/释放消抖，S0/S1/S2直接选择正弦/笛管类/簧管类，S3单次切换回声。移除矩阵对角控制，按钮不产生音符、不改持音音色；S3自动曲谱期间可用，曲谱自身音色保持。补充顶层、四路输入约束、引脚记录、操作说明及相关测试。
    6个HDL配置共8,914,219次检查通过，含正式614400周期消抖、完整84事件曲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
    [reference_pins.csv]
2026-10-22 docs: 补充RGB屏显示新窗口交接
    新增2026-10-22交接文档，整理当前音频与文件播放器基线、验证边界、操作分工、Git同步、已用引脚和本地参考资料。
    明确屏幕型号/接口/电气/时序待确认，提供独立显示、状态跨域与最小点亮顺序，并附新窗口可复制提示。
    补README和AGENTS入口；链接和22个HDL/33项依赖核对通过，全部src文件未变。保留原有IDE配置改动，不运行HDL、综合/P&R或烧录。
2026-10-22 docs: 明确本地RGB交接范围与800x480屏接口
    按用户最新澄清，本窗口仅输出交接文档，不实现UI；屏幕已确定800×480及底板自带40P FPC，型号、逐针定义、电气和时序待新窗口确认。
    用户要求先不要合入新分支；此前尚未提交的远端合并已撤销，功能源码和GPRJ仍与本地f285506一致。保留原有IDE配置，不合入远端回声/独立按键，不为推送自动合并或覆盖main。
    更新原交接文档、README和AGENTS入口，链接与源码/工程/配置一致性检查通过；未运行HDL、EDA或烧录。本次仅本地提交。
2026-10-22 docs: 记录用户已核对RGB屏示例CST引脚
2026-10-22 feat: 增加800x480 RGB屏状态UI渲染与仿真
    新增独立像素域UI、帧边界状态锁存和彩条，加入原GPRJ但尚未接入生产顶层。按用户指定CST核对22个LCD球位无冲突，保留原音频、键盘、播放器和IDE已有改动。
    验证：UI整帧与官方PLL顶层回归共3,983,787检查通过，无配置搜索路径预处理及文档链接检查通过；保存RTL仿真预览和证据。屏幕手册、像素时钟/时序、状态CDC与实板验收待补，未执行EDA，不合并远端也不推送main。
2026-10-22 feat: 接入GT9110触摸读取与RGB状态显示
    按用户指定N18/N26/R16/R17接入开漏触摸接口，实现复位选址、100kbit/s寄存器读取、首点坐标及数量、松手、NACK/拉伸/超时恢复。仅清除已读状态，不写校准配置，不绑定音色或音量控制；UI新增触摸状态、原始坐标与十字。
    新增独立像素PLL、扫描和原子快照，使用Sipeed官方Pro的35MHz DE-only参考配置试亮，保留原音频/键盘/播放器及两个音频PLL。28个HDL/39依赖、50端口无冲突，原24端口属性保留。
    验证：13配置26,255,687检查通过，覆盖生产I2C计数、完整76ms启动、触摸故障恢复、整帧显示/CDC和音频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
2026-10-22 fix: 修正Gowin显示时序约束的条件语法与节点名
    删除keyboard.sdc中当前Gowin解析器拒绝的if/llength条件块，改为直接约束命令。按用户已有综合网表确认generate实例名lcd_on.display_driver，修正像素PLL路径；各时钟比例、延迟预算及其余约束不变。
    验证：14条平面约束命令、括号结构、命令差异与已有网表节点核对通过；不修改RTL/CST，不重跑无关HDL仿真。保留用户TA2000失败证据，说明LCD_ENABLE=0时需同步去除像素约束。助手未运行Gowin/EDA，解析与新STA仍待用户重新实现确认；本地提交，不合并或推送远端。
2026-10-22 fix: 释放触摸接口占用的CPU与SSPI复用管脚
    依据用户PR2028/PR2017日志和官方复用设置，启用Use CPU as regular IO与Use SSPI as regular IO。原工程CPU/SSPI配置改为true，原编译Tcl补显式GPIO复用选项；保持N18/N26/R16/R17接线、JTAG/MSPI、RTL及全部约束。
    验证JSON只改两字段且保留工作区其他设置字节，Tcl有效命令只新增两项，核对已有封装引脚报告和官方文档。配置提交仅纳入CPU/SSPI两字段，原IncludePath/换行改动仍留工作区。未执行EDA或烧录，新布局/STA需用户重跑；确认IDE两个regular IO勾选防止旧页面写回。仅本地提交，不合并或推送远端。
2026-10-22 fix: 将触摸信号迁移至扩展排针并纠正供电接法
    按用户新接线设置SCL=AB26、SDA=U25、INT=V23、RST=R23，同步约束、构建核对和文档，撤销旧CPU/SSPI复用设置。P25/T25为信号IO，未添加供电输出，记录真实电源接线要求。
    静态核对50个端口无重复，只有四个IO_LOC变更，端口电气属性及RTL/SDC保持；构建Python语法及官方示例、已有封装报告核对通过。未执行EDA或实板验证，不合并远端、不推送main。
2026-10-22 fix: 默认关闭触摸模块
    将TOUCH_ENABLE默认值设为0，使SCL、SDA、INT和RST保持高阻；保留触摸RTL、引脚约束与重新启用入口，并同步说明文档。
    Icarus顶层编译通过；完整顶层仿真运行过久后停止，未执行Gowin综合、布局布线或烧录。
    [keyboard_top.sv]
2026-10-22 功能：扩展房间混响和颤音并平滑切换效果
    基于main建立独立音频工作分支，保留150ms回声，新增四路归一化反馈梳状房间混响与约5Hz音量颤音。混音后单选处理，256采样旁路渐变，类型切换先淡出至原声再淡入，负反馈量化向零取整防止残留循环，所有RAM按填充计数屏蔽复位旧数据。
    S0/S1/S2继续直接选音色；S3短按稳定松开开关当前效果，长按约0.8秒单次循环回声/房间/颤音并开启，长按松开不再执行短按。公开同音频域mode接口供后续UI整合，本轮不做运行时参数菜单或矩阵菜单，不改显示触摸分支和现有引脚。
    12个HDL配置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
2026-10-22 功能：增加效果器运行时参数接口与UI对接约定
    新增音频域四参数原子提交与确认：回声/混响强度、音量颤动深度0..256，速度1..10Hz。强度与深度按采样一步平滑，速度变化保持相位；参数写入不影响处理中样本，默认数值逐样本兼容已试听版本。synth_core公开配置入口，独立顶层固定valid为0，尚未接入UI/矩阵菜单/CDC或按钮仲裁，不增加管脚，不改PLL、约束、音源与功放。
    补充杨金鹏UI协作接口说明，约定百分比、默认值、全量快照、握手及未来跨域/状态协调。记录用户对4fdedfb三效果版试听成功反馈；本次运行时版本仍待新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
2026-10-23 修复：改写效果强度限幅以兼容高云数字词法解析
    用户综合截图在audio_effects.sv第27行报EX3132/EX3863，紧邻十进制常量的问号被错误解析。将原紧凑三目式改为等价if/else，保留0..256限幅语义及全部效果算法、UI和引脚。
    针对运行时参数的缩短延迟与生产延迟两项HDL测试通过，共524828次检查。证据reports/instrument_ui/2026-10-23/gowin_syntax。未运行Gowin综合/P&R/STA或实板测试，待用户重试。仅更新feature/instrument-ui。
2026-10-23 feat: 将音频输出迁移为外接MAX98357A的I2S接口
    原PT8211串行器及测试原位重命名并改为标准I2S：48kHz、16位双声道、LRCLK低左高右、新MSB延后一位，完整保留跨帧右声道最低位与立体声原子性。
    顶层新增MAX_BCLK/MAX_LRCLK/MAX_DIN/MAX_SD_MODE；旧板载DAC、功放及调试镜像固定低。SD_MODE先使能，在生产静音期间预留9979.141微秒器件开机时间。音源、32声部、播放器、RGB和默认关闭的触摸保持。
    按用户要求CST/SDC未改，新外接端口尚不配置球位、电平与时序。构建脚本在任何gw_sh调用前检查MAX映射，避免未知管脚自动放置；本轮未执行该脚本或EDA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
    [D2_samples.csv]
2026-10-23 fix: 按指定排针配置MAX98357A功放接口
    BCLK=V22、LRC=W19、DIN=Y20、SD=V26，原CST设为3.3V/4mA，原SDC将0..30ns音频路线预算转到MAX端口。
    54个端口无重复球位，原有引脚/音源/键盘/RGB/触摸配置保持；补充接线说明与独立验证报告。
    I2S与官方PLL启动两项HDL仿真共1856631次检查通过，SD至音频准入9979.141us。未运行综合、P&R或烧录，新STA和实测待用户完成。
    [keyboard_top.sv]
2026-10-23 功能：英伦双页界面与七音色实时演奏可视化
    按王开册选择的英伦风格实现黑金英文演奏/参数页，标题High Mountains, Flowing Water；共享64Kbit同步字形/标题ROM和两级像素管线。新增实际后效果器PCM波形、全窗峰值与按住MIDI60..75监视；128点/每4样本抽取，10.667ms，X8只放大视图，不改音频增益。1112位状态经原子CDC逐帧发布，不阻塞音频。
    新增CELLO大提琴、PIANO钢琴、GUITAR木吉他、VIBRAPHONE颤音琴合成近似；全链路音色扩3位、四个归一化谐波表与不同起音/衰减/释放。旧三表、默认小星星hex保持，旧ADSR参数路径回归；可选seed处理同ID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
2026-10-23 新增四主题界面与隐藏彩蛋，保留演奏和效果状态
    默认英伦花体星图，新增原视频小猫/卡皮巴拉16帧背景；S1上一、S2下一、触屏THEME切主题，长按S3独立进入/返回脚部缩放彩蛋，短按仍开关效果。中英文切换及主音量暂不实施。
    22项纯HDL配置、34368603检查通过；双音源逐位I2S/PCM一致，四主题双页整帧、长按一次/返回、触摸命中及脚部局部动画通过。引脚/PLL/音频算法/触摸驱动不变，生产触摸默认启用。附素材ROM、字体许可、预览和验证记录。
    未运行Gowin、P&R、STA或下载。新增ROM资源推断、像素/音频时序及动画听感仍须用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
2026-10-24 文档：标记蓝牙整合分支与基准版本
2026-10-24 发布：蓝牙单声部曲谱与安卓连接可用版本
    以 bf5df5792f654ee9c29a30983cdbe83a0061669e 为基准，保留英伦 UI、七音色、触摸和 MAX98357A，加入 EC05 UART v1 下载播放、CDC、设置音量、矩阵采样修正及相关回归。
    安卓 0.2 分开验证模块连接和 HELLO，附开发 APK、小星星 MIDI、协议文档、测试证据及后续八阶段规划。上电/USR 默认静音，不再自动播放小星星。
    用户已确认连接、通信、MIDI 下载播放、暂停和停止正常。发布前协议/串口复核 10886 项、Java 核心及连接状态 36075 项通过；最新上电静音已有 5176107 项 HDL 回归，核对顶层哈希一致。未运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
    [SimulatedDevice.java, bluetooth_audio_bridge.sv, bluetooth_score_core.sv, bluetooth_score_link.sv, bt_event_cdc.sv, bt_frame_rx.sv, bt_frame_tx.sv, bt_score_player.sv]
2026-10-25 修正矩阵跨列误识别与彩蛋人物构图
    仅在四主题main上修正：同列稳定早采样及槽尾采样都为低才接受，防止慢回升行信号跨列产生假按键；保留原消抖和完整Note Off/尾音链路，不加定时强制截音。慢回升模型先复现旧版失败，再通过16键/七音色真实矩阵到PCM/I2S归零回归。
    彩蛋去除原图字幕与背景，完整保留人物和前景脚；演奏页左侧独立展示，实时波形/电平/16音符移到右侧，设置页命中区域保持。脚部缩放带安全边距、面部抱臂固定；源图只读，派生素材、提示词和预览已保存，ROM容量不增加。
    18项纯HDL配置共19168585检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
    [rgb_ui_renderer.sv, tb_egg_composition.sv, tb_matrix_settling.sv, tb_release_pcm.sv, tb_theme_art.sv, tb_theme_pixels.sv, ui_theme_art.sv]
2026-10-25 将东北雨姐彩蛋改为完整静态图片
    按用户最新要求取消彩蛋动图，直接使用上一轮已去字幕、同时保留人物与脚的同一素材。200×150 RGB565整图单端口同步ROM，单像素一行HEX；去掉脚部蒙版、第二读口、变形地址、旧调色板与彩蛋动画计时器。人物、脚与构图均固定，S3长按进入/返回保持，小猫和卡皮巴拉仍为原动画。
    11项纯HDL配置共13371724检查通过：全图跨动画索引逐像素不变，人物衣服与脚部独立内容检查，120帧事件静态状态不推进；彩蛋完整800×480的RGB666输出包含面部、粉色衣服和脚部；回归松键归零、其他界面及主题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
2026-10-25 发布：蓝牙多声部曲库开发版与小星星及编译产物
    以bf5df5792f654ee9c29a30983cdbe83a0061669e为基准，保留8081710可用检查点；仅更新codex/bluetooth-score-integration，不合入main。
    接入16自动声部/4096条RAM、32首U7持久曲库、共享校验、本地控制、扩展协议、App0.3及设置more字符入口，保留原UI/七音色/三效果器/音量，上电与USR不自动播放。附82秒362条小星星1/4/8/16声部演示及生成/验证资料。
    按用户要求归档11:27已有.fs/.bin/.binx编译输出压缩包、逐文件SHA256及综合/P&R/STA报告；保留用户当前自动增量P&R设置。未重新运行EDA、下载或烧录。
    验证：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
2026-10-25 拆分显示长路径并修正FX关闭状态保持
    根据用户12:20时序报告进行首轮RTL结构修正：效果类型选择只改变类型，保留FX开关；八级像素流水分离布局、坐标、字符、ROM与混色，缩窄除法和颜色运算并缓存数值排版；音频可视化改固定片选写入、持音监视译码分级；1112位显示及71位触摸快照消费者改本域异步断言/同步释放复位。
    18项纯HDL配置共20053629检查通过；八个800×480页面3072000像素与14a693c基线完全一致；完整84事件曲谱保留517周期交付；三次USR重启126次起音/126次松音及手动按键释放归零；完整RGB666输出含静态雨姐人物与脚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
2026-10-25 无损压缩主题ROM并继续优化时序与LCD输出约束
    用户确认b07c0d5实板功能正常，但18:06报告仍有388个Setup违例，P&R耗时1h8m51s。针对新路径：提前预测并寄存生产frame_ce、分段预测锁定计数进位/终值；像素坐标输入寄存、背景比较后移，renderer九级加连接器一级寄存，保持异步丢锁消隐和原画面。
    两段16帧往返动画无损复用9张唯一帧并隐含透明边缘，原16帧/10fps/全部颜色与坐标保持；全套主题/字库逻辑数据3747584→1955368位，节省1792216位。新增生成头文件随HEX进入GPRJ，须完整更新工程。
    更正旧LCD绝对6ns预算包含时钟插入延迟的问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
2026-10-25 增加主题配套中英文切换并精简板载按键
    基于压缩和时序优化后的main 60c9deb：屏幕增加中文／ENGLISH按钮，两页四主题通用；标题、七音色、效果参数及状态提示本地化，RESET译为恢复。保留原英文花体与星图，新增毛笔／清雅／可爱三套89字中文子集和抗锯齿标题。语言复用1112位快照空位56，帧边界更新；保留九级渲染加一级连接器。中文模式音符监视继续使用窄ASCII格，避免截断C4等标记。
    S0/S1/S2短长按全部停用且不阻塞触摸；S3仅长按进入／退出彩蛋，取消短按FX。屏幕设置／主题／FX及矩阵菜单保留。语言不改音色、参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
    [keyboard_top.sv, rgb_display.sv, rgb_ui_renderer.sv, tb_british_top.sv, tb_keyboard_top.sv]
2026-10-26 实现2048点实时频谱与单声道延迟XY并保存恢复检查点
    基于main7e0aaec。新增Hann窗定点FFT/64频带、分拍幅度转换、513位独立原子CDC；像素域64×64双缓冲Bresenham位图。视图按钮循环波形/频谱/李萨如，保留四主题/中英文和原十拍输出，三套105汉字仍占32768×16字库。S0/S1/S2停用、S3仅长按彩蛋；不改音源/ADSR/效果、引脚/PLL或合并蓝牙/超声波。
    已重跑FFT8窗口独立NumPy对照（最大分量误差8.003LSB以内，32独立频点验证）、完整XY/Pillow位图、视图/触摸、513位CDC、波形原模块等单元检查。完整音源与界面回归正在进行，此提交仅保存可恢复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
2026-10-26 验证并发布实时频谱与李萨如显示
    屏幕新增VIEW／视图按钮，循环波形、2048点Hann窗定点FFT的64频带频谱、真实PCM与延迟16采样构成的单声道XY。低频细分、高频合并，幅度为相对对数L1近似，不冒充校准仪器或独立立体声。保留四主题、中英文、完整静态人物与脚、音符/电平及原九级渲染加一级连接器。S0/S1/S2仍停用、S3仅长按彩蛋；蓝牙和超声波未合并。
    15项纯HDL回归共23227101检查通过；NumPy独立FFT8帧16936项核对，最大实/虚分量误差8.003归一化PCM LSB以内、验证32个不同FFT峰；Pillow完整XY位图32776检查；六个完整界面4608399检查。F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
2026-10-26 修正频谱FFT双端口RAM模式以处理PA2122
    根据用户实际布局布线截图，将实部和虚部RAM从无条件读写的read-before-write表达改为独立端口写或读，写周期保持读取输出，意图推断当前器件支持的normal模式。保留RAM容量、算法、状态周期、ROM、音源、UI与所有约束，不改生成网表。
    Icarus修正模块1295379检查通过，原模块747539检查通过；8组共8704行FFT实虚分量和频谱柱修改前后逐字节一致，每帧93439周期。独立NumPy16936检查通过，最大误差8.003 LSB以内。新增端口保持、实际写值和双写地址测试，证据位于reports/fft_ram_compatibility/2026-10-26。
    未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
    [audio_spectrum.sv, tb_audio_spectrum.sv]
2026-10-27 实现双MAX98357A立体声并修复蓝牙身份复用尾音串音
    严格基于codex/bluetooth-score-integration的2d86834。生产顶层默认左右独立混音、效果历史与音量，按音区固定声像，现有I²S输出左右16位PCM；两块MAX98357A须分别配置SD/MODE选择L/R。保留单英伦界面、触摸、蓝牙协议/App/Flash曲库、上电静音待机、32物理/16自动声部，不合并main或超声波，不新增GPIO或修改CST/SDC/PLL。
    原RTL已复现：自动ID0的C4释放未完即被新G4复用，旧尾音频率和力度被覆盖。现自动ID只匹配held/pending所有者，释放尾音保持，新音分配独立物理声部；力度和音高元数据按物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
2026-10-27 整合：合并蓝牙曲库与音频限幅及超声波控制
    以蓝牙曲谱版本地修订为基础，保留16自动声部、4096条RAM、U7曲库、独立尾音力度及较新的时序结构；合入24倍补偿、64采样前瞻限幅、LAT数字延迟与超声波控音量。解决P21引脚与菜单动作编号冲突，修正曲库页遮挡，补齐独立身份测试输入。
    验证：35项HDL配置共29991981次检查通过，独立输出模型9188项检查通过，安卓核心软件36108项检查通过；项目75项依赖、67个引脚无重复，两个来源工程哈希保持原样。
    本次仅提交合并源码、工程配置、文档与验证证据，不包含新的FPGA编译产物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
    [adsr_envelope.sv, audio_latency_meter.sv, audio_limiter.sv, audio_visualizer.sv, bluetooth_audio_bridge.sv, bluetooth_score_core.sv, bt_identity_monitor.sv, bt_score_player.sv]
2026-10-28 Integrate touch keyboards and fix Flash, polyphonic audio, and timing
    Replace the matrix input with three AiP5916 boards and port the three EC11 controls. Preserve stereo output, 32 physical voices, 16 automatic identities, 73 pins, and the 50/61.44/35MHz clocks. Unify Flash array-write permission checks and include the diagnostic APK.
    Pipeline limiter/context/display work and distribute sample/reset/timer controls. Add a 240-sample limiter recovery hold while retaining single-note level and the measured 1.37ms digital latency.
    Include the matching attempt5 burn file, netlist, constraints, STA/SDF, hashes, and validation evidence. Setup/hold/recovery/removal/pulse checks pass and TNS=0; in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
    [audio_trace.csv]
2026-10-29 保存PCB与Flash调试检查点及W23旋钮接线
    加入三板运行时灵敏度配置、独立通信/数据有效诊断、双遍逐键确认及静音PCB专项页，关闭AUX快捷控制并保留板载按键作用。颤音SW从W25改为W23。
    移植Flash探测刷新、写入读回和probe_error传递，诊断App0.3.3保留180秒任务等待与RAM/持久保存分阶段提示；修复蓝牙软复位后效果恢复请求被吞掉的问题。附APK、操作及逐字段说明。
    验证：当前源码9项PCB/UI/旋钮与3项Flash回归全部通过，源文件哈希匹配；生产1MHz完整4096曲谱保存-复位-载入仿真的14文件依赖仍匹配；原工程3941文件哈希未改变，73引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
    [aip5916_keyboard.sv, ec11_encoder.sv, flash_song_library.sv, gt9110_touch.sv, i2c_register_master.sv]
2026-10-29 修复快速连击延音并更新PCB设置界面，附匹配位流
    将第一效果替换为20～2000ms逐声部松键延音，保留快速同键重按前的释放尾音；颤音扩展至20Hz，PCB默认页改为文字/十进制并支持按住调参。
    保留板载按键作用、73个引脚及50/61.44/35MHz时钟；颤音A/B/SW为T23/R25/W23。52项配置回归及源码哈希核对通过，原工程保持不变。
    附同次全新构建的FS、VG、约束、报告、压缩SDF及诊断APK和WAV对照。实际STA有639个Setup违例、0个Hold违例；用户取消时序收敛，本版不标为时序通过。未烧录或实板试听。
    [audio_effects.sv, keyboard_top.sv, rgb_display.sv, rgb_ui_renderer.sv, sustain_envelope.sv, synth_core.sv]
2026-10-29 实现蓝牙MIDI多音色、基础鼓组与兼容曲库
    基于a8f38e0加入16种旋律音色、10种合成鼓音和MIDI21～108音域；手机转换Program Change、CC64及起音CC7/11，提供原谱/统一音色和排除鼓轨。
    保留8字节协议，新增能力协商和12字节记录；96位RAM、29位原子事件、逐声部5位音色及暂停恢复，Flash目录兼容和断电事务升级；手动菜单两页16音色。保留原七表、2秒松键延音、20Hz颤音、PCB页面及73引脚。
    44项HDL配置、36258项Java检查通过，附签名开发APK、原创MIDI、源码哈希和验证报告。满容量4096条使用HALF=4加速SPI模型，生产1MHz使用24条跨页配置；不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
2026-10-30 Add touch konghou, manual pitch bend and stereo chorus
    Create a dedicated performance page with twelve pentatonic strings, ordered sweep events, release handling and a phase-continuous +/-2-semitone manual bend. Add fractional modulated-delay chorus with independent stereo phases, smooth mix/depth and persistent controls. Preserve existing board controls, Bluetooth/MIDI, pins, clocks, limiter and volume.
    19 frozen-source HDL configurations passed (11,734,957 checks), with 24,000 independent chorus vectors and 3,644 independent full32voice chain values. New effect delivery peaks at535 cycles within the544cycle budget. Includes RTL-rendered previews, hashes and bring-up instructions. Real key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
2026-10-30 Add per-key mapping and performance MIDI recording
    Add atomic 36-key pitch/timbre maps with dual-sector Flash persistence, a 4096-note/one-hour RAM performance recorder, compatible V1 Bluetooth commands, phone/LCD controls, resumable download and SMF1 multiport export/import.
    Preserve existing audio, song slots, board controls, clocks and 73 pins. Validate 41 HDL configurations and 40,434 Java checks; stereo delivery remains 532/544 cycles. Include APK 0.5, protocol guide, demo MIDI and source hashes. No EDA, STA, hardware programming or phone/radio validation.
2026-10-30 Fix recorder RAM inference after IF0008
    Move all recorder memory access out of the asynchronous-reset controller. Merge onset/release/finalization writes into a single synchronous write port and CRC/download reads into a single synchronous read port; request Gowin block_ram mapping.
    Preserve 4096x96-bit capacity and protocol/read latency. Add reset-retention/stale-record isolation checks. Recorder 12,556 checks and integrated top 70 checks pass. No vendor synthesis, resource measurement, STA or programming performed.
2026-10-31 优化诊断页面：共享逐拍BCD转换并减少格式化寄存器
    复用25项十进制转换，保留完整页面发布；结果以20位BCD保存，decimal2改有界比较减法。附静态展开和151073+32项参考检查。未运行RTL动态仿真、Gowin综合/P&R/STA，实际资源与耗时改善待测。
2026-10-31 拆分限幅器输入预增益与幅值路径
    利用原WAIT_RAM拍初始化peak，不增加状态或改变RAM访问次序。静态展开及2097152项幅值算法参考检查通过；未完成RTL动态仿真和Gowin综合/P&R/STA，实际时序改善待验证。
2026-10-31 记录限幅器优化综合结果与布线失败证据
2026-10-31 减少诊断显示快照重复整页门控并记录实现结果
    综合LUT减少4711。实际P&R仍PR0004失败，4300条未布通网络，CLS仍90%；未完成RTL动态回归和时序验收。
2026-10-31 允许CDC载荷常量裁剪，保留控制同步器属性
    综合减少2574寄存器和4132 LUT。P&R在Routing Phase 0之后按检查点主动终止，无最终时序或布通结论。
2026-10-31 合并显示帧快照并减少包络重复算术和控制集合
    生产显示直接使用帧边界CDC快照，减少3255 FF；波形采集控制集131降至4，宽载荷移除6189 FF异步复位负载。显示采样年龄最多额外一帧，音频数值/拍数不变。
    附可复现HDL测试和完整slew等价证明，组合综合LUT78932/FF49398/ALU11082。新增显式routability物理profile；当前P&R运行中，尚无布通或STA通过结论，不提供合格新位流。
2026-10-31 归档物理试验结果并修正构建profile及测试布局
    优先布通profile18分58秒后6488网络未布通、CLS88%；同网表原profile按75分钟窗口主动停止，无最终布通/STA结论。修正gw_sh持久化profile及W23引脚期望，新增夹具移至sim/structural以保持旧测试发现行为。未生成合格新位流或烧录硬件；保留下一轮未应用候选。
2026-11-01 共享32声部包络准备并缩短协议和延音关键路径
    ADSR商/余数由一条流水线轮询，保持原采样更新和逐声部结果；延音进位提前至空闲拍，滑音按合法距离缩位，蓝牙8/12字节长度检查去掉可变除法器。保留显示valid/DE与PCB保护并去重复宽门控，顶层声明兼容Icarus，PNR阶段只验证不自动包装。
    分阶段约3406万次HDL检查，完整音源限幅开/关各300帧逐拍一致，实际顶层官方库编译及触屏演奏集成通过。共享阶段LUT75288、寄存器49040、MULTALU27X18/MULT12X12各减少62个；最终组合综合和物理验证仍在进行，不宣称时序闭合或已达到两小时，未烧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
2026-11-01 限制DATA包计数位宽并记录中间时序回退
    incoming_count只在EXECUTE通过范围/对齐拒绝后使用，因此以8位载荷长度替代隐式32位除法。全部52种合法记录计数等价，131072种长度/格式对齐判定及旧/新协议回归通过；最终顶层编译和触屏演奏测试通过。归档组合综合参考36.836MHz的回退及定位依据，当前bounded_syn继续验证，尚未宣称布通、STA或新位流合格。
2026-11-01 归档结构优化最终综合与受时限中断的物理验证
    最终LUT75522/FF49071/ALU10640，DSP原语90/29；音频综合估算59.049MHz仍低于61.44MHz。物理运行31分钟，布局及布线阶段1完成，按75分钟优化窗口收尾停止，未获得最终未布通数量或STA，不声明两小时内布通或合格位流。冻结源、网表、约束和构建输入哈希核验通过，31项修改文件与远端生产提交一致；保留分阶段动态验证及未应用候选说明。
2026-11-01 记录无时限布线收敛任务与隔离候选验证
    取消旧75分钟时限；基准和候选物理实现均在继续，生产RTL保持冻结。记录限幅器换算/释放缩位、诊断页私有载荷对照及两轮综合，尚不声明布通或STA通过。
2026-11-01 整合限幅器与PCB缓存减负补丁，保留最新收敛记录
    限幅器以整数部分及负小数修正保持向零取整，去除宽绝对值和二次取负链；PCB私有行缓存移出异步复位进程，对外发布及控制复位保持。补齐旧限幅测试的命名端口连接，加入冻结参考、专项回归及形式证明脚本。
    验证：9项专项配置共2,020,649次检查通过，Z3证明覆盖全部合法乘积范围；Yosys通用结构减少2240个PCB异步复位负载，不代表高云实际资源或提速。整合前核对55b5bb2仅新增文档/检查点，保留全部新记录，测试依赖哈希仍一致。
    未运行本次Gowin综合/P&R/STA、未生成匹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
    [audio_limiter.sv, reference_audio_limiter_c6352fa.sv, tb_audio_limiter.sv]
2026-11-01 合并已验证限幅与共享包络分拍并保存49分钟布通基线
    保留b065e652的独立回归、形式证明和命名端口修正，将脚本适配Windows并在本合并源重跑9项2020649检查通过。限幅采用已验证全42位行为的整数幅值分拆，再缩位释放和诊断页私有捕获载荷，包络声部mux分拍；三域综合55.355/42.824/63.002MHz。49m1s旧冻结输入完整布通0未路由，但音频534setup违例，不宣称合格位流。继续独立物理及DDS时序验证，阶段证据均与实际源/网表对应。
2026-11-01 Pipeline measured timing paths and narrow limiter storage; preserve exact audio and I2C behavior
    Add DDS context preparation, local envelope command enables, gain-sample staging, mute terminal prediction, fixed AiP readback destinations, and coordinate fanout control. Record completed 28m37s routed run with128 setup violations and freeze current default physical inputs. Current physical acceptance remains pending; no qualified bitstream is claimed.
    Include reproducible DDS/34-configuration limiter/I2C trace checks and current full-core, top, vendor compile, and merged runtime evidence.
    [aip5916_keyboard.sv, audio_limiter.sv, dds_sine.sv, reference_dds_sine_c6352fa.sv, rgb_display.sv, synth_core.sv, voice_allocator.sv]
2026-11-01 Archive optimization state at user's stop request
    Preserve latest RTL400d376 unchanged. Record latest physical run as interrupted by user, and DDS default run as best completed measured result (28m37s, zero unrouted,128 setup violations). No qualified bitstream is available.
2026-11-01 Archive best measured DDS implementation and matching programming-file evidence
    Restore exact114 source/ROM/project/constraint/build inputs of dds_default. Completed P&R28m37s, zero unrouted nets,128 setup and0 hold violations; timing is not qualified. Preserve the later performance candidate on its original branch. Include full timing/resource/pin logs, input manifests and bitstream SHA256. No optimization, new EDA run or hardware programming.
2026-11-02 Add W25 input marker, correct ultrasound cm units and extend compatible MIDI percussion
    Preserve board-tested baseline. Functional tests and synthesis recorded; full PNR pending external power. XY core retained after independent checks.
    [key_input_probe.sv, keyboard_top.sv, rgb_ui_renderer.sv]
2026-11-02 Record user board acceptance of final complete instrument release
